eSpark-Backup/franciscogimenez-hcdshardware/Documents/Dev-Shared-Files/Optical-Sensor-PCB/Deliverables/Randring/Top View.png

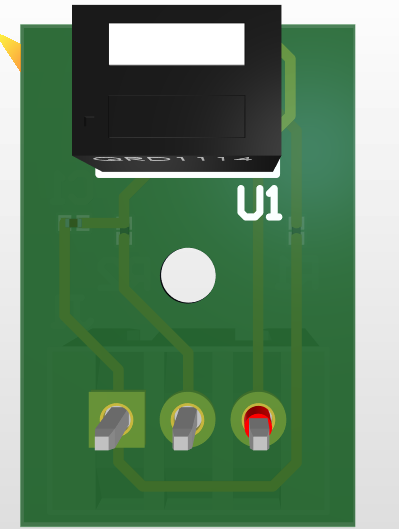
Documents/Dev-Shared-Files/Optical-Sensor-PCB/Deliverables/Randring/Top View.png
