eSpark-Backup/franciscogimenez-hcdshardware/README.md

# FranciscoGimenez-HCDS
 To interface and test various sensors and peripherals provided by the client with ESP32. To develop a Hair Color Dispensing Product.
