eSpark-Backup/franciscogimenez-hcdshardware/Design-Files/HCD_PCB.PcbDoc.htm

Reporting Options

# File in Previous Format

Date | : | 11/20/2021
Time | : | 1:56:20 AM
Filename | : | D:\Github\FranciscoGimenez-HCDSHardware\Design-Files\HCD_PCB.PcbDoc

Version | Warning

This file was generated by an earlier version of the software
