eSpark-Backup/franciscogimenez-hcdshardware/Documents/Client-Shared-Files/ESPProject_updated/Specs for  Firmware.docx

GENERAL PROJECT DESCRIPTION:

The purpose of the device is to dispense and measure with a scale different ingredients. The device will have 11 different cartridges loaded into a rotating tray that moves using a stepper motor so that the right cartridge can be positioned above a scale. The cartridges loaded into this rotating tray are activated by a pin that moves horizontally and powered by a servo motor. The load sensor/scale measures the weight of the product being dispensed and controls the servo motor movement and therefore the force applied to the cartridge to regulate the dispensing flow rate depending on the desired weight of such specific ingredient. Each cartridge has an RFID tag for identification.

The rotating tray that holds the cartridges has a light colored stripe for each cartridge position. In order for the pin to precisely activate the cartridge the light colored stripe needs to align with a stationary optical sensor. This way the stepper motor that controls the rotation of the tray can make sure the tray is in the perfect position before activating the servo motor that pushes the pin to activate the dispensing.

There needs to be a function to index the ingredients loaded into the rotating tray. Each cap of the cartridge has an RFID tag indicating the ingredient type from (1-11). In close proximity there is an RFID reader that will retrieve the data from the tags contained in each cartridge. The position of such each ingredient will be determined by reading the tags and keeping a record of the position in degrees (0-360)

Separately, there is a second RFID reader located nearby the scale that will help insure that the dispensing only happens when there is a container present that has also the appropriate RFID tag.

The device will have an LCD touchscreen for interaction but it should also be controllable with an external mobile app. The device will also need to be able to connect to a Wifi network to be able to pass reports to be stored in the cloud.

The device also has an LED strip to be able to light the interior of the dispensing area and change color dynamically. For example, glow red/orange while dispensing and green or white when dispensing is finished.

The device will also have a microphone and speaker. The speaker could augment the user experience by beeping for different reasons. For example, after it's done dispensing.

Eventually there is the potential of leveraging Amazon’s AWS Lexa service to build into the device the capability of being voice activated. This part will require a live web conexion and there needs to be enough memory built-in to store a few seconds of speech before submitting a query to the web.

The device should be able to take 220/110 V to be able to work in Europe/Asia and the US. It will also need to be able to run on a rechargeable battery.

CAD drawings for the device have been already created. This project consists in dealing with the electronics components that operate the device.

SPECIFIC REQUEST FOR REGARDING ELECTRICAL ENGINEERING FOR THIS

PROJECT

Create the firmware to Perform Basic Operations as described below.

PRESELECTED COMPONENTS:

Below is the list of electronic components preselected for this project (details in Appendix A):

1. Microcontroller with Wi-Fi / Bluetooth Module
2. Power Supply / Battery Pack
3. LCD Touchscreen
4. Load Cell (Scale) and Amplifier (HX711 )
5. Stepper Motor and Micro stepper Controller (A4988 )
6. Servo motor
7. Speaker and Amplifier (LM386 )
8. RFID Reader (MFRC-522)
9. Optical Sensor
10. Microphone
11. LED Strip
12. Battery/Battery Balancer

Many of these components have been already specified in the previous PCB board design rather than as separate modular components.

For safety and for ease of certification (UL, CE, etc), it has been determined that the battery balancer should not be integrated into the PCB board but bought and included as a separate system.

BASIC OPERATIONS:

1. INDEXING. Create a function that Identifies the position (degrees 0-360) of the rotating tray based on the RFID tags of the cartridges and the optical sensor.
2. ROTATION. Create a function that allows you to enter in the number of degrees to rotate the tray and then activate the stepper motor to rotate the tray accordingly. Positive degrees would be for a clockwise (CW) rotation and negative numbers would be for a counter-clockwise (CCW) rotation.
3. PUSH PIN. Create a function that controls the movement of push that activates the cartridges.

This is done mechanically by the rotation of the servo that gets transferred into a linear motion.

4. WEIGHT FUNCTION. Create a scale function that receives weight signals from the load cell and displays them. Enable a tare function to account for the weight of the container above the load cell.
5. WRITE RFID. Create a function to write the RFID tags of the cartridges to allows to name each ingredient by name (i.e. Ingredient 1, Ingredient 2, etc) and quantity supplied.
6. READ RFID. Create a function to read the RFID tags and create an index of the ingredients number and its position in the tray. For example, the Index should be (Position 1 = Ingredient 3; Position 2 = Ingredient 2, etc, etc).
7. LIGHT FUNCTION. Create a function to control the LED strip. From color to duration of time lit.
8. CONTAINER RFID. Detect the presence of a container in the dispensing area (above the scale).
9. DISPENSE FUNCTION. Enter a desired target weight and ingredient number, rotate the tray to the correct dispensing position, set the scale to zero (tare), activate the servo motor of the actuator and stop it once the weight dispensed matches the weight in the input. Make a bip sound once complete. Ensure that no dispensing happens if the container is not present.
10. A version of point 10 but where the control happens from an mobile app and through a bluetooth connection.
11. A function that reports to the cloud the activity of the machine via a wifi connection.
12. UPDATE. Ability to perform over-the-air firmware updates.

# APPENDIX A

Detailed List of Components

Component | Details
Controller | https://www.amazon.com/HiLetgo-ESP-WROOM-32-Developm ent-Microcontroller-Integrated/dp/B0718T232Z (https://www.amazon.com/HiLetgo-ESP-WROOM-32-Development-Microcontroller-Integrated/dp/B0718T232Z)
LCD Touchscreen | 4.3”: https://www.aliexpress.com/item/4000450731303.html?spm=a 2g0o.productlist.0.0.3da22136zIOfG6 (https://www.aliexpress.com/item/4000450731303.html)
Load Cell (Measuring Weight) | 500 grams: https://www.alibaba.com/product-detail/100g-300g-500g-750gminiature-parallel_60666665767.html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 (https://www.alibaba.com/product-detail/100g-300g-500g-750g-miniature-parallel_60666665767.html)ist.0.0.476e6cfeo5HiHu (https://www.alibaba.com/product-detail/100g-300g-500g-750g-miniature-parallel_60666665767.html) (https://www.alibaba.com/product-detail/100g-300g-500g-750g-miniature-parallel_60666665767.html) Load Cell amplifier: https://www.aliexpress.com/item/32883776006.html?spm=a2g 0o.productlist.0.0.43a949beDLp4Ob (https://www.aliexpress.com/item/32883776006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
Stepper Motor (Rotating the Tray) Controlling | Stepper: https://www.aliexpress.com/item/32665922113.html?spm=a2g 0o.productlist.0.0.2b1f30acFWCy7A (https://www.aliexpress.com/item/32665922113.html) (https://www.aliexpress.com/item/32665922113.html)Micro controller for: https://www.aliexpress.com/item/32965199683.html?spm=a2g 0o.productlist.0.0.267569c6dTM09J (https://www.aliexpress.com/item/32965199683.html?spm=a2g0o.productlist.0.0.267569c6dTM09J)
Servo | https://www.alibaba.com/product-detail/DS3218MG-20KG-Wat erproof-Large-Torque-High_62237690585.html (https://www.alibaba.com/product-detail/DS3218MG-20KG-Waterproof-Large-Torque-High_62237690585.html) (https://www.alibaba.com/product-detail/DS3218MG-20KG-Waterproof-Large-Torque-High_62237690585.html)
Speaker (Sound Communication) | Speaker:

| https://www.aliexpress.com/item/33014725969.html?spm=a2g 0o.productlist.0.0.eb482789MwjQHn (https://www.aliexpress.com/item/33014725969.html) Amplifier: https://www.aliexpress.com/item/4000232274017.html?spm=a 2g0o.productlist.0.0.7d2e7e22AxVb64 (https://www.aliexpress.com/item/4000232274017.html) (https://www.aliexpress.com/item/4000232274017.html)
Optical Sensor (Rotating Tray Position) | https://www.sparkfun.com/datasheets/BOT/QRD1 114.pdf (https://www.sparkfun.com/datasheets/BOT/QRD1114.pdf)
RFID Reader 2x (Identify Cartridges) (Receptacle Sensor) | https://www.aliexpress.com/item/2026446641.html?spm=a2g0 o.productlist.0.0.562052630OgIg8 (https://www.aliexpress.com/item/2026446641.html) (https://www.aliexpress.com/item/2026446641.html)
Sound Sensor (Microphone) Sound Sensor | https://www.aliexpress.com/item/32676696291.html?spm=a2g0o .productlist.0.0.3cfa751beddDXc (https://www.aliexpress.com/item/32676696291.html)
Battery: (To confirm final capacity and specs based on further analysis) | Battery: https://www.alibaba.com/product-detail/2200mAh-3 S-25C-Lipo-Pack_62061430079.html or https://www.amazon.com/Gens-ace-Battery-2200m Ah-Airplane/dp/B00WJN4LG0/ref=sr_1_6 Balancer: https://www.aliexpress.com/item/4000785403888.html?spm=a2g 0o.productlist.0.0.f59c67deehvNsY (https://www.aliexpress.com/item/4000785403888.html?spm=a2g0o.productlist.0.0.f59c67deehvNsY) Or
| https://www.amazon.com/11-1V-12-6V-Balance-Bat er%C3%ADa-Protecci%C3%B3n/dp/B07JMY631D/ (https://www.amazon.com/11-1V-12-6V-Balance-Bater%C3%ADa-Protecci%C3%B3n/dp/B07JMY631D)ref=sr_1_1?crid=2RRWIV3KTM23M (https://www.amazon.com/11-1V-12-6V-Balance-Bater%C3%ADa-Protecci%C3%B3n/dp/B07JMY631D)
Power Switch (On/off) | https://www.aliexpress.com/item/4000498062517.ht ml?spm=a2g0o.productlist.0.0.69384c247Y0dyb (https://www.aliexpress.com/item/4000498062517.html?spm=a2g0o.productlist.0.0.69384c247Y0dyb) (https://www.aliexpress.com/item/4000498062517.html?spm=a2g0o.productlist.0.0.69384c247Y0dyb)
LED Strip | https://www.aliexpress.com/item/2036819167.html? spm=a2g0o.productlist.0.0.719c1cbfZYLGJI (https://www.aliexpress.com/item/2036819167.html?spm=a2g0o.productlist.0.0.719c1cbfZYLGJI) (https://www.aliexpress.com/item/2036819167.html?spm=a2g0o.productlist.0.0.719c1cbfZYLGJI)
