eSpark-Backup/franciscogimenez-hcdshardware/Documents/Deliverables/Rendering/2D_BottomView.PNG

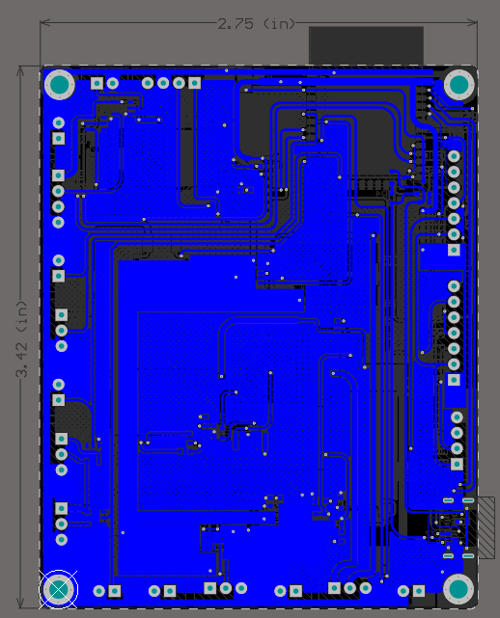
Documents/Deliverables/Rendering/2D_BottomView.PNG
