eSpark-Backup/franciscogimenez-hcdshardware/Documents/Deliverables/Rendering/2D_TopView.PNG

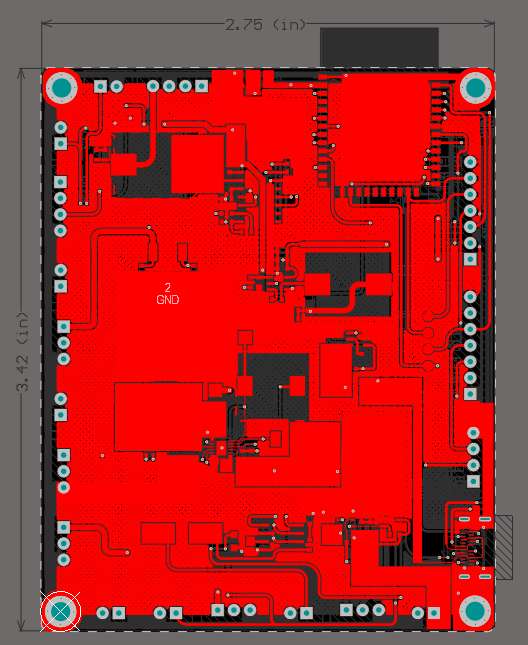
Documents/Deliverables/Rendering/2D_TopView.PNG
