eSpark-Backup/franciscogimenez-hcdshardware/Documents/Deliverables/Rendering/3D_BottomView.PNG

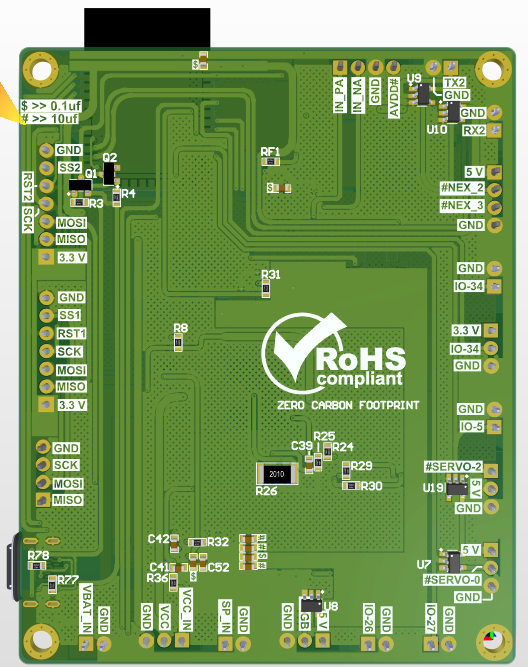
Documents/Deliverables/Rendering/3D_BottomView.PNG
