eSpark-Backup/franciscogimenez-hcdshardware/Documents/Deliverables/Rendering/3D_IsometricView.PNG

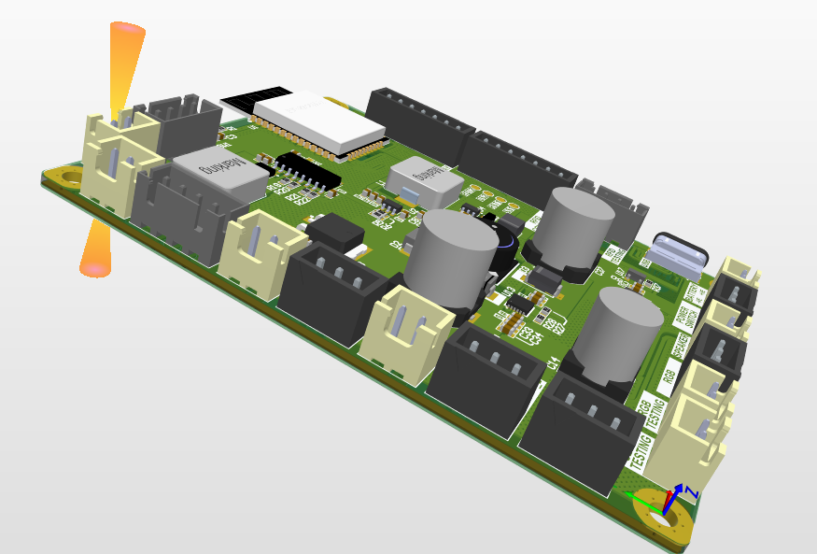
Documents/Deliverables/Rendering/3D_IsometricView.PNG
