eSpark-Backup/franciscogimenez-hcdshardware/Documents/Deliverables/Rendering/3D_TopView.PNG

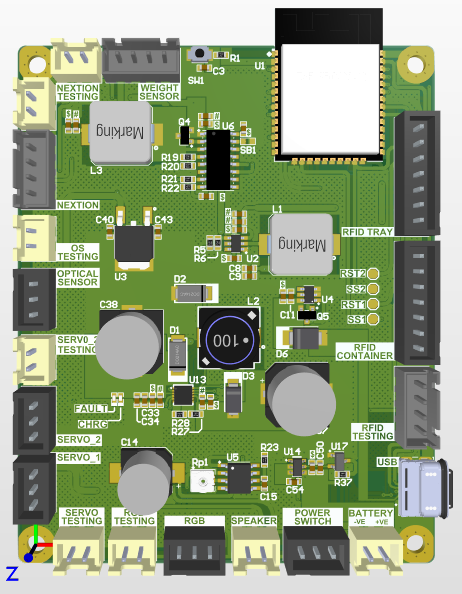
Documents/Deliverables/Rendering/3D_TopView.PNG
