eSpark-Backup/franciscogimenez-hcdshardware/Documents/Deliverables_OB/Randring/Isometric View.png

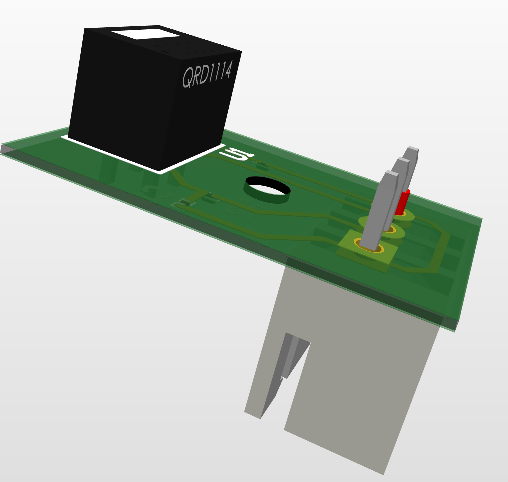
Documents/Deliverables_OB/Randring/Isometric View.png
