eSpark-Backup/franciscogimenez-hcdshardware/Documents/Deliverables_PB/Renderings/2D_BottomView.PNG

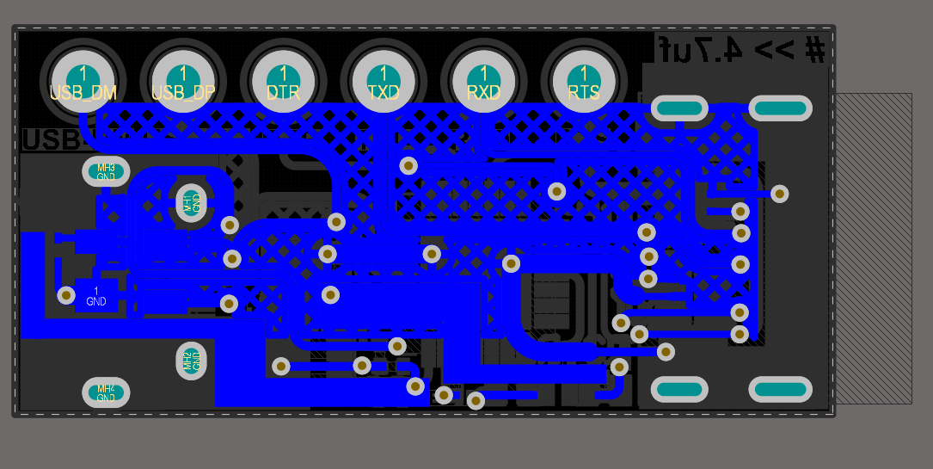
Documents/Deliverables_PB/Renderings/2D_BottomView.PNG
