eSpark-Backup/franciscogimenez-hcdshardware/Documents/Deliverables_PB/Renderings/2D_TopView.PNG

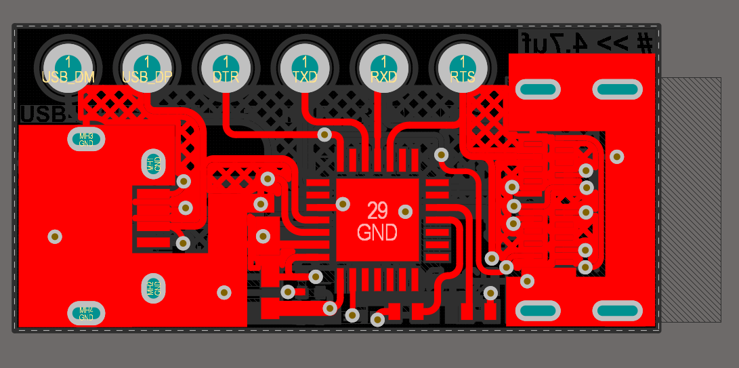
Documents/Deliverables_PB/Renderings/2D_TopView.PNG
