eSpark-Backup/franciscogimenez-hcdshardware/Documents/Deliverables_PB/Renderings/3D_BottomView.PNG

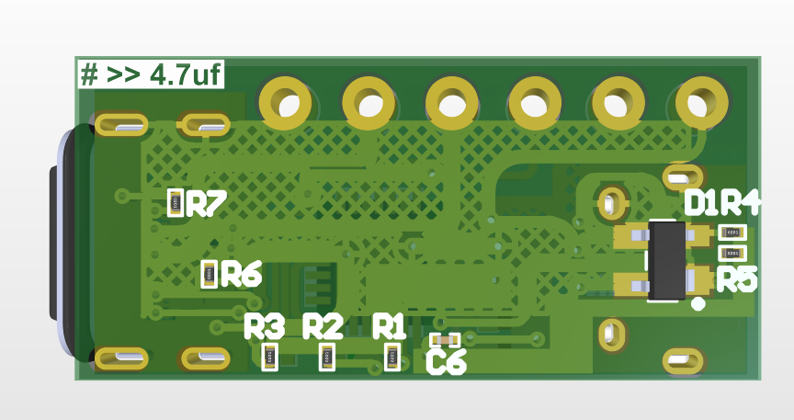
Documents/Deliverables_PB/Renderings/3D_BottomView.PNG
