eSpark-Backup/franciscogimenez-hcdshardware/Documents/Deliverables_PB/Renderings/3D_IsometricView.PNG

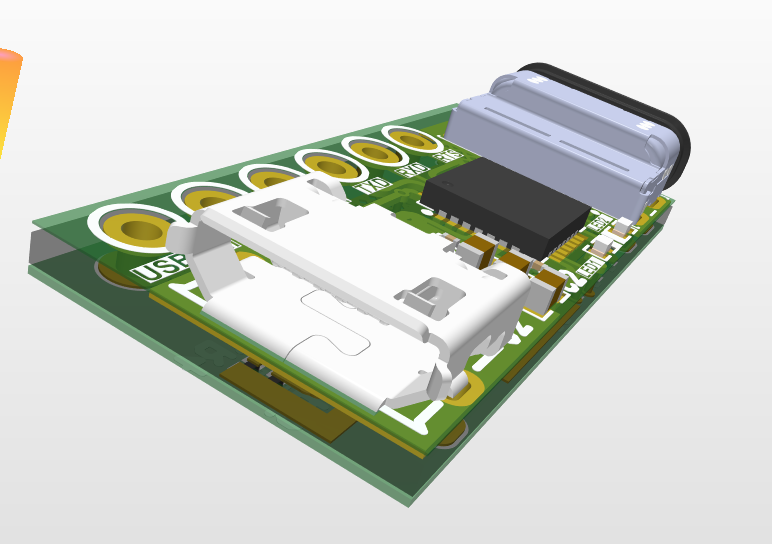
Documents/Deliverables_PB/Renderings/3D_IsometricView.PNG
