eSpark-Backup/franciscogimenez-hcdshardware/Documents/Deliverables_PB/Renderings/3D_TopView.PNG

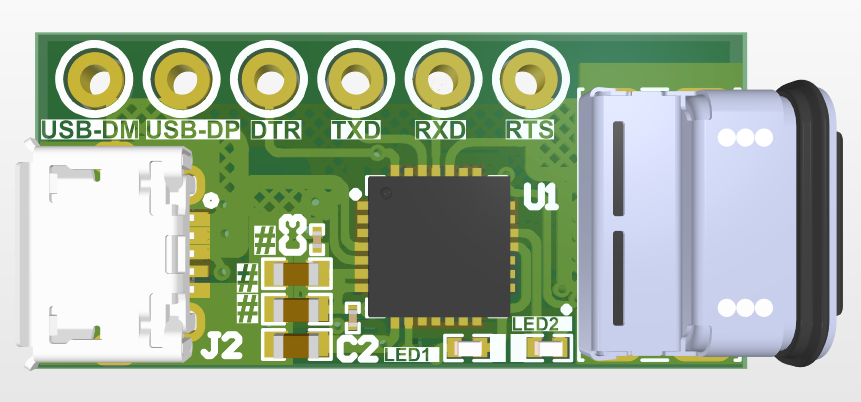
Documents/Deliverables_PB/Renderings/3D_TopView.PNG
