eSpark-Backup/franciscogimenez-hcdshardware/Documents/Deliverables/BOM/BOM_PCBWay.xlsx

Bill of Material (BOM) for Francisco Gimenez
S. No. | Components | Description | Designator | Footprint (Package) | LCSC Part No | Value | LCSC/MOQ | Quantity (Per Board) | Quantity (5 boards)
1 | Capacitors | CAP CER 0.1UF 50V X7R 0603 | C1, C6, C7, C12, C17, C18, C21, C32, C36, C51, C53, C55, CF1, CF3 | CAP-0603 | C913912 | 0.1uF | 50 | 14 | 100
2 |  | CAP CER 1UF 25V X5R 0603 | C3, C11, C39, C41, C43, C50, C52 | CAP-0603 | C5673 | 1uF | 50 | 7 | 35
3 |  | CAP CER 10UF 25V X5R 0603 | C4, C5, C13, C16, C19, C20, C31, C35, CF2 | CAP-0603 | C386081 | 10uF | 10 | 9 | 50
4 |  | CAP CER 22UF 16V X5R 0603 | C8, C9 | CAP-0603 | C84419 | 22uF | 10 | 2 | 20
5 |  | CAP CER 10PF 50V C0G/NP0 0603 | C15 | CAP-0603 | C106245 | 10pF | 50 | 1 | 5
6 |  | CAP CER 4.7UF 25V X5R 0603 | C33, C34 | CAP-0603 | C69335 | 4.7uF | 20 | 2 | 10
7 |  | CAP ALUM 100UF 20% 25V SMD | C14 | Custom | C125982 | 100uF | 5 | 1 | 10
8 |  | CAP ALUM 470UF 20% 25V SMD | C37, C38 | Custom | C249933 | 470uF | 1 | 2 | 12
9 |  | CAP CER 2.2UF 25V X5R 0603 | C40 | CAP-0603 | C309478 | 2.2uF | 20 | 1 | 20
10 |  | CAP CER 1000PF 25V C0G/NPO 0603 | C42, C54 | CAP-0603 | C163170 | 1nF | 100 | 2 | 10
11 | Diode | DIODE SCHOTTKY 40V 3A SMA | D1, D2 | DO-214AC | C85098 | - | 5 | 2 | 15
12 |  | DIODE GEN PURP 50V 1A SMA | D3 | SMA | C150735 | - | 10 | 1 | 5
13 |  | LED GREEN CLEAR CHIP SMD | D4, D5 | LED 0402 | C434446 | - | 50 | 2 | 10
14 |  | DIODE SCHOTTKY 5A 40V SMB | D6 | SMB | C32513 | - | 10 | 1 | 5
15 |  | FIXED IND 10UH 2.5A 43.7 MOHM | L2 | Custom | C96116 | 10uH | 1 | 1 | 5
16 | Transistor | TRANS NPN 40V 0.6A SMD SOT23-3 | Q1, Q2 | SOT-23 | C94515 | - | 50 | 2 | 10
17 |  | MOSFET P-CH 12V 2.6A SUPERSOT3 | Q5 | SuperSOT-3 | C154510 | - | 1 | 1 | 6
18 |  | TRANS PNP 40V 600MA SOT23-3 | Q4 | SOT-23 | C75556 | - | 50 | 1 | 5
19 | Resistors | RES SMD 10K OHM 5% 1/5W 0603 | R1, R3, R4, R6, R31, R32, RF1 | RES-0603 | C161787 | 10K | 10 | 7 | 40
20 |  | RES SMD 54.9K OHM 1% 1/10W 0603 | R5 | RES-0603 | C185321 | 54.9K | 100 | 1 | 5
21 |  | RES SMD 470K OHM 5% 1/10W 0603 | R8 | RES-0603 | C144601 | 470K | 100 | 1 | 5
22 |  | RES SMD 100K OHM 5% 1/5W 0603 | R25, R36, R37 | RES-0603 | C491207 | 100K | 20 | 3 | 15
23 |  | RES SMD 20K OHM 1% 1/4W 0603 | R19 | RES-0603 | C105575 | 20K | 100 | 1 | 5
24 |  | RES SMD 8.2K OHM 5% 1/4W 0603 | R20 | RES-0603 | C445835 | 8.2K | 20 | 1 | 5
25 |  | RES SMD 100 OHM 1% 1/4W 0603 | R21, R22, R23 | RES-0603 | C491196 | 100R | 20 | 3 | 15
26 |  | RES SMD 301K OHM 1% 1/10W 0603 | R24 | RES-0603 | C23026 | 301k | 100 | 1 | 5
27 |  | RES 0.05 OHM 1% 1/2W 2010 | R26 | RES 2010 | C309643 | 0.05R | 10 | 1 | 5
28 |  | RES SMD 536K OHM 1% 1/10W 0603 | R27 | RES-0603 | C23200 | 536K | 100 | 1 | 5
29 |  | RES SMD 453K OHM 1% 1/10W 0603 | R28 | RES-0603 | C25818 | 453K | 100 | 1 | 5
30 |  | RES 5.1K OHM 1% 1/10W 0603 | R29, R30, R77, R78 | RES-0603 | C156350 | 5.1K | 100 | 4 | 20
31 | Switch | SWITCH TACTILE SPST-NO 0.05A 12V | SW1 | Custom | C231329 | - | 1 | 1 | 5
32 | ICS | RX TXRX MOD WIFI SURFACE MOUNT | U1 | Custom | C529577 | - | 1 | 1 | 5
33 |  | IC OR CTRLR SRC SELECT TSOT23-6 | U4 | TSOT-23-6 | C521306 | - | 1 | 1 | 5
34 |  | IC AMP AUDIO PWR .325W AB 8SOIC | U5 | 8SOIC | C23573 | - | 1 | 1 | 5
35 |  | LOAD CELL AMP HX711 | U6 | SOP-16 | C43656 | - | 1 | 1 | 5
36 |  | IC BUF NON-INVERT 5.5V SOT23-5 | U7, U8, U9, U10, U19 | SOT-23-5 | C100024 | - | 1 | 5 | 25
37 |  | IC PWR SWITCH P-CHAN 1:1 6TSOP | U14 | 6-TSOP | C141534 | - | 1 | 1 | 5
38 | Connectors | CONN HEADER VERT 2POS 2.5MM | J1, J3, J24, J25, J26, J27, J28, J29 | Custom | C158012 | - | 20 | 8 | 40
39 |  | CONN HEADER VERT 4POS 2.5MM | J2, J12, J17 | Custom | C144395 | - | 1 | 3 | 15
40 |  | CONN HEADER VERT 3POS 2.5MM | J10, J11, J13, J20, J30 | Custom | C144394 | - | 10 | 5 | 30
41 |  | CONN HEADER VERT 7POS 2.5MM | J14, J15 | Custom | C144398 | - | 5 | 2 | 10
42 |  | CONN RCP USB3.1 TYPEC 24P SMD RA | J16 | Custom | C498674 | - | 1 | 1 | 5
