eSpark-Backup/franciscogimenez-hcdshardware/Documents/Deliverables/BOM/Digikey_BOM.xlsx

Bill of Material (BOM) for Francisco Gimenez
S. No. | Components | Description | Designator | Footprint (Package) | Manufacturer Part Number | Manufacturer | Alternate | Value | Quantity (Per Board) | Quantity 5 | DigiKey Link | Unit Cost(1) | Total Cost(1) | Unit Cost (5 Boards) | Total Cost (5) | Remarks
1 | Capacitors | CAP CER 0.1UF 50V X7R 0603 | C1, C11, C13, C14, C15, C17, C21, C32, C36, C51, C53, CF1, CF3 | CAP-0603 | CL10B104KB8NNNL | Samsung Electro-Mechanics (https://lcsc.com/brand-detail/254.html) | --------------- | 0.1uF | 13 | 65 | Digikey (https://www.digikey.com/en/products/detail/samsung-electro-mechanics/CL10B104KB8NNNL/3894274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) | $0.0300 | $0.39 | $0.0166 | $1.08
2 |  | CAP CER 1UF 25V X5R 0603 | C3, C11, C39, C50, C52, CF1. CF3 | CAP-0603 | CL10A105KA8NNNC | Samsung Electro-Mechanics (https://lcsc.com/brand-detail/254.html) | --------------- | 1uF | 7 | 35 | Digikey (https://www.digikey.com/en/products/detail/samsung-electro-mechanics/CL10A105KA8NNNC/3886760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) | $0.1000 | $0.70 | $0.0350 | $1.23
 |  | CAP CER 2.2UF 25V X5R 0603 | C5 | CAP-0603 | CC0603KRX5R8BB225 | Yageo | --------------- | 2.2uF | 1 | 5 | DigiKey (https://www.digikey.com/en/products/detail/yageo/CC0603KRX5R8BB225/5195194) | $0.4000 | $0.40 | $0.4000 | $2.00
3 |  | CAP CER 10UF 25V X5R 0603 | C6, C7, C12, C31, C35, CF2 | CAP-0603 | TMK107BBJ106MA-T | Taiyo Yuden (https://lcsc.com/brand-detail/392.html) | GRM188R61E106MA73J | 10uF | 6 | 30 | Digikey (https://www.digikey.com/en/products/detail/murata-electronics/GRM188R61E106MA73J/4905347) | $0.3600 | $2.16 | $0.2460 | $7.38
6 |  | CAP CER 4.7UF 25V X5R 0603 | C33, C34 | CAP-0603 | CL10A475KA8NQNC | Samsung Electro-Mechanics (https://lcsc.com/brand-detail/254.html) | --------------- | 4.7uF | 2 | 10 | Digikey (https://www.digikey.com/en/products/detail/samsung-electro-mechanics/CL10A475KA8NQNC/3887558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) | $0.3900 | $0.78 | $0.2700 | $2.70
7 |  | CAP ALUM 100UF 20% 25V SMD | C42, C54 | Custom | UWX1E101MCL1GB | Nichicon (https://lcsc.com/brand-detail/994.html) | --------------- | 100uF | 2 | 10 | Digikey (https://www.digikey.com/en/products/detail/nichicon/UWX1E101MCL1GB/589854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) | $0.5000 | $1.00 | $0.3480 | $3.48
8 |  | CAP ALUM 470UF 20% 25V SMD | C37, C38 | Custom | UCD1E471MNL1GS | Nichicon (https://lcsc.com/brand-detail/994.html) | EXV477M025A9PAA | 470uF | 2 | 10 | Digikey (https://www.digikey.com/en/products/detail/kemet/EXV477M025A9PAA/7319818) | $0.9700 | $1.94 | $0.7390 | $7.39
10 | Diode | DIODE SCHOTTKY 40V 3A SMA | D1, D2 | DO-214AC | CMSH3-40MA TR13 PBFREE | Central Semiconductor Corp (https://www.digikey.com/en/supplier-centers/central-semiconductor) | --------------- | - | 2 | 10 | Digikey (https://www.digikey.com/en/products/detail/central-semiconductor-corp/CMSH3-40MA-TR13-PBFREE/4897045) | $0.6700 | $1.34 | $0.5920 | $5.92
11 |  | DIODE GEN PURP 50V 1A SMA | D3 | SMA | S1A-13-F | Diodes Incorporated (https://lcsc.com/brand-detail/296.html) | --------------- | - | 1 | 5 | Digikey (https://www.digikey.com/en/products/detail/diodes-incorporated/S1A-13-F/749977) | $0.2700 | $0.27 | $0.2600 | $1.30
12 |  | LED GREEN CLEAR CHIP SMD | D4, D5 | LED 0402 | XZVG68W-2 | SunLED (https://www.digikey.com/en/supplier-centers/sunled) | --------------- | - | 2 | 10 | Digikey (https://www.digikey.com/en/products/detail/sunled/XZVG68W-2/4745975?s=N4IgTCBcDaIBoC0BqBxAbADgOoFoIF0BfIA) | $0.3700 | $0.74 | $0.2930 | $2.93
13 |  | DIODE SCHOTTKY 5A 40V SMB | D6 | SMB | SS54B-HF | Comchip Technology | --------------- | - | 1 | 5 | Mouser (https://eu.mouser.com/ProductDetail/Comchip-Technology/SS54B-HF) | $0.4440 | $0.44 | $0.4440 | $2.22
 | LED | Yellow 2 x 1.25 x 1.1 mm 130° Water Clear 112 mcd 1.8 V LED Surface Mount | LED1 | LED 0805 | LTST-C170KSKT | Vishay Lite-On | --------------- | - | 1 | 5 | DigiKey (https://www.digikey.com/en/products/detail/lite-on-inc/LTST-C170KSKT/386781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) | $0.3100 | $0.31 | $0.3100 | $1.55
 |  | LED BLUE 0805 SMD | LED2 | LED 0805 | 17-21/BHC-XL2M2TY/3T | Everlight Elec | --------------- | - | 1 | 5 | Custom Supplier | $0.2560 | $0.26 | $0.2560 | $1.28
 |  | LED GREEN 574nm 2-Pin Chip 0805 SMD | LED3 | LED 0805 | LTST-C171KGKT | Vishay Lite-On | --------------- | - | 1 | 5 | DigiKey | $0.2800 | $0.28 | $0.2800 | $1.40
14 | Inductor | FIXED IND 3.3UH 8A 11.8 MOHM SMD | L1 | Custom | 74437368033 | Würth Elektronik (https://www.digikey.com/en/supplier-centers/wurth-electronics) | --------------- | 3.3uH | 1 | 5 | Digikey (https://www.digikey.com/en/products/detail/w%C3%BCrth-elektronik/74437368033/2791109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) | $2.4100 | $2.41 | $2.4100 | $12.05
15 |  | FIXED IND 10UH 2.5A 43.7 MOHM | L2 | Custom | SLF10145T-100M2R5-PF | TDK Corporation (https://www.digikey.com/en/supplier-centers/tdk) | --------------- | 10uH | 1 | 5 | Digikey (https://www.digikey.com/en/products/detail/tdk-corporation/SLF10145T-100M2R5-PF/755327) | $1.0500 | $1.05 | $1.0500 | $5.25
16 | Transistor | TRANS NPN 40V 0.6A SMD SOT23-3 | Q1, Q2 | SOT-23 | MMBT2222A-7-F | Diodes Incorporated (https://lcsc.com/brand-detail/296.html) | --------------- | - | 2 | 10 | Digikey (https://www.digikey.com/en/products/detail/diodes-incorporated/MMBT2222A-7-F/814503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) | $0.1400 | $0.28 | $0.1250 | $1.25
17 |  | MOSFET P-CH 12V 2.6A SUPERSOT3 | Q4 | SuperSOT-3 | FDN306P | ON Semiconductor | --------------- | - | 1 | 5 | Digikey (https://www.digikey.com/en/products/detail/on-semiconductor/FDN306P/965300?s=N4IgTCBcDaIGIBEByBmADANgAogLoF8g) | $0.5000 | $0.50 | $0.5000 | $2.50
18 |  | TRANS PNP 40V 600MA SOT23-3 | Q3 | SOT-23 | MMBT4403LT1G | ON Semiconductor (https://lcsc.com/brand-detail/94.html) | --------------- | - | 1 | 5 | Digikey (https://www.digikey.com/en/products/detail/on-semiconductor/MMBT4403LT1G/919609) | $0.1400 | $0.14 | $0.1400 | $0.70
19 | Resistors | RES SMD 10K OHM 5% 1/5W 0603 | R3, R4, R11, R12, R13, R32, RF1 | RES-0603 | CRGH0603J10K | TE Connectivity Passive Product (https://www.digikey.com/en/supplier-centers/te-connectivity-amp) | --------------- | 10K | 7 | 35 | Digikey (https://www.digikey.com/en/products/detail/te-connectivity-passive-product/CRGH0603J10K/2385379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) | $0.1000 | $0.70 | $0.0580 | $2.03
20 |  | RES SMD 54.9K OHM 1% 1/10W 0603 | R8 | RES-0603 | RC0603FR-0754K9L | YAGEO (https://lcsc.com/brand-detail/396.html) | --------------- | 54.9K | 1 | 5 | Digikey (https://www.digikey.com/en/products/detail/yageo/RC0603FR-0754K9L/727298) | $0.1000 | $0.10 | $0.1000 | $0.50
21 |  | RES SMD 470K OHM 5% 1/10W 0603 | R14 | RES-0603 | AC0603JR-07470KL | YAGEO (https://lcsc.com/brand-detail/396.html) | --------------- | 470K | 1 | 5 | Digikey (https://www.digikey.com/en/products/detail/yageo/AC0603JR-07470KL/5896462) | $0.1000 | $0.10 | $0.1000 | $0.50
 |  | RES 0.1W, 470½, 0.1%, 0603, RoHS | R16 | RES-0603 | ERA3VEB4700V | Panasonic | --------------- | 470R | 1 | 5 | DigiKey (https://www.digikey.com/en/products/detail/panasonic-electronic-components/ERA-3VEB4700V/12085013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) | $0.6100 | $0.61 | $0.6100 | $3.05
22 |  | RES SMD 100K OHM 5% 1/5W 0603 | R6, R36, R37 | RES-0603 | CRGH0603J100K | TE Connectivity Passive Product (https://www.digikey.com/en/supplier-centers/te-connectivity-amp) | --------------- | 100K | 3 | 15 | Digikey (https://www.digikey.com/en/products/detail/te-connectivity-passive-product/CRGH0603J100K/2385403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) | $0.1000 | $0.30 | $0.0490 | $0.73
23 |  | RES SMD 20K OHM 1% 1/4W 0603 | R2 | RES-0603 | ESR03EZPF2002 | Rohm Semiconductor (https://www.digikey.com/en/supplier-centers/rohm-semi) | --------------- | 20K | 1 | 5 | Digikey (https://www.digikey.com/en/products/detail/rohm-semiconductor/ESR03EZPF2002/1983437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) | $0.1300 | $0.13 | $0.1300 | $0.65
24 |  | RES SMD 8.2K OHM 5% 1/4W 0603 | R7 | RES-0603 | ERJ-PA3J822V | Panasonic Electronic Components (https://www.digikey.com/en/supplier-centers/panasonic) | --------------- | 8.2K | 1 | 5 | Digikey (https://www.digikey.com/en/products/detail/panasonic-electronic-components/ERJ-PA3J822V/5036103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) | $0.1000 | $0.10 | $0.1000 | $0.50
25 |  | RES SMD 100 OHM 1% 1/4W 0603 | R1, R9, R10, R15 | RES-0603 | RCA0603100RFKEAHP | Vishay Dale (https://www.digikey.com/en/supplier-centers/vishay-dale) | --------------- | 100R | 4 | 20 | Digikey (https://www.digikey.com/en/products/detail/vishay-dale/RCA0603100RFKEAHP/6561241) | $0.2400 | $0.96 | $0.2050 | $4.10
26 |  | RES SMD 301K OHM 1% 1/10W 0603 | R5 | RES-0603 | CRCW0603301KFKEB | Vishay Dale (https://www.digikey.com/en/supplier-centers/vishay-dale) | --------------- | 301k | 1 | 5 | Digikey (https://www.digikey.com/en/products/detail/vishay-dale/CRCW0603301KFKEB/5072030) | $0.1000 | $0.10 | $0.1000 | $0.50
27 |  | RES 0.05 OHM 1% 1/2W 2010 | R26 | RES 2010 | WSL2010R0500FEA | Vishay Dale | --------------- | 0.05R | 1 | 5 | Digikey (https://www.digikey.com/en/products/detail/vishay-dale/WSL2010R0500FEA/712531) | $0.9200 | $0.92 | $0.9200 | $4.60
28 |  | RES SMD 536K OHM 1% 1/10W 0603 | R27 | RES-0603 | CRCW0603536KFKEA | Vishay Dale (https://www.digikey.com/en/supplier-centers/vishay-dale) | --------------- | 536K | 1 | 5 | Digikey (https://www.digikey.com/en/products/detail/vishay-dale/CRCW0603536KFKEA/1174979) | $0.1000 | $0.10 | $0.1000 | $0.50
29 |  | RES SMD 453K OHM 1% 1/10W 0603 | R28 | RES-0603 | RC0603FR-07453KL | Yageo (https://www.digikey.com/en/supplier-centers/yageo) | --------------- | 453K | 1 | 5 | Digikey (https://www.digikey.com/en/products/detail/yageo/RC0603FR-07453KL/727247) | $0.1000 | $0.10 | $0.1000 | $0.50
30 |  | RES 5.1K OHM 1% 1/10W 0603 | R29, R30, R77, R78 | RES-0603 | RMCF0603FT5K10 | Stackpole Electronics Inc (https://www.digikey.com/en/supplier-centers/stackpole-electronics) | --------------- | 5.1K | 4 | 20 | Digikey (https://www.digikey.com/en/products/detail/stackpole-electronics-inc/RMCF0603FT5K10/1760908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) | $0.1000 | $0.40 | $0.0170 | $0.34
32 | Switch | SWITCH TACTILE SPST-NO 0.05A 12V | SW1 | Custom | B3U-1000P | Omron Electronics Inc-EMC Div | --------------- | - | 1 | 5 | Digikey (https://www.digikey.com/en/products/detail/omron-electronics-inc-emc-div/B3U-1000P/1534338) | $0.9300 | $0.93 | $0.9300 | $4.65
33 | ICS | RX TXRX MOD WIFI SURFACE MOUNT | U1 | Custom | ESP32-WROOM-32D (8MB) | Espressif Systems (https://lcsc.com/brand-detail/877.html) | --------------- | - | 1 | 5 | Digikey (https://www.digikey.com/en/products/detail/espressif-systems/ESP32-WROOM-32D-8MB/9381717) | $4.3500 | $4.35 | $4.3500 | $21.75
34 |  | IC REG BUCK ADJ 5A TSOT23-6 | U3 | SOT 23-6 | TPS565208DDCT | Texas Instruments (https://www.digikey.com/en/supplier-centers/texas-instruments) | --------------- | - | 1 | 5 | AliExpress (https://www.aliexpress.com/item/4000994283828.html) | $3.7100 | $3.71 | $3.7100 | $18.55
35 |  | IC REG LINEAR 3.3V 1A DPAK | U2 | DPAK | LDF33DT-TR | STMicroelectronics (https://www.digikey.com/en/supplier-centers/stmicroelectronics) | --------------- | - | 1 | 5 | Digikey (https://www.digikey.com/en/products/detail/stmicroelectronics/LDF33DT-TR/4841765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) | $0.9900 | $0.99 | $0.9900 | $4.95
36 |  | IC OR CTRLR SRC SELECT TSOT23-6 | U4 | TSOT-23-6 | LTC4412IS6#TRPBF | Analog Devices Inc. | --------------- |  | 1 | 5 | Digikey (https://www.digikey.com/en/products/detail/analog-devices-inc/LTC4412IS6-TRPBF/1746323) | $3.9000 | $3.90 | $3.9000 | $19.50
38 |  | LOAD CELL AMP HX711 | U6 | Custom | HX711 | Avia Semicon (Xiamen) (https://lcsc.com/brand-detail/756.html) | --------------- | - | 1 | 5 | Aliexpress (https://pl.aliexpress.com/item/32953466291.html) | $0.4660 | $0.47 | $0.4660 | $2.33
39 |  | IC BUF NON-INVERT 5.5V SOT23-5 | U7, U8, U19 | SOT-23-5 | SN74LV1T34DBVR | Texas Instruments (https://lcsc.com/brand-detail/100.html) | --------------- | - | 3 | 15 | Digikey (https://www.digikey.com/en/products/detail/texas-instruments/SN74LV1T34DBVR/4555575) | $0.5200 | $1.56 | $0.4230 | $6.34
40 |  | IC PWR SWITCH P-CHAN 1:1 6TSOP | U14 | 6-TSOP | SI3865DDV-T1-GE3 | Vishay Siliconix | --------------- |  | 1 | 5 | Digikey (https://www.digikey.com/en/products/detail/vishay-siliconix/SI3865DDV-T1-GE3/4563551) | $0.5800 | $0.58 | $0.5800 | $2.90
41 |  | IC SUPERVISOR 1 CHANNEL 3SSOP | U17 | SSOP-3 | BD48K50G-TL | Rohm Semiconductor | --------------- |  | 1 | 5 | Digikey (https://www.digikey.com/en/products/detail/rohm-semiconductor/BD48K50G-TL/3693306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) | $0.4800 | $0.48 | $0.4800 | $2.40
42 |  | IC SUPERVISOR 1 CHANNEL 3SSOP | U13 | 12DFN | LT3652EDD#PBF | Analog Devices Inc. (https://www.digikey.com/en/supplier-centers/analog-devices) | --------------- | - | 1 | 5 | Digikey (https://www.digikey.com/en/products/detail/analog-devices-inc/LT3652EDD-PBF/2138757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) | $7.3200 | $7.32 | $7.3200 | $36.60
43 | Connectors | CONN HEADER VERT 2POS 2.5MM | J3, J24, J25, J26, J27, J28, J29 | Custom | B2B-XH-A(LF)(SN) | JST Sales America (https://lcsc.com/brand-detail/853.html) | --------------- | - | 7 | 35 | Digikey (https://www.digikey.com/en/products/detail/jst-sales-america-inc/B2B-XH-A-LF-SN/1651045) | $0.1500 | $1.05 | $0.1410 | $4.93
44 |  | CONN HEADER VERT 4POS 2.5MM | J2, J17 | Custom | B4B-XH-A(LF)(SN) | JST Sales America (https://lcsc.com/brand-detail/853.html) | --------------- | - | 2 | 10 | Digikey (https://www.digikey.com/en/products/detail/jst-sales-america-inc/B4B-XH-A-LF-SN/1651047) | $0.2100 | $0.42 | $0.1940 | $1.94
45 |  | CONN HEADER VERT 3POS 2.5MM | J10, J11, J13, J20, J30 | Custom | B3B-XH-A(LF)(SN) | JST Sales America | --------------- | - | 5 | 25 | Arrow (https://www.arrow.com/en/products/b3b-xh-a-lf-sn/jst-manufacturing) | $0.1330 | $0.67 | $0.1330 | $3.33
46 |  | CONN HEADER VERT 7POS 2.5MM | J1, J14, J15 | Custom | B7B-XH-A(LF)(SN) | JST Sales America | --------------- | - | 3 | 15 | Digikey (https://www.digikey.com/en/products/detail/jst-sales-america-inc/B7B-XH-A-LF-SN/1651050) | $0.3300 | $0.99 | $0.3080 | $4.62
47 |  | CONN RCP USB3.1 TYPEC 24P SMD RA | J16 | Custom | 2305018-2 | TE Connectivity (https://lcsc.com/brand-detail/109.html) | --------------- | - | 1 | 5 | Digikey (https://www.digikey.com/en/products/detail/te-connectivity-amp-connectors/2305018-2/8680920) | $3.0000 | $3.00 | $3.0000 | $15.00
48 |  | ~~Solder Bridge ON~~ | ~~SB1~~ | ~~Custom~~ | ~~Solder Bridge~~ | ~~-------------~~ | ~~-------------~~ | ~~-------------~~ | ~~1~~ | 5 | ~~-------------~~ | ~~-------------~~ | ~~-------------~~ | ~~-------------~~ | ~~-------------~~ | ~~DO NOT Mount~~
49 |  | ~~Test Point ON~~ | ~~P1, P2, P3, P4~~ | ~~Custom~~ | ~~Test Point~~ | ~~-------------~~ | ~~-------------~~ | ~~-------------~~ | ~~4~~ | 20 | ~~-------------~~ | ~~-------------~~ | ~~-------------~~ | ~~-------------~~ | ~~-------------~~ | ~~DO NOT Mount~~
 |  |  |  |  |  |  |  |  | Total Component Cost |  |  |  |  |  | $231.90
 |  |  |  |  |  |  |  |  | Single Board Cost |  |  |  | $50.42 |  | $46.38
