eSpark-Backup/franciscogimenez-hcdshardware/Documents/Deliverables_OB/BOM/Digikey BOM.xlsx

Bill of Material (BOM) for Optical Sensor
S. No. | Comment Type | Description | Designator | Footprint (Package) | Manufacturer Part Number | Manufacturer | Alternate | Value | Quantity (Per Board) | Quantity 5 | DigiKey Link | Unit Cost(1) | Total Cost(1) | Unit Cost (5 Boards) | Total Cost (5) | Remarks
1 | Capacitor | CAP CER 10000PF 16V X5R 0201 | C1 | Cap 0201 | GRM033R61C103KA12D | Murata |  | 0.01uF | 1 | 5 | Digikey (https://www.digikey.nl/product-detail/en/murata-electronics/GRM033R61C103KA12D/490-7223-1-ND/4213381) | $0.10 | $0.10 | $0.10 | $0.50
2 | Resistor | Res Thick Film 0201 470 Ohm 5% 0.05W(1/20W) ±200ppm/C Molded SMD Paper T/R | R1 | Res-0201 | RC0201JR-07470RL | Yageo |  | 470R | 1 | 5 | Digikey (https://www.digikey.nl/product-detail/en/yageo/RC0201JR-07470RL/311-470NCT-ND/1949059) | $0.10 | $0.10 | $0.10 | $0.50
3 |  | Res Thick Film 0201 220 Ohm 1% 1/20W ±200ppm/°C Molded SMD SMD Paper T/R | R2 | Res-0201 | RC0201FR-07220RL | Yageo |  | 220R | 1 | 5 | Digikey (https://www.digikey.nl/product-detail/en/yageo/RC0201FR-07220RL/YAG2509CT-ND/5281373) | $0.10 | $0.10 | $0.10 | $0.50
4 | IC | QRD1114 Series 30 V 50 mA Phototransistor Reflective Object Sensor | U1 | Custom | QRD1114 | On Semiconductor |  | ------ | 1 | 5 | Digikey (https://www.digikey.nl/products/en/sensors-transducers/optical-sensors-reflective-analog-output/546?k=QRD1114) | $1.84 | $1.84 | $1.84 | $9.20 | less Stock
5 | Connector | CONN HEADER VERT 3POS 2.5MM | J1 | Custom | B3B-XH-A(LF)(SN) | JST Sales America Inc. | B3B-XH-AM(LF)(SN) | ---- | 1 | 5 | Digikey (https://www.digikey.nl/product-detail/en/jst-sales-america-inc/B3B-XH-AM-LF-SN/455-2231-ND/1651029) | $0.17 | $0.17 | $0.17 | $0.85
 |  |  |  |  |  |  |  |  | Total Component Cost |  |  |  |  |  | $11.55
 |  |  |  |  |  |  |  |  | Single Board Cost |  |  |  | $2.31 |  | $2.31
