eSpark-Backup/franciscogimenez-hcdshardware/Documents/Deliverables_OB/BOM/LCSC BOM.xlsx

Bill of Material (BOM) for Optical Sensor
S. No. | Components | Description | Designator | Footprint (Package) | Manufacturer Part Number | Manufacturer | LCSC Part No | Alternate | Value | LCSC/MOQ | Quantity (Per Board) | Quantity 5 | LCSC Link | Unit Cost(1) | Total Cost(1) | MOQ Total | Unit Cost (5 Boards) | Total Cost (5) | Remarks
1 | Capacitor | CAP CER 10000PF 16V X5R 0201 | C1 | Cap 0201 | GRM033R61C103KA12D | Murata | C161472 |  | 0.01uF | 100 | 1 | 5 | LCSC (https://lcsc.com/product-detail/Multilayer-Ceramic-Capacitors-MLCC-SMD-SMT_Murata-Electronics-GRM033R61C103KA12D_C161472.html) | $0.00240 | $0.00240 | $0.24 | $0.00240 | $0.01
2 | Resistor | Res Thick Film 0201 470 Ohm 5% 0.05W(1/20W) ±200ppm/C Molded SMD Paper T/R | R1 | Res-0201 | RC0201JR-07470RL | Yageo | C163491 |  | 470R | 100 | 1 | 5 | LCSC (https://lcsc.com/product-detail/Chip-Resistor-Surface-Mount_YAGEO-RC0201JR-07470RL_C163491.html) | $0.00130 | $0.00130 | $0.13 | $0.00130 | $0.01
3 |  | Res Thick Film 0201 220 Ohm 1% 1/20W ±200ppm/°C Molded SMD SMD Paper T/R | R2 | Res-0201 | RC0201FR-07220RL | Yageo | C274342 |  | 220R | 100 | 1 | 5 | LCSC (https://lcsc.com/product-detail/Chip-Resistor-Surface-Mount_YAGEO-RC0201FR-07220RL_C274342.html) | $0.00160 | $0.00160 | $0.16 | $0.00160 | $0.01
4 | IC | QRD1114 Series 30 V 50 mA Phototransistor Reflective Object Sensor | U1 | Custom | QRD1114 | On Semiconductor | C258245 |  | ------ | 5 | 1 | 5 | LCSC (https://lcsc.com/product-detail/Optical-Sensors_ON-Semiconductor-ON-QRD1114_C258245.html) | $1.03460 | $1.03460 | $5.17 | $1.03460 | $5.17 | less Stock
5 | Connector | CONN HEADER VERT 3POS 2.5MM | J1 | Custom | B3B-XH-A(LF)(SN) | JST Sales America Inc. | C144394 |  | ---- | 10 | 1 | 5 | LCSC (https://lcsc.com/product-detail/Wire-To-Board-Wire-To-Wire-Connector_JST-Sales-America-B3B-XH-A-LF-SN_C144394.html) | $0.04590 | $0.04590 | $0.46 | $0.04590 | $0.23
 |  |  |  |  |  |  |  |  | Total Component Cost |  |  |  |  |  |  | $6.16 |  | $5.43
 |  |  |  |  |  |  |  |  | Single Board Cost |  |  |  |  |  | $1.08580 |  |  | $1.09
