eSpark-Backup/franciscogimenez-hcdshardware/Documents/Deliverables_OB/BOM/Opt_Sensor BOM.xlsx

Bill of Material (BOM) for Optical Sensor
S. No. | Comment Type | Description | Designator | Footprint (Package) | Manufacturer Part Number | Manufacturer | Value | Quantity | Total Quantity | Link | Unit Price | Total Price | Remarks
1 | Capacitor | CAP CER 10000PF 16V X5R 0201 | C1 | Cap 0201 | GRM033R61C103KA12D | Murata | 0.01uF | 1 | 2 | Mouser (https://www.mouser.es/ProductDetail/Murata-Electronics/GRM033R61C103KA12D/?qs=vCoBJ5OiJk48rdp2a9OSZQ==) | $0.10 | $0.20
2 | Resistor | Res Thick Film 0201 470 Ohm 5% 0.05W(1/20W) ±200ppm/C Molded SMD Paper T/R | R1 | Res-0201 | RC0201JR-07470RL | Yageo | 470R | 1 | 2 | Mouser (https://www.mouser.es/ProductDetail/Yageo/RC0201JR-07470RL/) | $0.10 | $0.20
3 |  | Res Thick Film 0201 220 Ohm 1% 1/20W ±200ppm/°C Molded SMD SMD Paper T/R | R2 | Res-0201 | RC0201FR-07220RL | Yageo | 220R | 1 | 2 | Mouser (https://www.mouser.es/ProductDetail/Yageo/RC0201FR-07220RL/) | $0.13 | $0.26
4 | IC | QRD1114 Series 30 V 50 mA Phototransistor Reflective Object Sensor | U1 | Custom | QRD1114 | On Semiconductor | ------ | 1 | 2 | Mouser (https://www.mouser.es/ProductDetail/ON-Semiconductor-Fairchild/QRD1114/?qs=%252BB4HepoMqkBZ8%2F997UtAOw%3D%3D) | $1.64 | $3.28
5 | Connector | CONN HEADER VERT 3POS 2.5MM | J1 | Custom | B3B-XH-A(LF)(SN) | JST Sales America Inc. | ---- | 1 | 2 |  |  | $0.00
