eSpark-Backup/franciscogimenez-hcdshardware/Documents/Deliverables_PB/BOM/Digikey_BOM (PB).xlsx

Bill of Material (BOM) for Francisco Gimenez (P/B)
S. No. | Components | Description | Designator | Footprint (Package) | Manufacturer Part Number | Manufacturer | Alternate | Value | Quantity (Per Board) | Quantity 5 | DigiKey Link | Unit Cost(1) | Total Cost(1) | Unit Cost (5 Boards) | Total Cost (5) | Remarks
1 | Capacitors | CAP CER 4.7UF 25V X5R 0603 | C1, C4, C5 | Cap0603 | C1608X5R1E475M080AC | TDK Corporation | ----------- | 4.7uF | 3 | 15 | Digikey (https://www.digikey.com/en/products/detail/tdk-corporation/C1608X5R1E475M080AC/3648583) | $0.3800 | $1.14 | $0.2580 | $3.87
2 |  | CAP CER 0.1UF 25V X6S 0201 | C2, C3, C6 | CAP 0201 | GRM033C81E104KE14D | Murata Electronics | TMK063C6104KP-F | 0.1uF | 3 | 15 | Digikey (https://www.digikey.com/en/products/detail/taiyo-yuden/TMK063C6104KP-F/5810986) | $0.1400 | $0.42 | $0.1000 | $1.50
3 | Diode | TVS DIODE 5.5V 8.5V SOT143-4 | D1 | SOT-143-4 | SP0503BAHTG | Littelfuse Inc. | ----------- | ----- | 1 | 5 | Future Electronics (https://www.futureelectronics.com/p/4171229) | $0.8750 | $0.88 | $0.8750 | $4.38
4 |  | LED BLUE CLEAR CHIP SMD 0402 | LED1, LED2 | LED 0402 | APHHS1005QBC/D | Kingbright | ----------- | ----- | 2 | 10 | Digikey (https://www.digikey.com/en/products/detail/kingbright/APHHS1005QBC-D/2263568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) | $0.5400 | $1.08 | $0.3310 | $3.31
5 | Resistors | RES 1K OHM 1% 1/20W 0201 | R1 | Res-0201 | RC0201FR-071KP | Yageo | ----------- | 1K | 1 | 5 | Digikey (https://www.digikey.com/en/products/detail/yageo/RC0201FR-071KP/12698916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) | $0.1300 | $0.13 | $0.1300 | $0.65
6 |  | RES SMD 470 OHM 5% 1/20W 0201 | R2, R3 | Res-0201 | RC0201JR-07470RL | Yageo | ----------- | 470R | 2 | 10 | Digikey (https://www.digikey.com/en/products/detail/yageo/RC0201JR-07470RL/1948953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) | $0.1000 | $0.20 | $0.0290 | $0.29
7 |  | RES 22.1K OHM 1% 1/20W 0201 | R4 | Res-0201 | RMCF0201FT22K1 | Stackpole Electronics Inc | ----------- | 22.1K | 1 | 5 | Digikey (https://www.digikey.com/en/products/detail/stackpole-electronics-inc/RMCF0201FT22K1/5965887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) | $0.1000 | $0.10 | $0.1000 | $0.50
8 |  | RES 47.5K OHM 1% 1/20W 0201 | R5 | Res-0201 | RK73H1HTTC4752F | KOA Speer Electronics, Inc | ----------- | 47.5K | 1 | 5 | Digikey (https://www.digikey.com/en/products/detail/koa-speer-electronics-inc/RK73H1HTTC4752F/9843838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) | $0.1000 | $0.10 | $0.1000 | $0.50
9 |  | RES 5.1K OHM 0.1% 1/20W 0201 | R6, R7 | Res-0201 | ERA-1AEB512C | Panasonic Electronic Components | ----------- | 5.1K | 2 | 10 | Digikey (https://www.digikey.com/en/products/detail/panasonic-electronic-components/ERA-1AEB512C/13149171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) | $0.3600 | $0.72 | $0.2770 | $2.77
10 | ICS | IC USB TO UART BRIDGE QFN28 | U1 | 28-QFN (5x5) | CP2102N-A02-GQFN28R | Silicon Labs | ----------- | ----- | 1 | 5 | Digikey (https://www.digikey.com/en/products/detail/silicon-labs/CP2102N-A02-GQFN28R/9863480) | $1.4700 | $1.47 | $1.4700 | $7.35
11 | Connectors | CONN RCP USB3.1 TYPEC 24P SMD RA | J1 | Custom | 2305018-2 | TE Connectivity AMP Connectors | ----------- | ----- | 1 | 5 | Digikey (https://www.digikey.com/en/products/detail/te-connectivity-amp-connectors/2305018-2/8680920) | $3.0000 | $3.00 | $3.0000 | $15.00
12 |  | CONN RCPT USB2.0 MICRO B SMD R/A | J2 | Custom | 10118194-0001LF | Amphenol ICC (FCI) | ----------- | ----- | 1 | 5 | Digikey (https://www.digikey.com/en/products/detail/amphenol-icc-fci/10118194-0001LF/2785389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) | $0.4800 | $0.48 | $0.4800 | $2.40
13 |  | ~~Test Point ON~~ | ~~P1, P2, P3, P4, P5, P6~~ | ~~Custom~~ | ~~TEST POINT~~ | ~~-----~~ | ~~-----~~ | ~~-----~~ | ~~6~~ | ~~30~~ |  |  | ~~$0.0000~~ |  | ~~$0.0000~~ | ~~DO NOT Mount~~
 |  |  |  |  |  |  |  |  | Total Component Cost |  |  |  |  |  | $42.52
 |  |  |  |  |  |  |  |  | Single Board Cost |  |  |  | $9.71 |  | $8.50
