eSpark-Backup/franciscogimenez-hcdshardware/Documents/Deliverables_PB/BOM/LCSC_BOM (PB).xlsx

Bill of Material (BOM) for Francisco Gimenez (PB)
S. No. | Components | Description | Designator | Footprint (Package) | Manufacturer Part Number | Manufacturer | LCSC Part No | Alternate | Value | LCSC/MOQ | Quantity (Per Board) | Quantity 5 | LCSC Link | Unit Cost(1) | Total Cost(1) | Unit Cost (5 Boards) | Total Cost (5) | Remarks
1 | Capacitors | CAP CER 4.7UF 25V X5R 0603 | C1, C4, C5 | Cap0603 | C1608X5R1E475M080AC | TDK Corporation | C69335 | CL10A475KA8NQNC | 4.7uF | 20 | 3 | 15 | LCSC (https://lcsc.com/product-detail/Multilayer-Ceramic-Capacitors-MLCC-SMD-SMT_Samsung-Electro-Mechanics-CL10A475KA8NQNC_C69335.html) | $0.0250 | $0.50 | $0.0250 | $0.50
2 |  | CAP CER 0.1UF 25V X6S 0201 | C2, C3, C6 | CAP 0201 | GRM033C81E104KE14D | Murata Electronics | C76939 | GRM033R61E104KE14D | 0.1uF | 50 | 3 | 15 | LCSC (https://lcsc.com/product-detail/Multilayer-Ceramic-Capacitors-MLCC-SMD-SMT_Murata-Electronics-GRM033R61E104KE14D_C76939.html) | $0.0061 | $0.30 | $0.0061 | $0.30
3 | Diode | TVS DIODE 5.5V 8.5V SOT143-4 | D1 | SOT-143-4 | SP0503BAHTG | Littelfuse Inc. | C7074 | ------------- | ----- | 1 | 1 | 5 | LCSC (https://lcsc.com/product-detail/TVS_Littelfuse-SP0503BAHTG_C7074.html) | $0.2304 | $0.23 | $0.2304 | $1.15
4 |  | LED BLUE CLEAR CHIP SMD 0402 | LED1, LED2 | LED 0402 | APHHS1005QBC/D | Kingbright | C273603 | TJ-S1005SW4TGLC6B-A5 | ----- | 10 | 2 | 10 | LCSC (https://lcsc.com/product-detail/Light-Emitting-Diodes-LED_TOGIALED-TJ-S1005SW4TGLC6B-A5_C273603.html) | $0.0487 | $0.49 | $0.0487 | $0.49
5 | Resistor | RES 1K OHM 1% 1/20W 0201 | R1 | Res-0201 | RC0201FR-071KP | Yageo | C138165 | RC0201FR-071KL | 1K | 100 | 1 | 5 | LCSC (https://lcsc.com/product-detail/Chip-Resistor-Surface-Mount_YAGEO-RC0201FR-071KL_C138165.html) | $0.0012 | $0.12 | $0.0012 | $0.12
6 |  | RES SMD 470 OHM 5% 1/20W 0201 | R2, R3 | Res-0201 | RC0201JR-07470RL | Yageo | C163491 | ------------- | 470R | 100 | 2 | 10 | LCSC (https://lcsc.com/product-detail/Chip-Resistor-Surface-Mount_YAGEO-RC0201JR-07470RL_C163491.html) | $0.0013 | $0.13 | $0.0013 | $0.13
7 |  | RES 22.1K OHM 1% 1/20W 0201 | R4 | Res-0201 | RMCF0201FT22K1 | Stackpole Electronics Inc | C142019 | RC0201FR-0722K1L | 22.1K | 100 | 1 | 5 | LCSC (https://lcsc.com/product-detail/Chip-Resistor-Surface-Mount_22-1KR-2212-1_C142019.html) | $0.0014 | $0.14 | $0.0014 | $0.14
8 |  | RES 47.5K OHM 1% 1/20W 0201 | R5 | Res-0201 | RK73H1HTTC4752F | KOA Speer Electronics, Inc | C166179 | RTT014752FTH | 47.5K | 100 | 1 | 5 | LCSC (https://lcsc.com/product-detail/Chip-Resistor-Surface-Mount_RALEC-RTT014752FTH_C166179.html) | $0.0012 | $0.12 | $0.0012 | $0.12
9 |  | RES 5.1K OHM 0.1% 1/20W 0201 | R6, R7 | Res-0201 | ERA-1AEB512C | Panasonic Electronic Components | C102734 | RTT015101FTH | 5.1K | 100 | 2 | 10 | LCSC (https://lcsc.com/product-detail/Chip-Resistor-Surface-Mount_5-1KR-5101-1_C102734.html) | $0.0008 | $0.08 | $0.0008 | $0.08
10 | IC | IC USB TO UART BRIDGE QFN28 | U1 | 28-QFN (5x5) | CP2102N-A02-GQFN28R | Silicon Labs | C964632 |  | ----- | 1 | 1 | 5 | LCSC (https://lcsc.com/product-detail/USB-ICs_SILICON-LABS-CP2102N-A02-GQFN28R_C964632.html) | $2.4345 | $2.43 | $2.4345 | $12.17 | Part NON stock LCSC
11 | Connector | CONN RCP USB3.1 TYPEC 24P SMD RA | J1 | Custom | 2305018-2 | TE Connectivity AMP Connectors | C498674 | ------------- | ----- | 1 | 1 | 5 | LCSC (https://lcsc.com/product-detail/USB-Connectors_TE-Connectivity-2305018-2_C498674.html) | $2.9700 | $2.97 | $2.9700 | $14.85
12 |  | CONN RCPT USB2.0 MICRO B SMD R/A | J2 | Custom | 10118194-0001LF | Amphenol ICC (FCI) | C132563 | ------------- | ----- | 1 | 1 | 5 | LCSC (https://lcsc.com/product-detail/USB-Connectors_Amphenol-ICC-10118194-0001LF_C132563.html) | $0.3148 | $0.31 | $0.3148 | $1.57 | Part NON stock LCSC
13 |  | ~~Test Point ON~~ | ~~P1, P2, P3, P4, P5, P6~~ | ~~Custom~~ | ~~TEST POINT~~ | ~~-----~~ | ~~-----~~ | ~~-----~~ | ~~-----~~ |  | ~~6~~ | ~~$30.0000~~ |  |  | ~~$0.0000~~ |  | ~~$0.0000~~ | ~~DO NOT Mount~~
 |  |  |  |  |  |  |  |  |  |  | Total Component Cost |  |  |  |  |  | $31.63
 |  |  |  |  |  |  |  |  |  |  | Single Board Cost |  |  |  | $7.83 |  | $6.33
