eSpark-Backup/franciscogimenez-hcdshardware/Design-Files(OB)/Project Outputs for Optical Sensor_/Optical Sensor_.xlsx

Comment | Description | Designator | Footprint | LibRef | Quantity
0.01uF | CAP CER 10000PF 16V X5R 0201 | C1 | Cap 0201 | GRM033R61C103KA12D | 1
3-644695-3 | CONN HEADER VERT 3POS .100 TIN | J1 | HDR1X3 | 3-644695-3 | 1
470R | Res Thick Film 0201 470 Ohm 5% 0.05W(1/20W) ±200ppm/C Molded SMD Paper T/R | R1 | Res-0201 | RC0201JR-07470RL | 1
220R | Res Thick Film 0201 220 Ohm 1% 1/20W ±200ppm/°C Molded SMD SMD Paper T/R | R2 | Res-0201 | RC0201FR-07220RL | 1
QRD1114 | QRD1114 Series 30 V 50 mA Phototransistor Reflective Object Sensor | U1 | QRD1114 | QRD1114 | 1
