eSpark-Backup/franciscogimenez-hcdshardware/Documents/Client-Shared-Files/HairColorDispenser-master/PCB/Output Files/CAD/HairColorDispenser.step

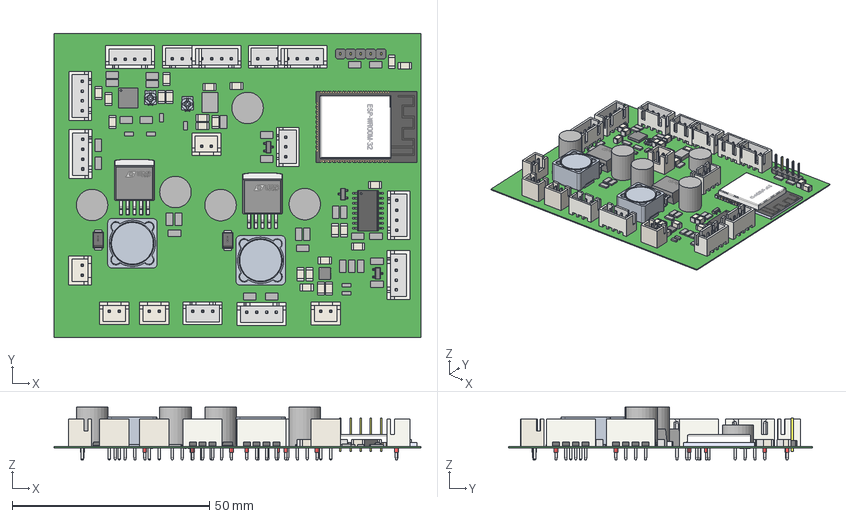
[picture p57: CAD file, 2021-12-03]
Documents/Client-Shared-Files/HairColorDispenser-master/PCB/Output Files/CAD/HairColorDispenser.step
93.0 x 77.0 x 13.4 mm
Board
User_Library-jst-b3b-xh-a x 4
User_Library-esp-wroom-32
Extruded x 116
SOP16_Body
Foot_SOP16 x 28
User_Library-TDFN-EP-14
User_Library-SOD128 x 2
User_Library-TO-263BA x 2
pin x 9
bodu_TO23 x 3
SMD_POT_3mm x 4
33uH_3A x 2
User_Library-jst-b4b-xh-a-1 x 8
B2B-XH-A x 5
