eSpark-Backup/franciscogimenez-hcdshardware/Documents/Deliverables/Supporting_Files/HCD_PCB.step

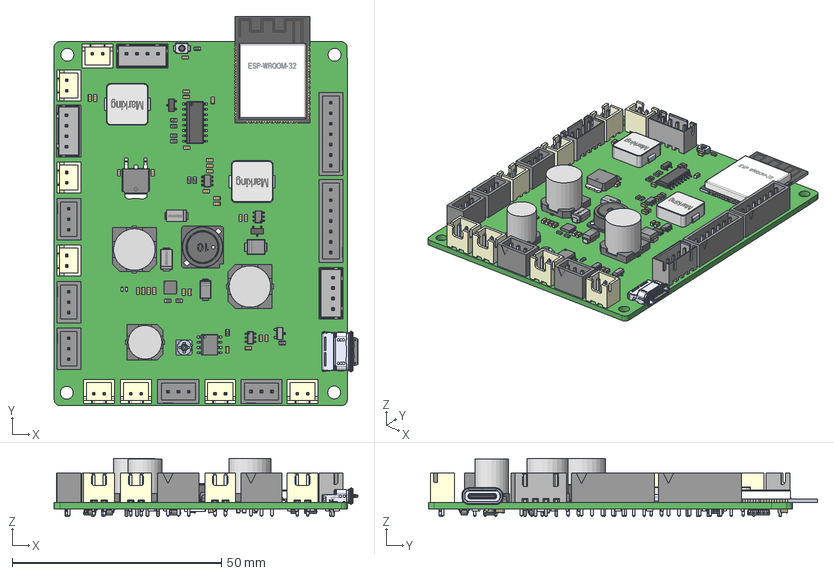
[picture p58: CAD file, 2021-12-03]
Documents/Deliverables/Supporting_Files/HCD_PCB.step
72.7 x 93.1 x 13.9 mm
Board
User_Library-DO-214AC(SMA) x 2
TPS565208DDCT
PCAP_10x10-ELECT_NCA x 2
base x 2
pin x 2
User_Library-CAPC1608X09 x 38
LeadsArray x 7
B4B-XH-A-LF--SN---3DModel-STEP-56544_RGB8421504 x 3
User_Library-RESC1608X05N x 24
B2B-XH-A(LF)(SN)--3DModel-STEP-56544 x 8
2305018-2--3DModel-STEP-56544
esp-wroom-32
User_Library-SOIC127P600X175-16
SN74LV1T34DBVR x 5
SSOP3_ROM
User_Library-TSOP-6
LTC4412IS6#TRPBF
CircuitWorks-SOT-23 x 4
User_Library-DO-214AA_SMB
DFN-12_DD_LIT
NOPB
User_Library-R_2010
APHHS1005 x 2
User_Library-DO-214AC_SMA
PCAP_8x10-ELECT_NCA
User_Library-OMRON_B3U1000P
LDF33DT-TR
TC33_SUBST1
Imported
Imported_2
Imported_3
Imported_4
Imported_5
