eSpark-Backup/franciscogimenez-hcdshardware/Documents/Deliverables_OB/Randring/DXF.DXF

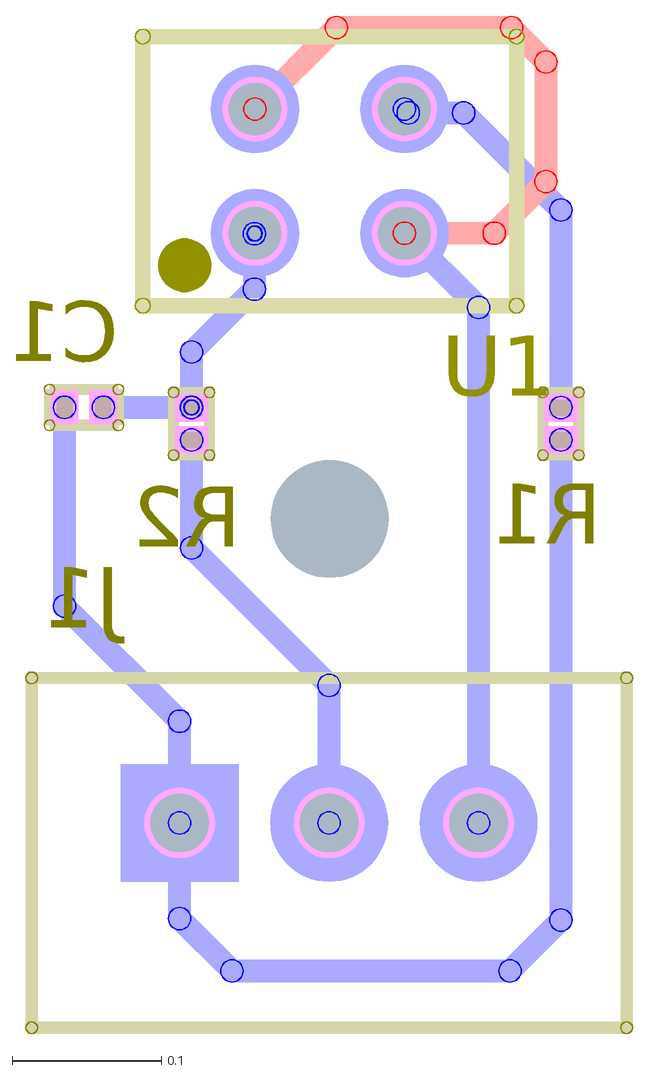
[picture p59: CAD file, 2021-12-03]
Documents/Deliverables_OB/Randring/DXF.DXF
J1
R2
R1
C1
U1
