eSpark-Backup/franciscogimenez-hcdshardware/Documents/Deliverables_OB/Supporting Files/Optical_Sensor.Step

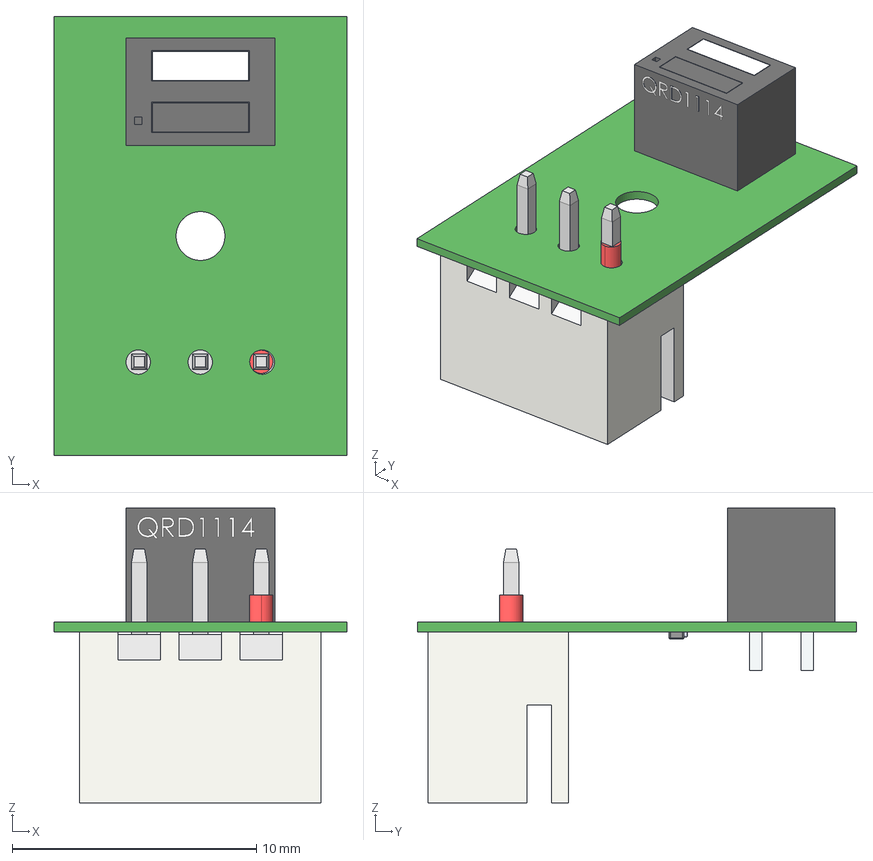
[picture p60: CAD file, 2021-12-03]
Documents/Deliverables_OB/Supporting Files/Optical_Sensor.Step
12.0 x 18.0 x 12.1 mm
User_Library-jst-b3b-xh-a
User_Library-0201(0603M)_Res x 2
GRM033R60J104KE19D--3DModel-STEP-56544
QRD1114
