eSpark-Backup/franciscogimenez-hcdshardware/Documents/Deliverables_PB/Supporting_Files/PB_PCB.step

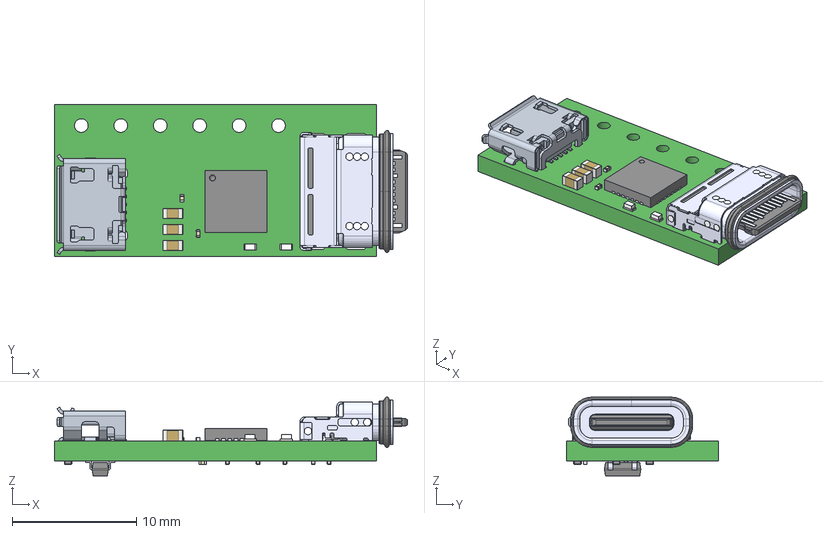
[picture p61: CAD file, 2021-12-03]
Documents/Deliverables_PB/Supporting_Files/PB_PCB.step
28.4 x 12.2 x 6.35 mm
Board
User_Library-0201(0603M)_Res x 7
APHHS1005 x 2
10118194c
2305018-2--3DModel-STEP-56544
SP0503BAHTG--3DModel-STEP-56544_(1)
User_Library-SMD_Ceramic_Capacitors_0201_(0603)_AB x 3
User_Library-CAPC1608X09 x 3
