eSpark-Backup/franciscogimenez-hcdshardware/(list of files, cad)

Other CAD files:
Documents/Deliverables_OB/Randring/Optical_Sensor.DWG
Documents/Dev-Shared-Files/Optical-Sensor-PCB/Deliverables/Randring/Optical_Sensor.DWG
Documents/Deliverables/Supporting_Files/HCD_PCB.DWG
Documents/Deliverables/Supporting_Files/HCD_PCB.DXF
Documents/Deliverables_PB/Supporting_Files/PB_PCB.DWG
Documents/Deliverables_PB/Supporting_Files/PB_PCB.DXF
