eSpark-Backup/franciscogimenez-hcdshardware/Documents/Client-Shared-Files/HairColorDispenser-master/PCB/Output Files/PDF/HairColorDispenser_PCB 3D Print_Bottom.PDF

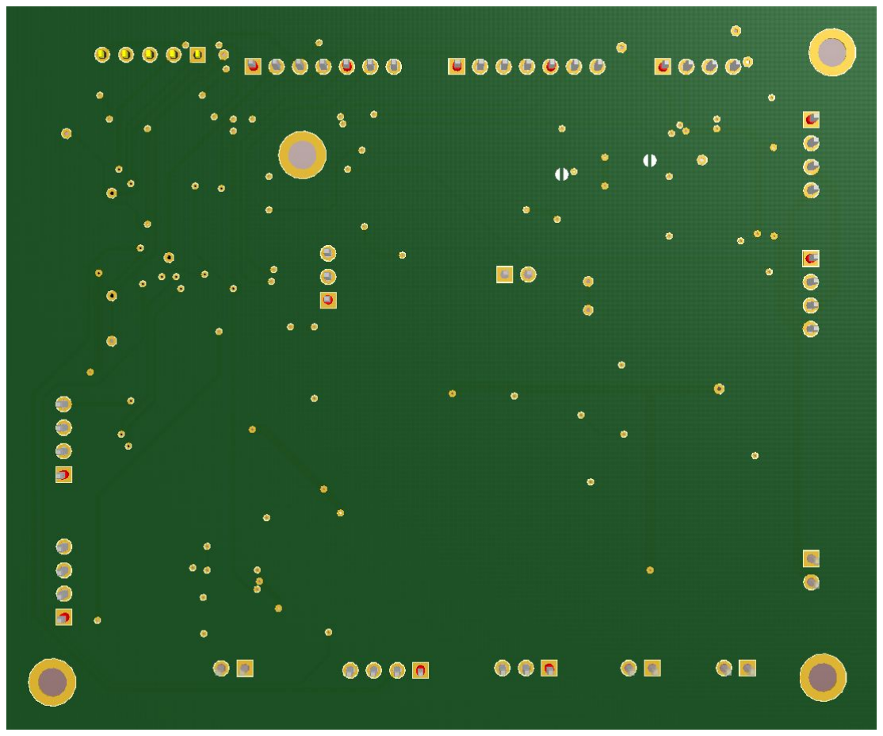
[picture p62: figure]
