eSpark-Backup/franciscogimenez-hcdshardware/Design-Files/Francisco Gimenez.pdf

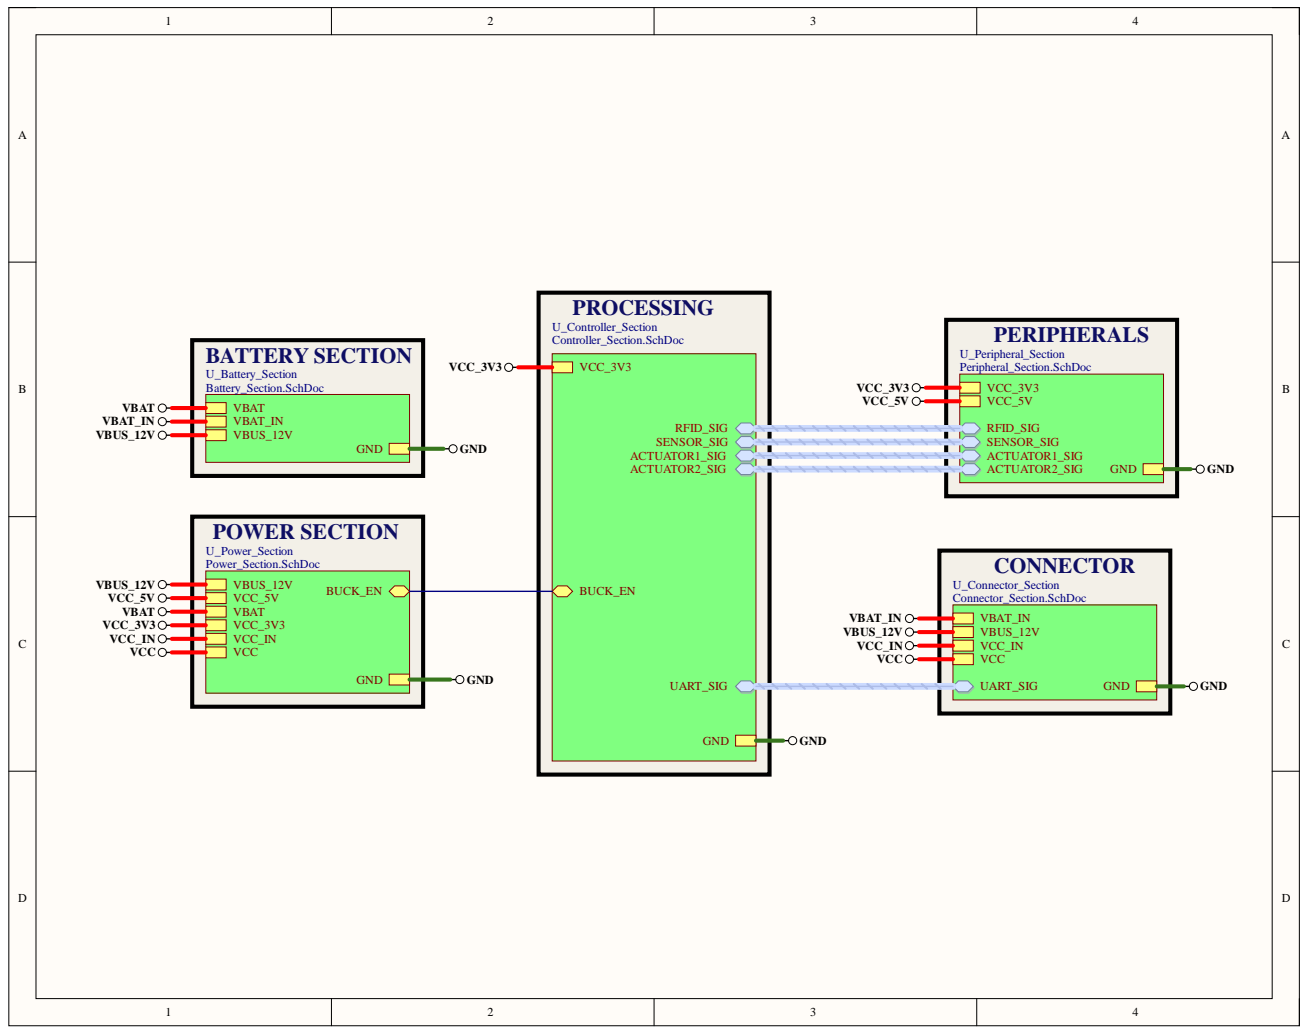
[picture p64: page 1]

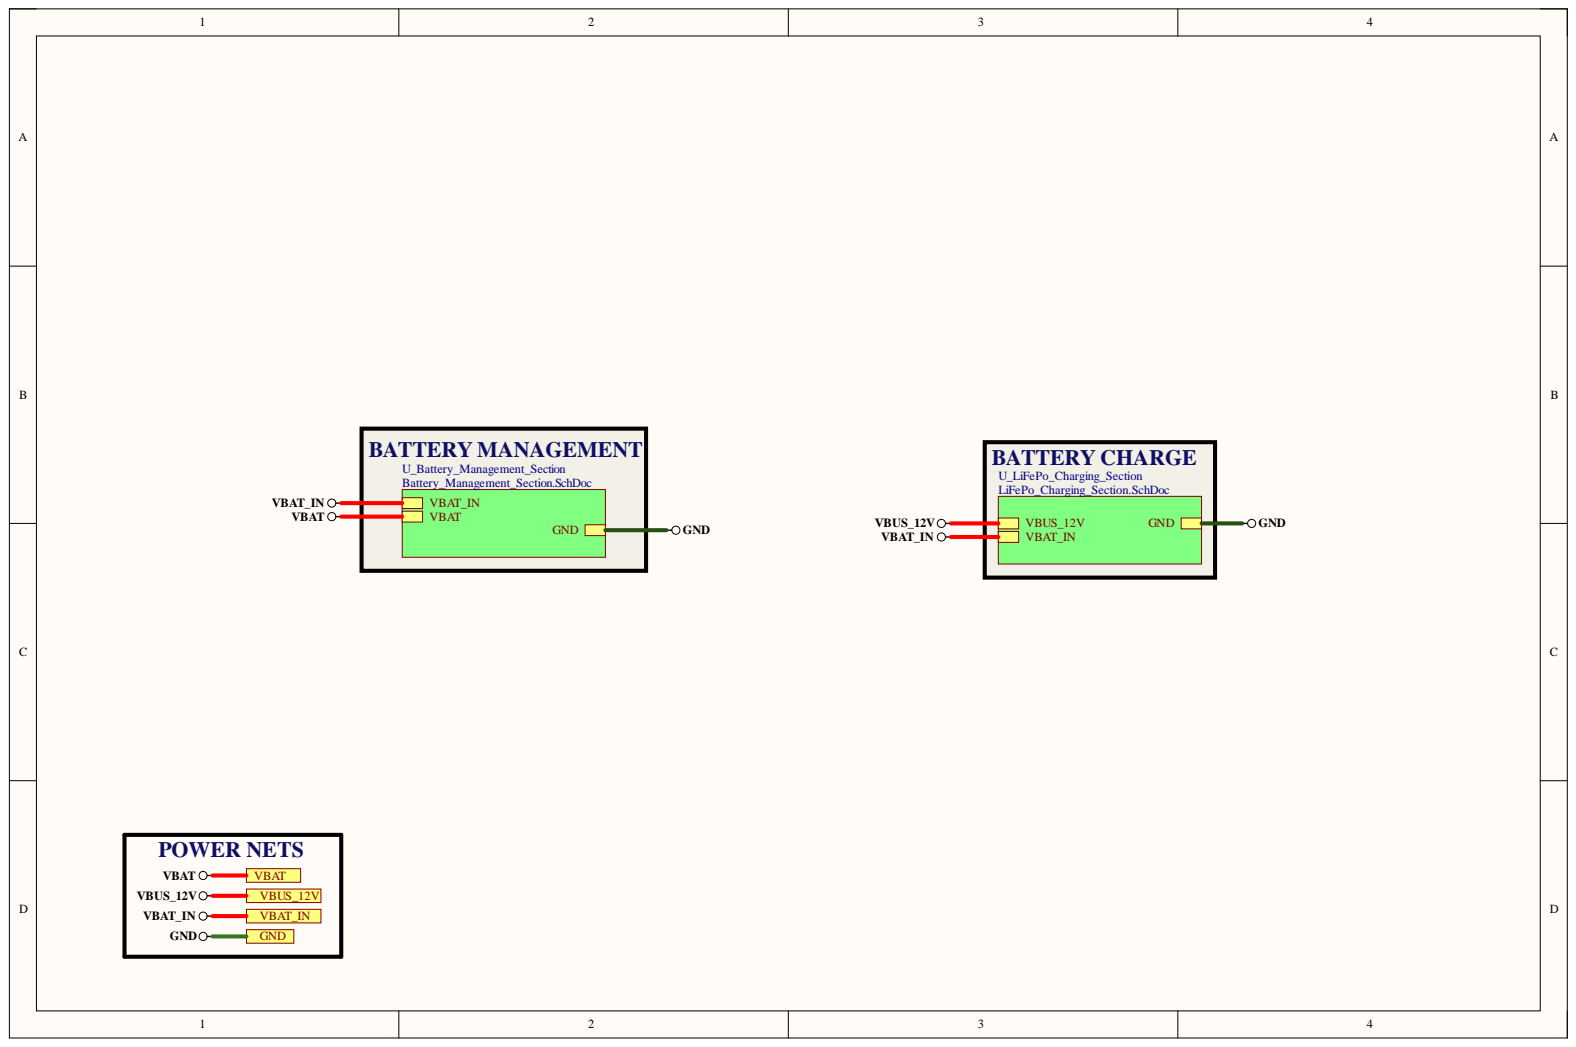
[picture p65: page 2]

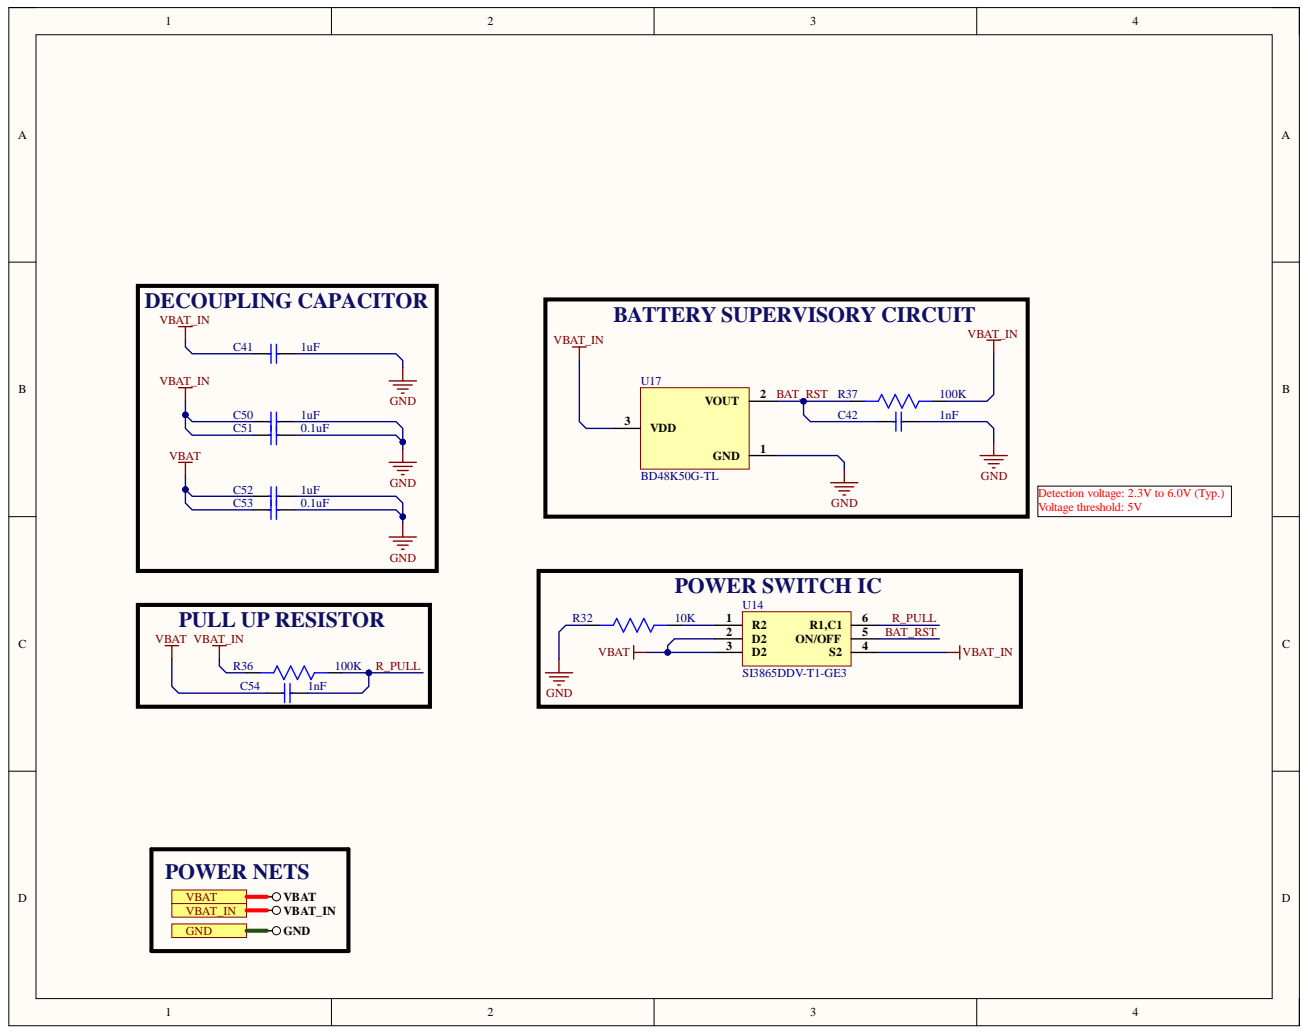
[picture p66: page 3]

Detection voltage: 2.3V to 6.0V (Typ.)
Voltage threshold: 5V

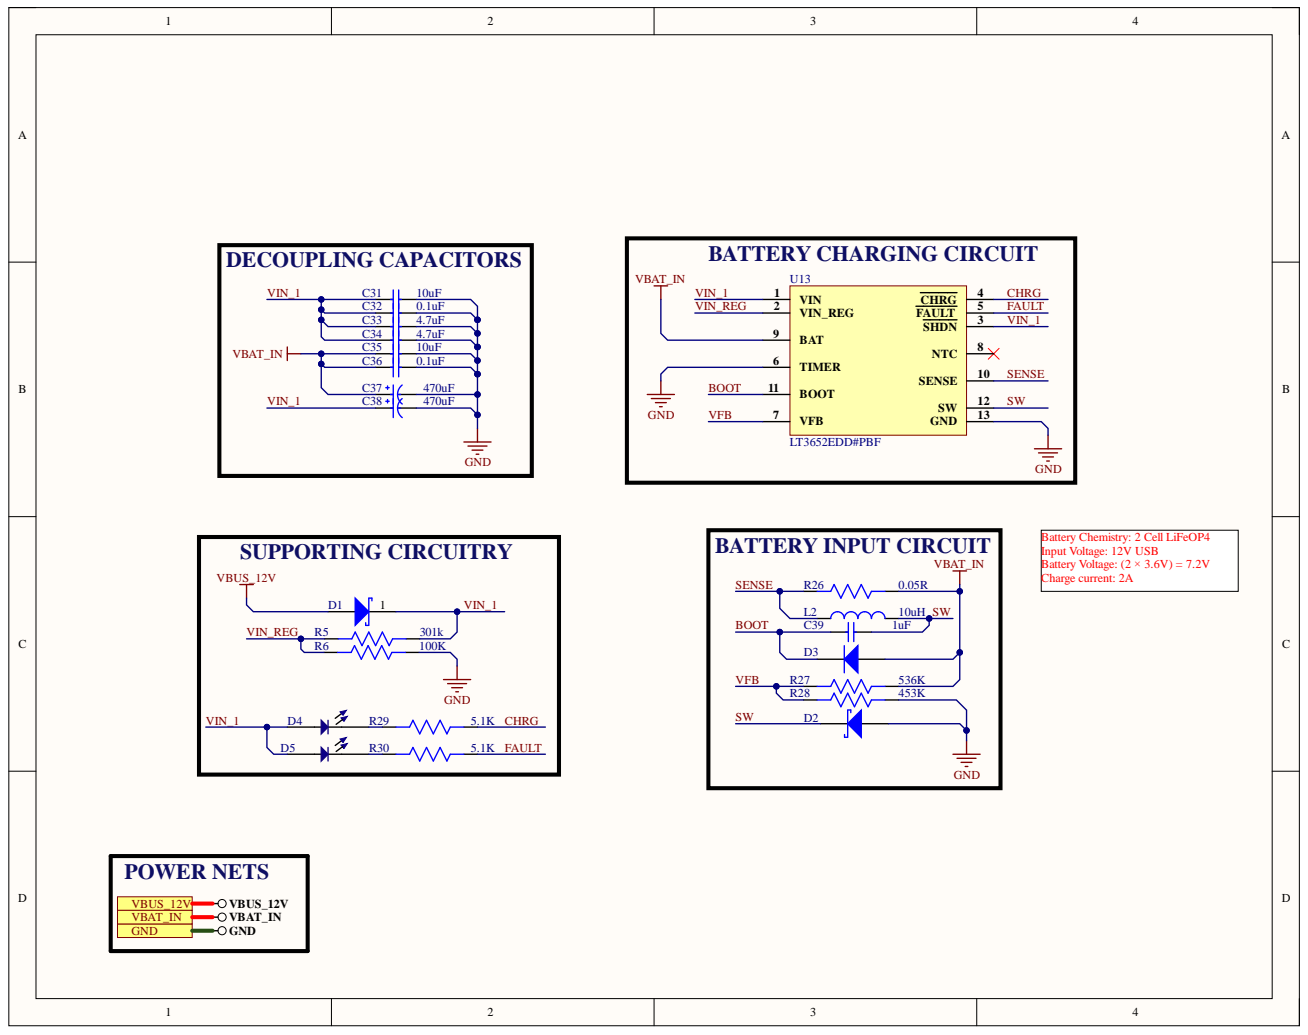
[picture p67: page 4]

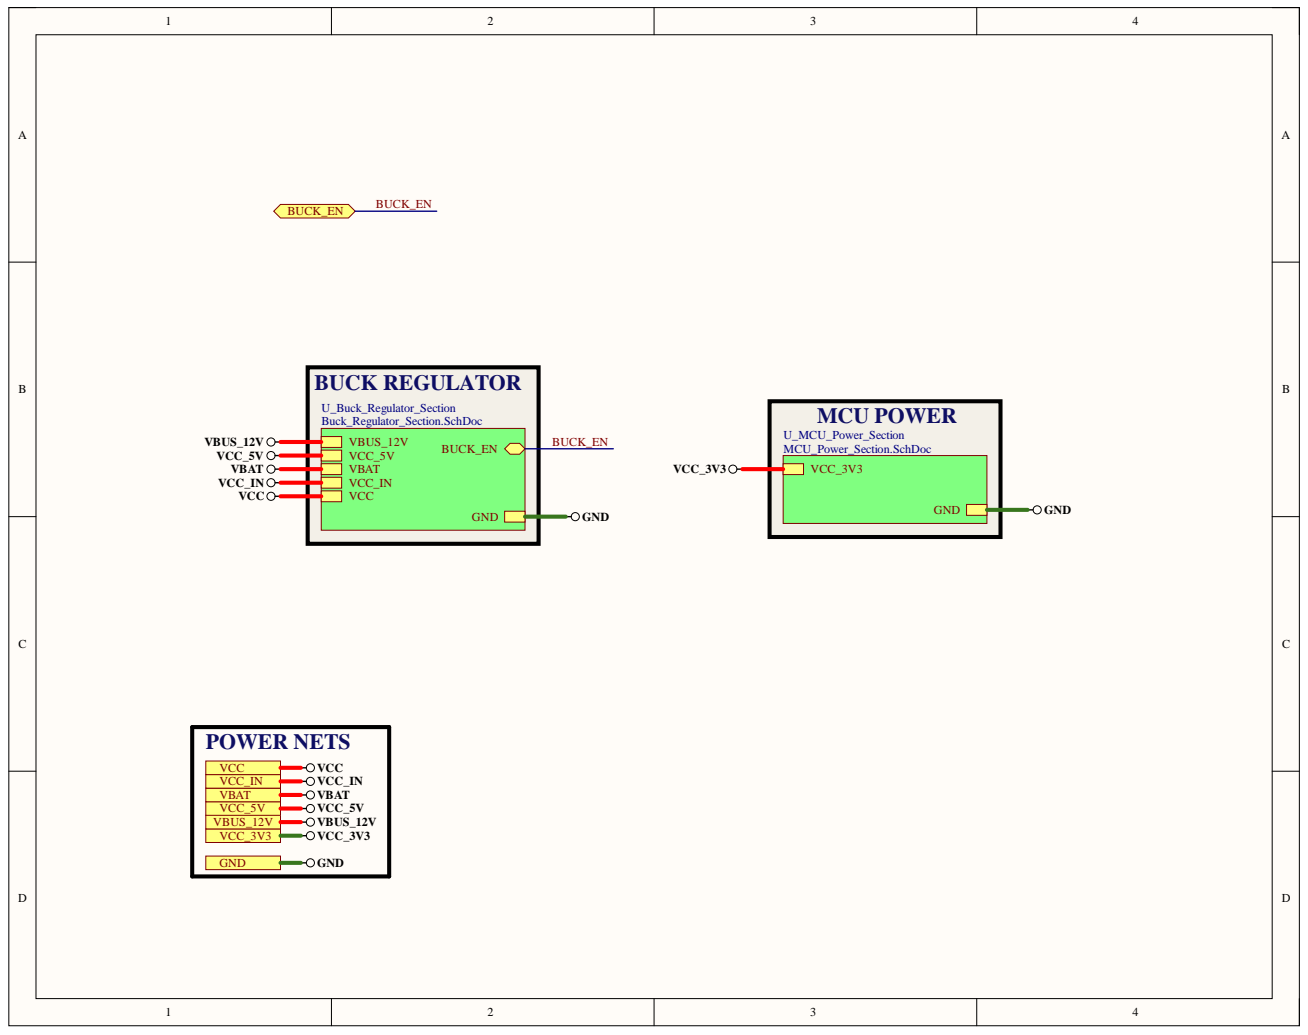
[picture p68: page 5]

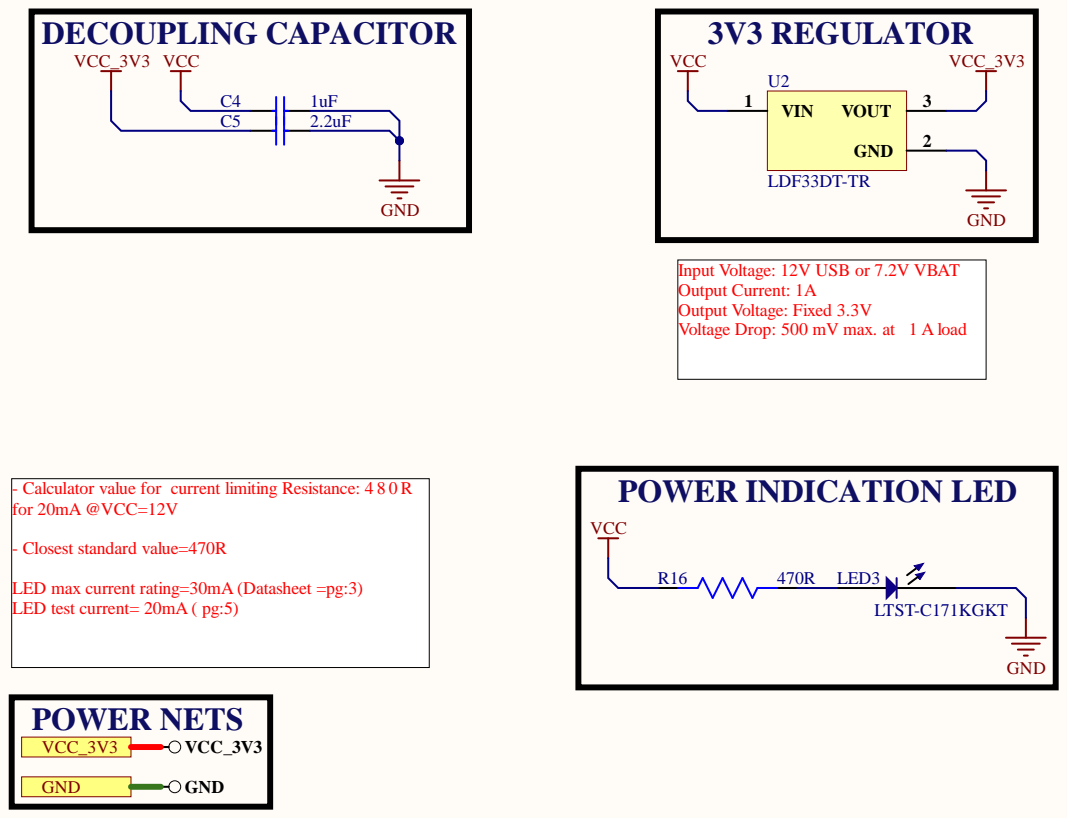
[picture p69: page 6]

Input Voltage: 12V USB or 7.2V VBAT
Output Current: 1A
Output Voltage: Fixed 3.3V
Voltage Drop: 500 mV max. at 1 A load

- Calculator value for current limiting Resistance: 480R
for 20mA @VCC=12V

LED max current rating=30mA (Datasheet =pg:3)
LED test current= 20mA ( pg:5)

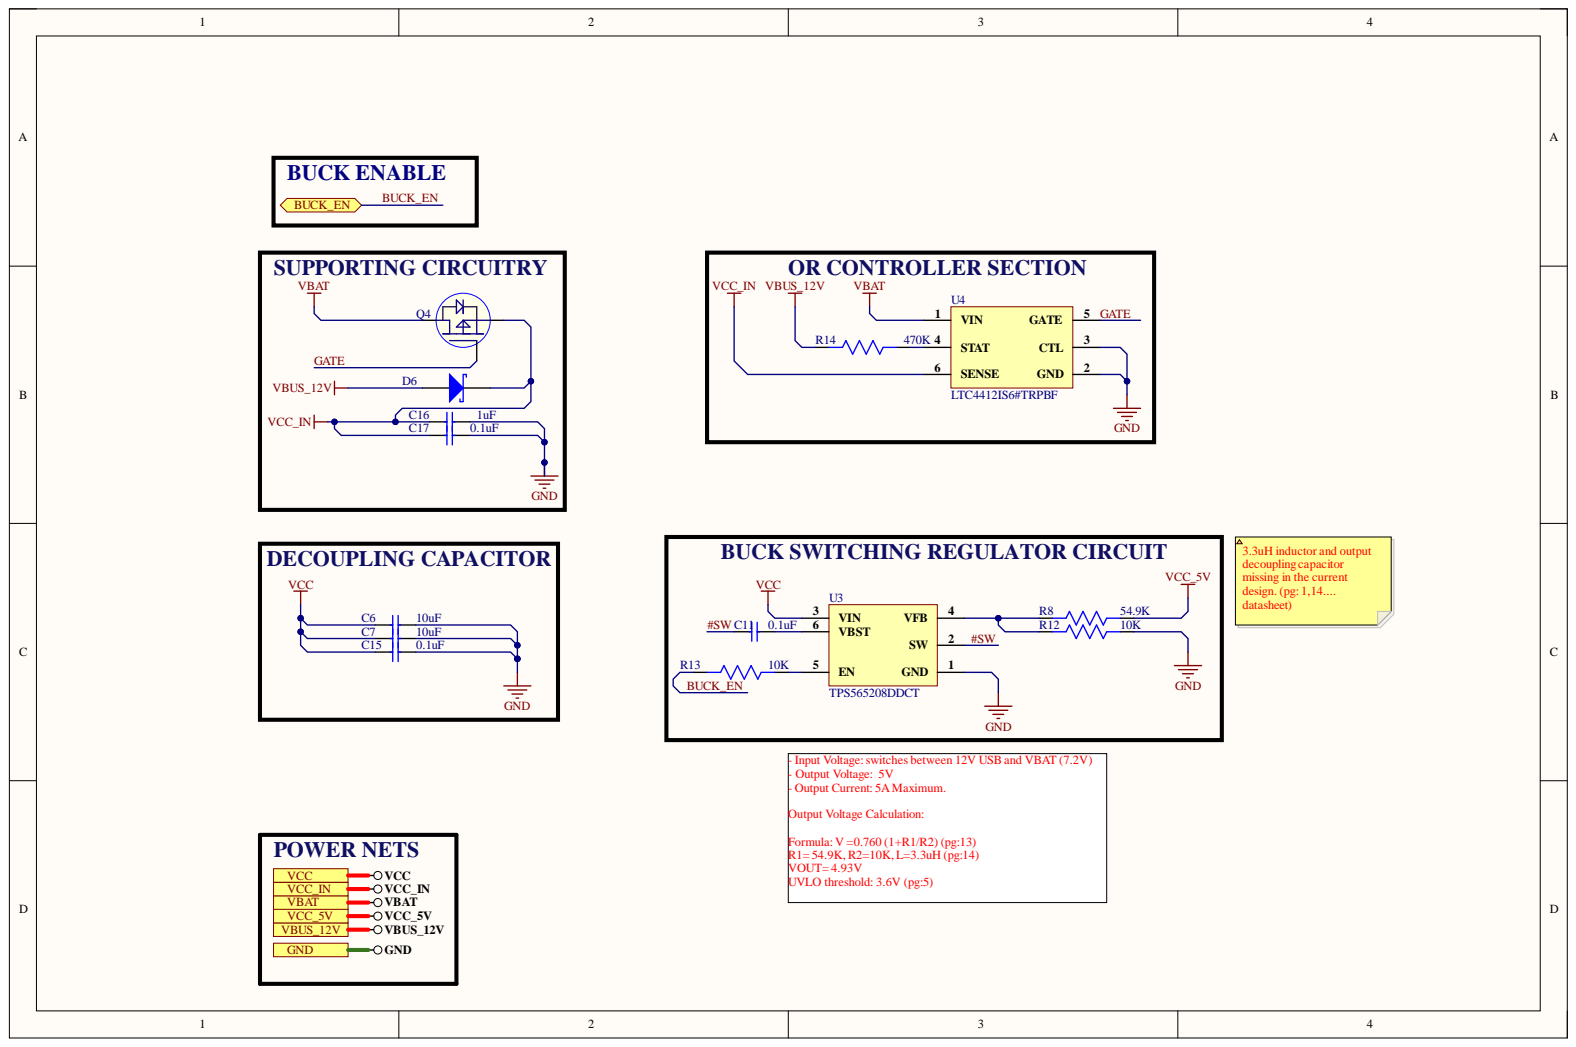
[picture p70: page 7]

BUCK SWITCHING REGULATOR CIRCUIT

3.3uH inductor and output
decoupling capacitor
missing in the current
design. (pg: 1,14....
datasheet)

- Input Voltage:switches between 12V USB and VBAT (7.2V)
- Output Voltage: 5V
- Output Current: 5A Maximum.

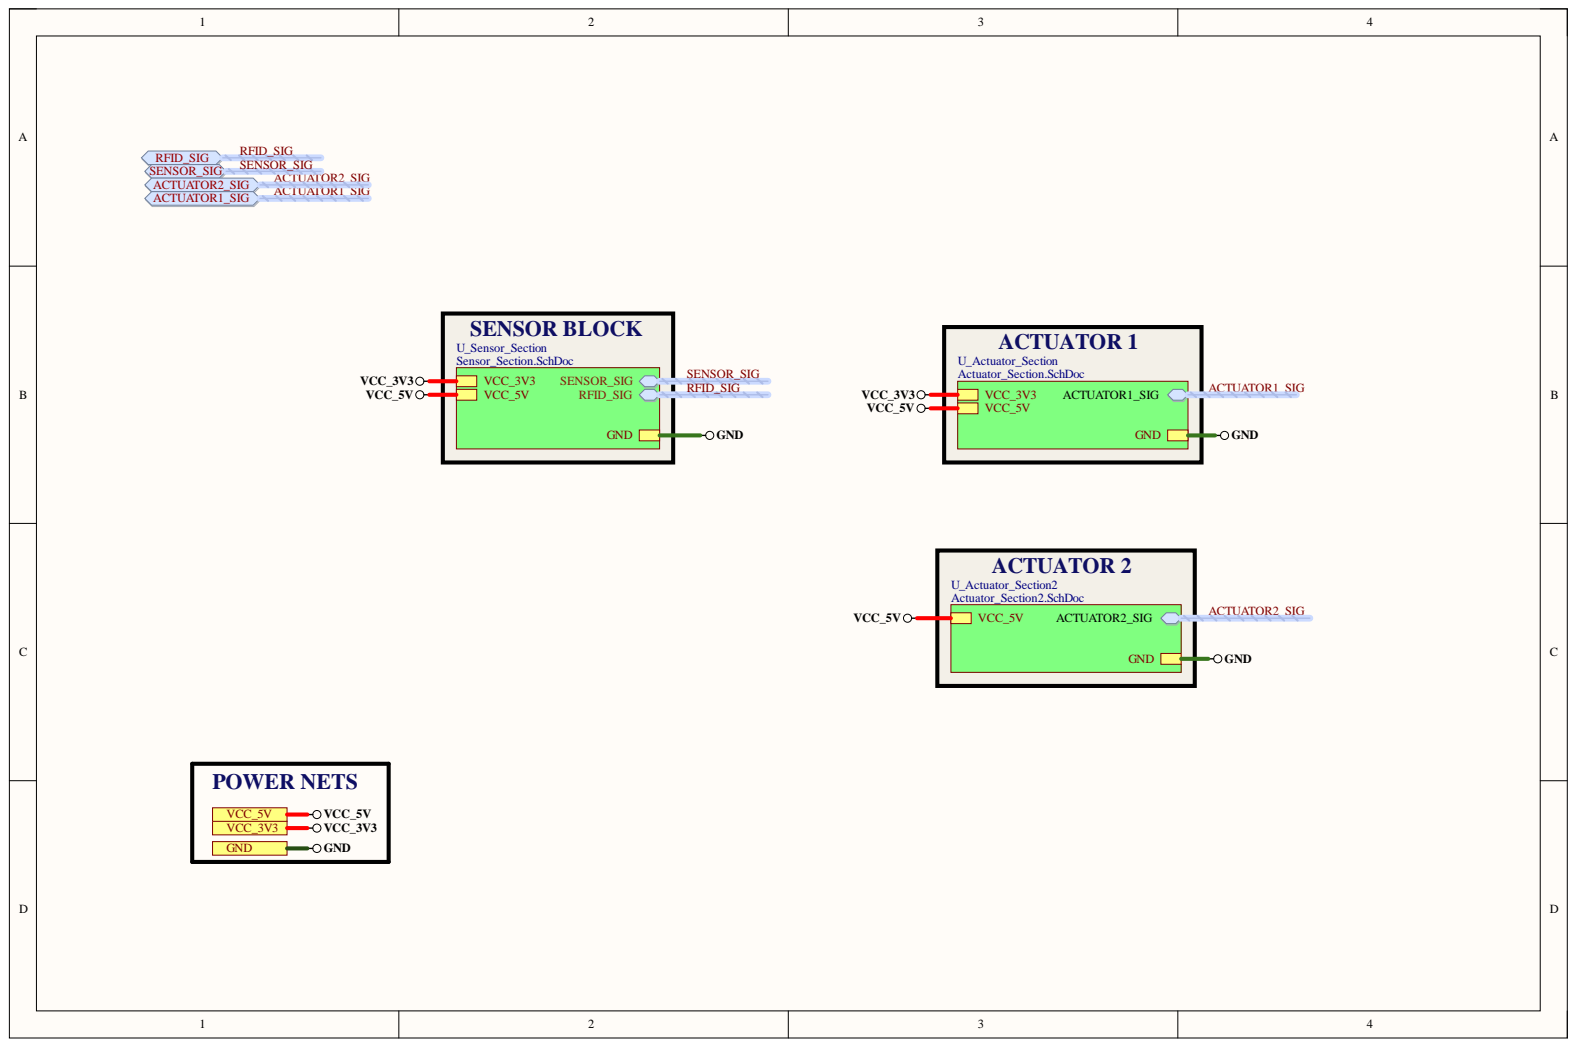
[picture p71: page 8]

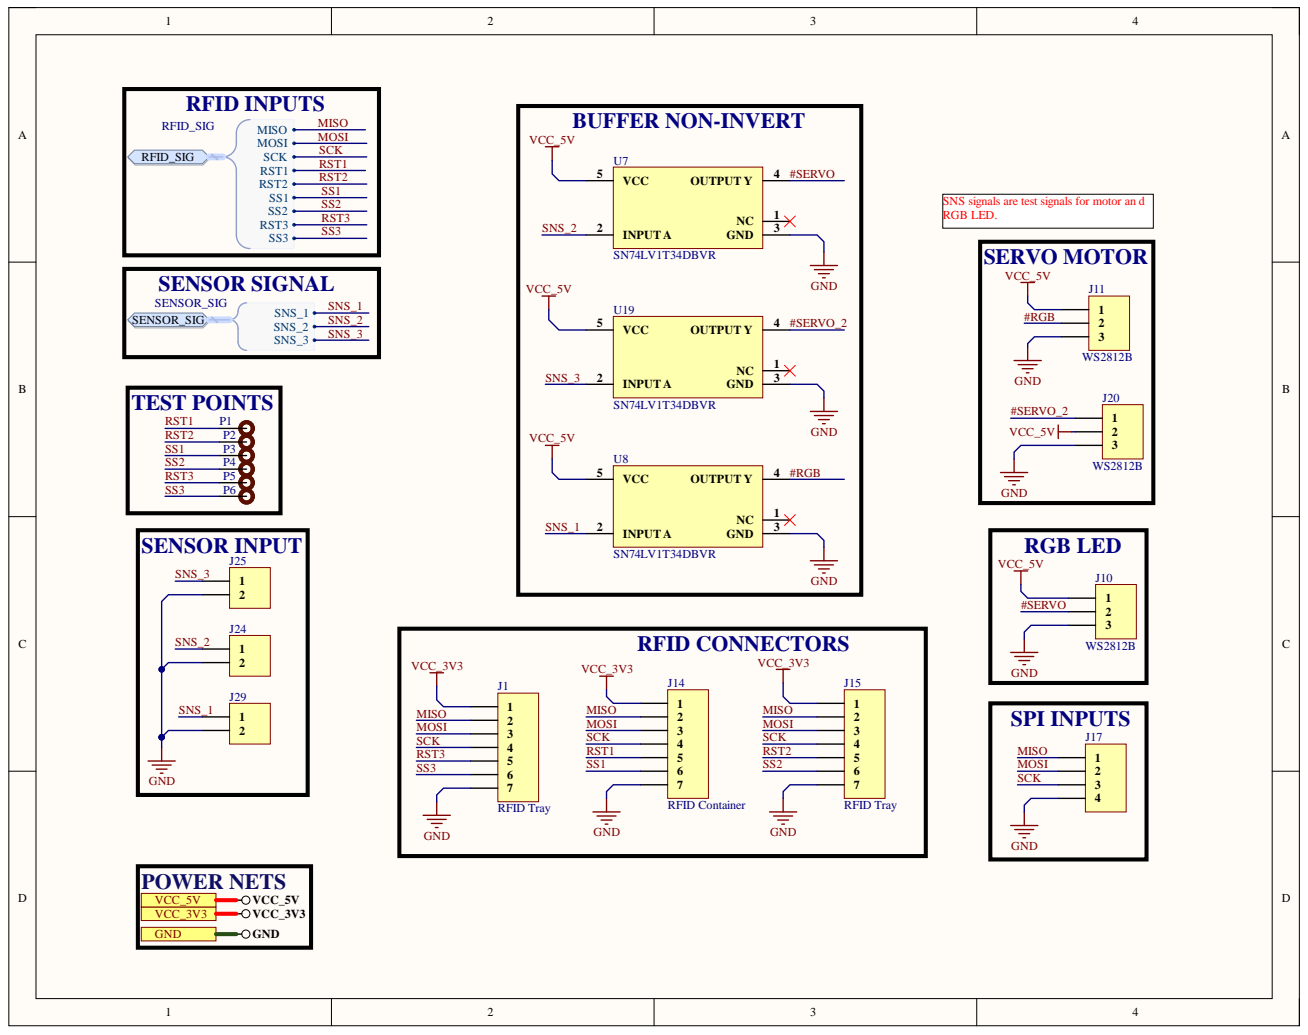
[picture p72: page 9]

SNS signals are test signals for motor and
RGB LED.

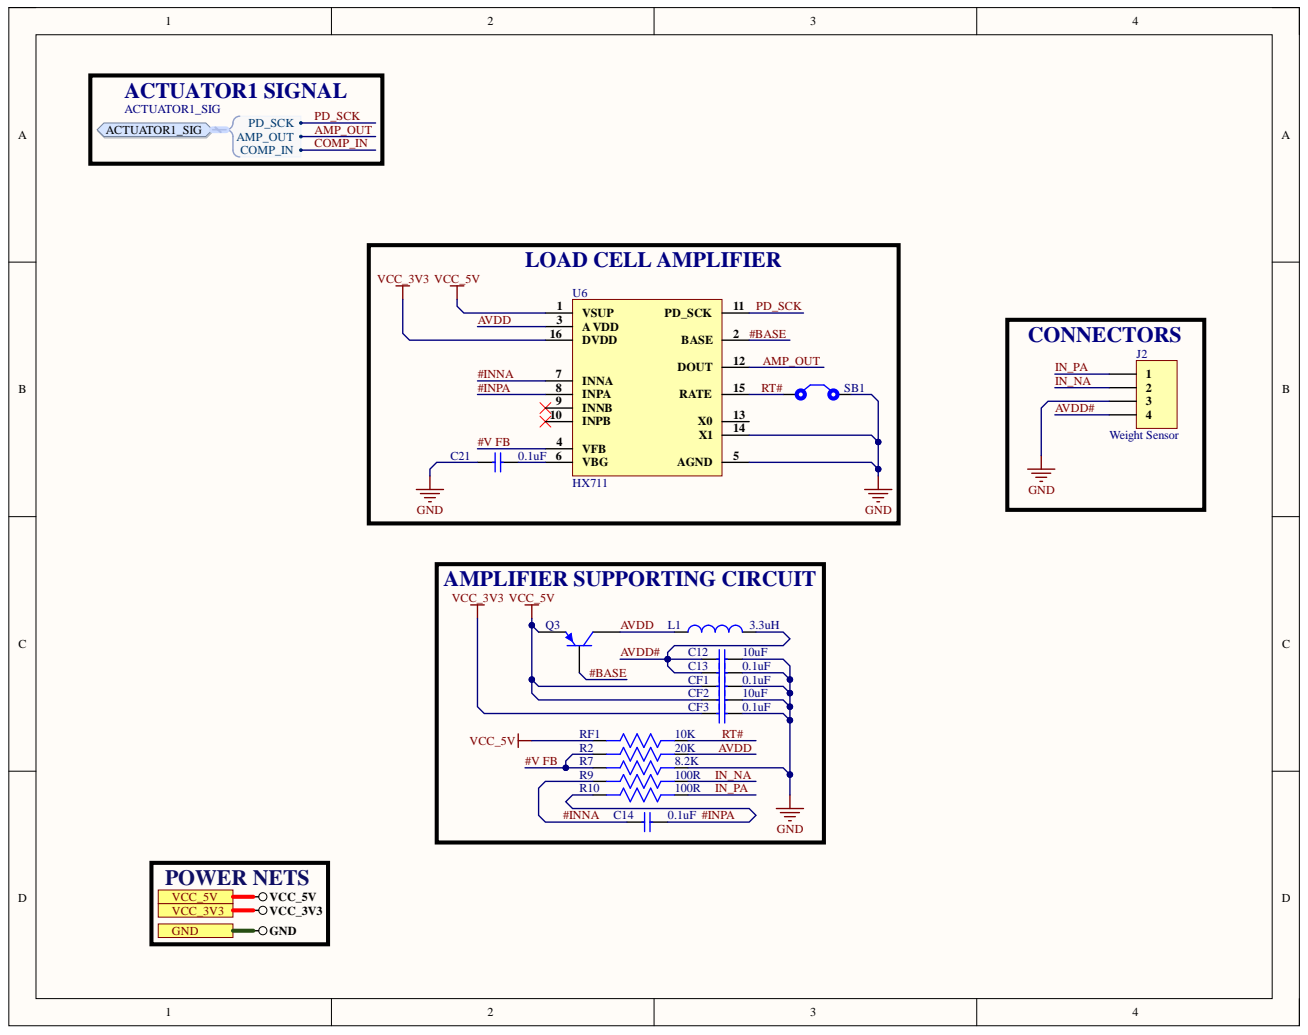
[picture p73: page 10]

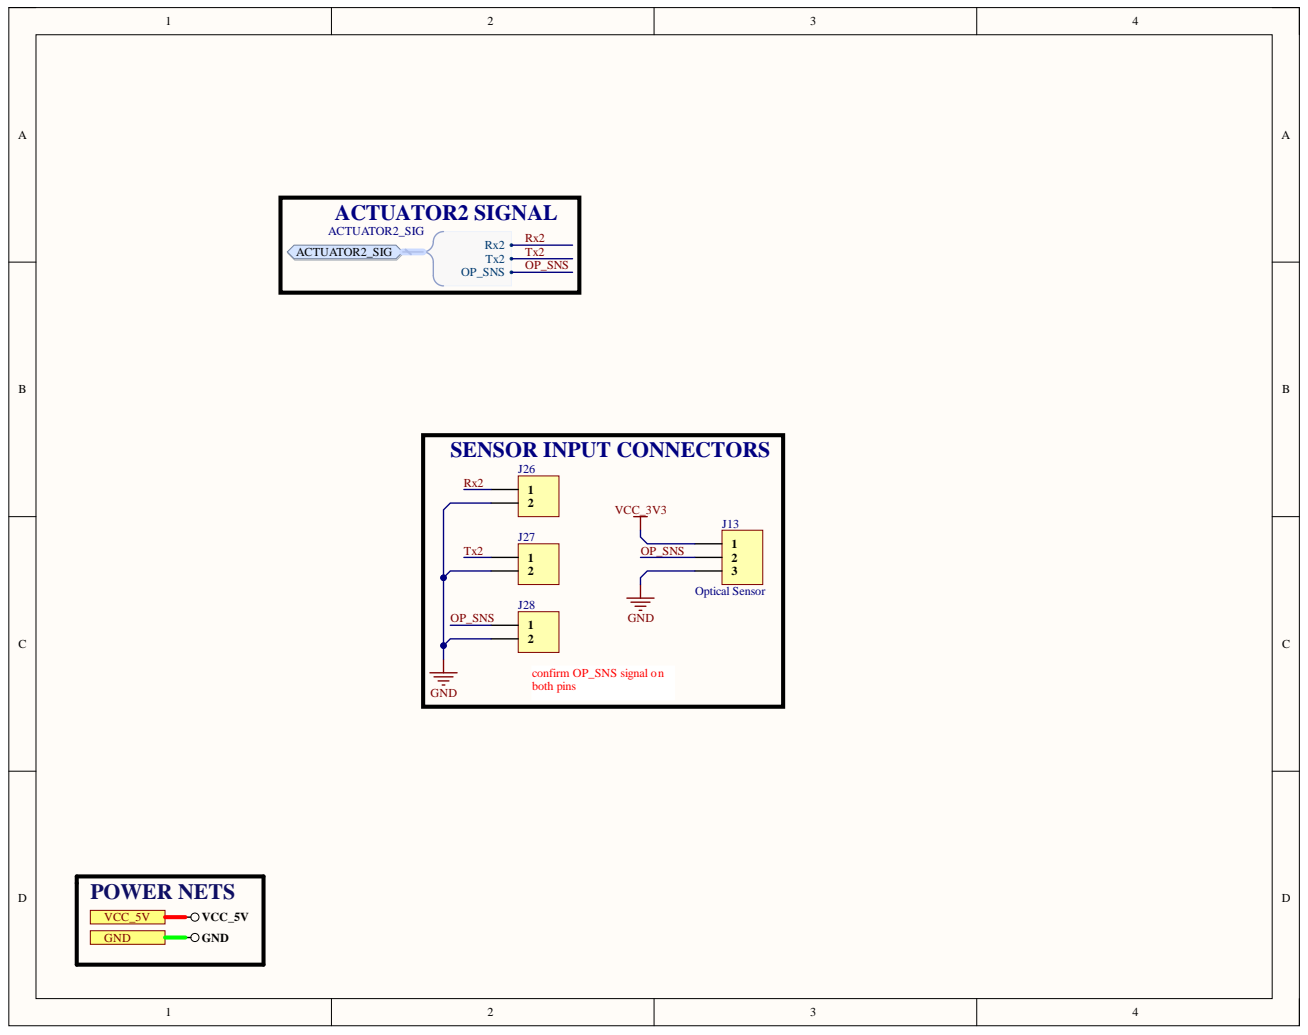
[picture p74: page 11]

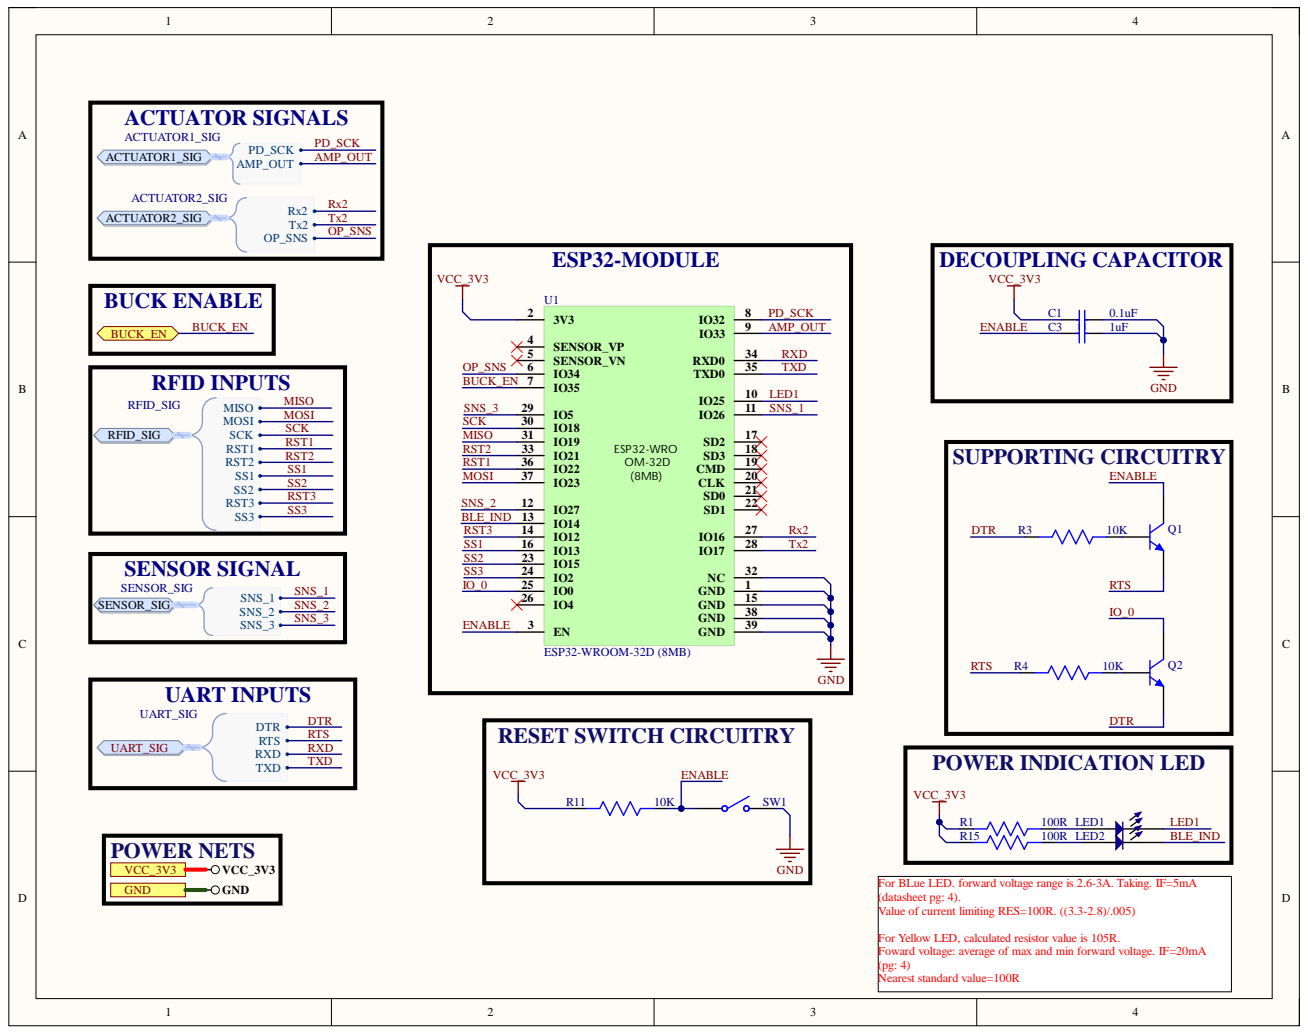
[picture p75: page 12]

For BLue LED. forward voltage range is 2.6-3A. Taking. IF=5mA
(datasheet pg: 4).
Value of current limiting RES=100R. ((3.3-2.8)/.005)

For Yellow LED, calculated resistor value is 105R.
Foward voltage: average of max and min forward voltage. IF=20mA
Nearest standard value=100R

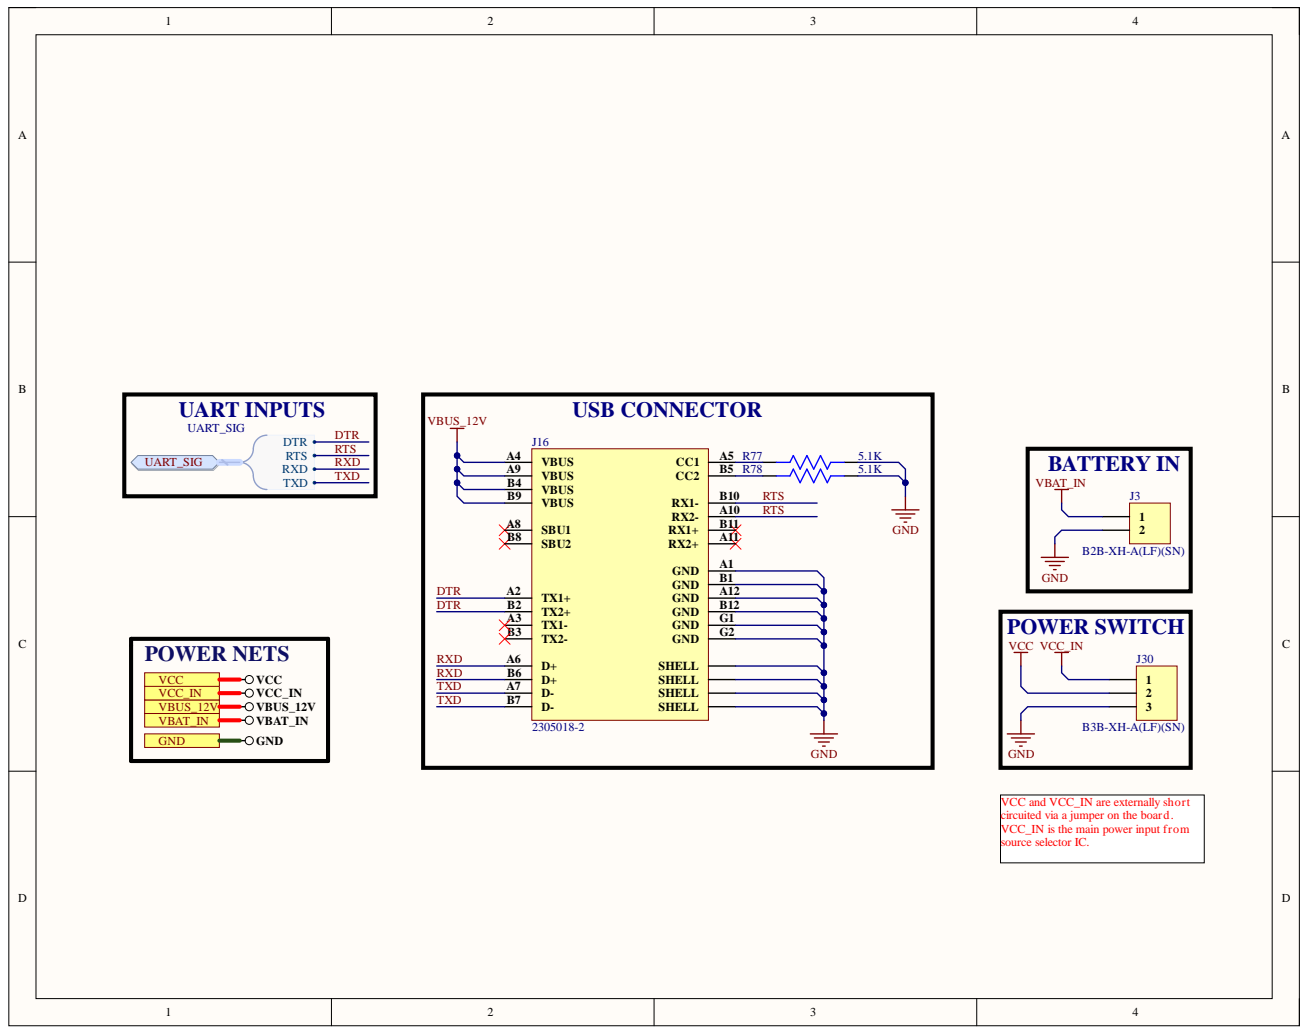
[picture p76: page 13]
