eSpark-Backup/franciscogimenez-hcdshardware/Documents/Deliverables/Assembly_Drawing/Francisco Gimenez.pdf

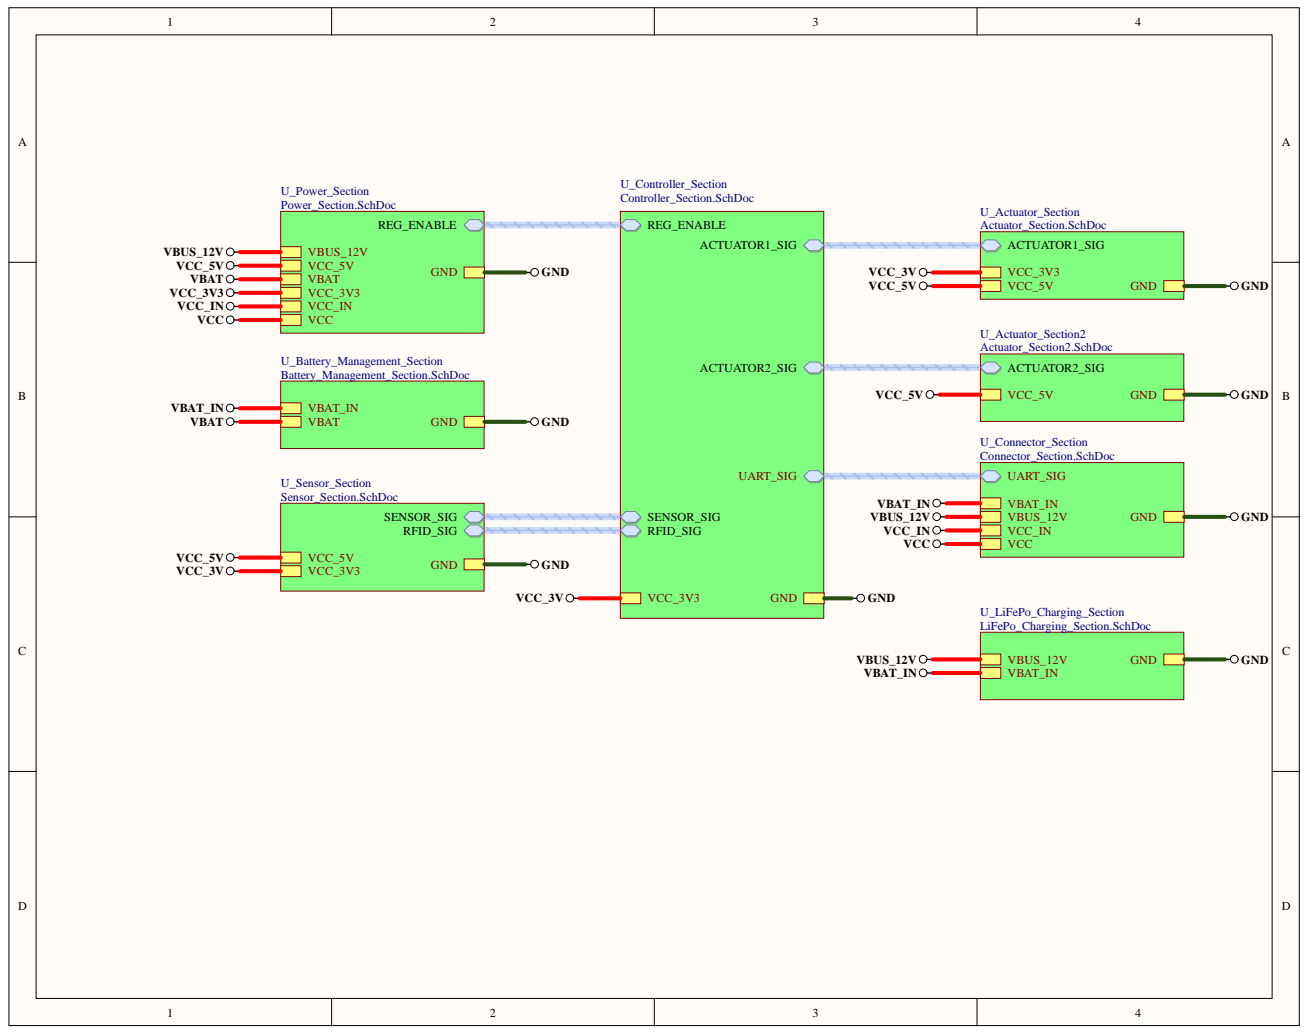
[picture p77: page 1]

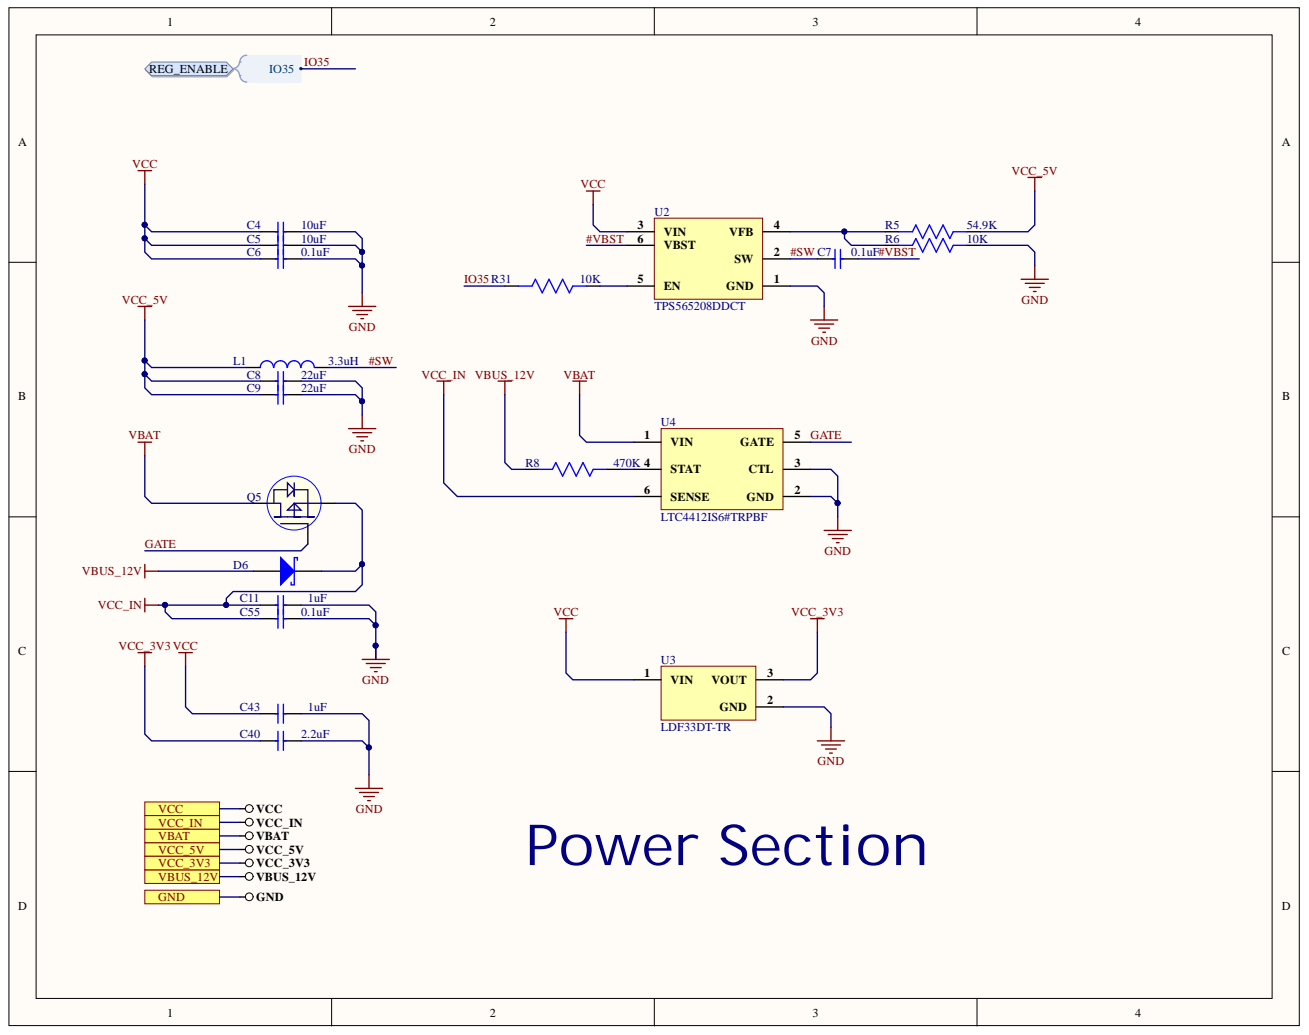
[picture p78: page 2]

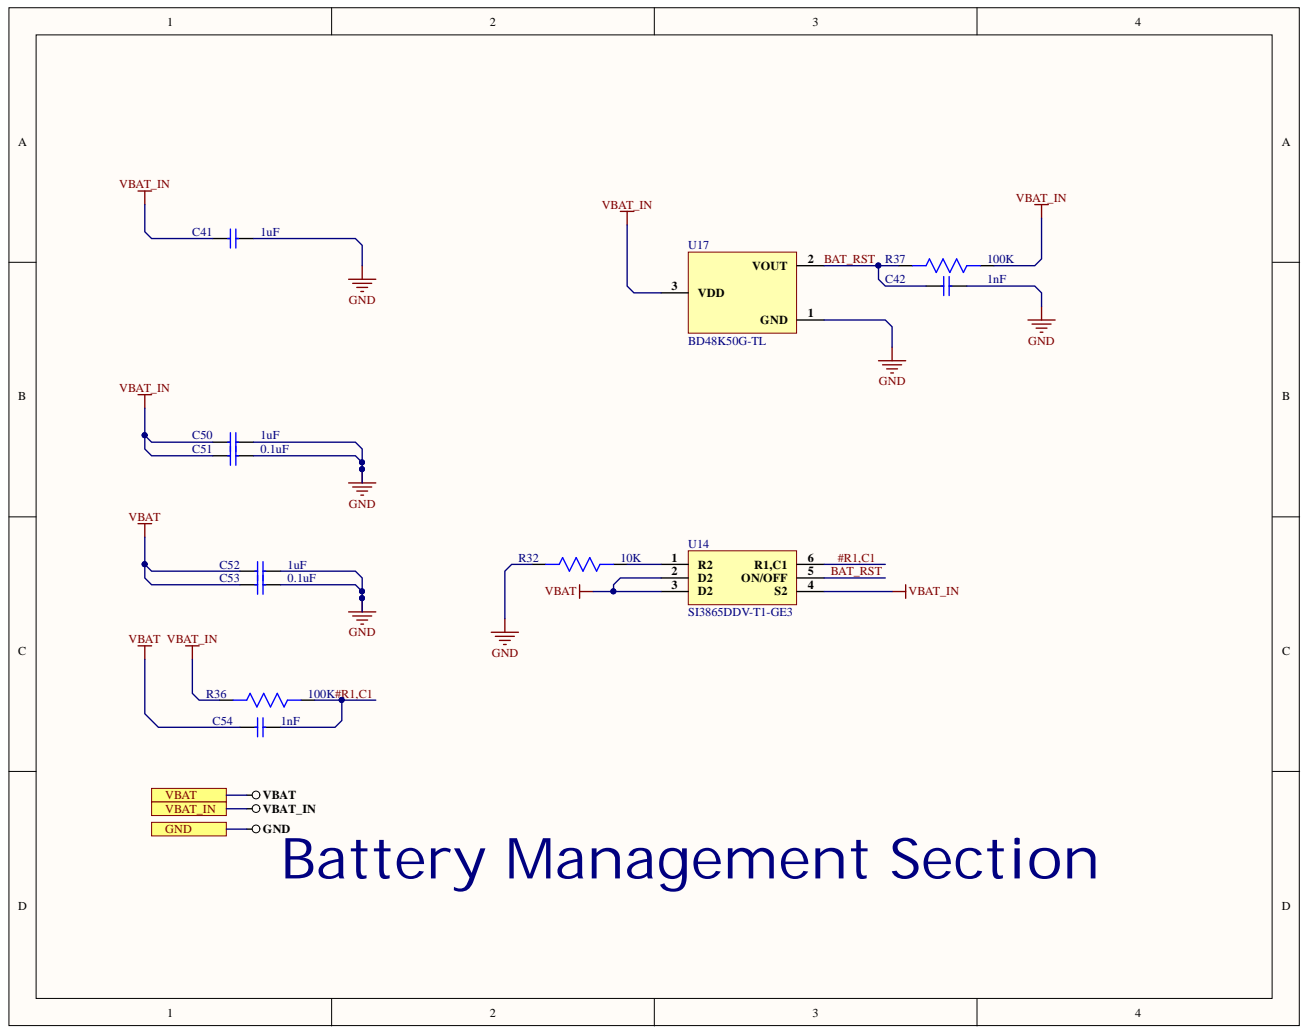
[picture p79: page 3]

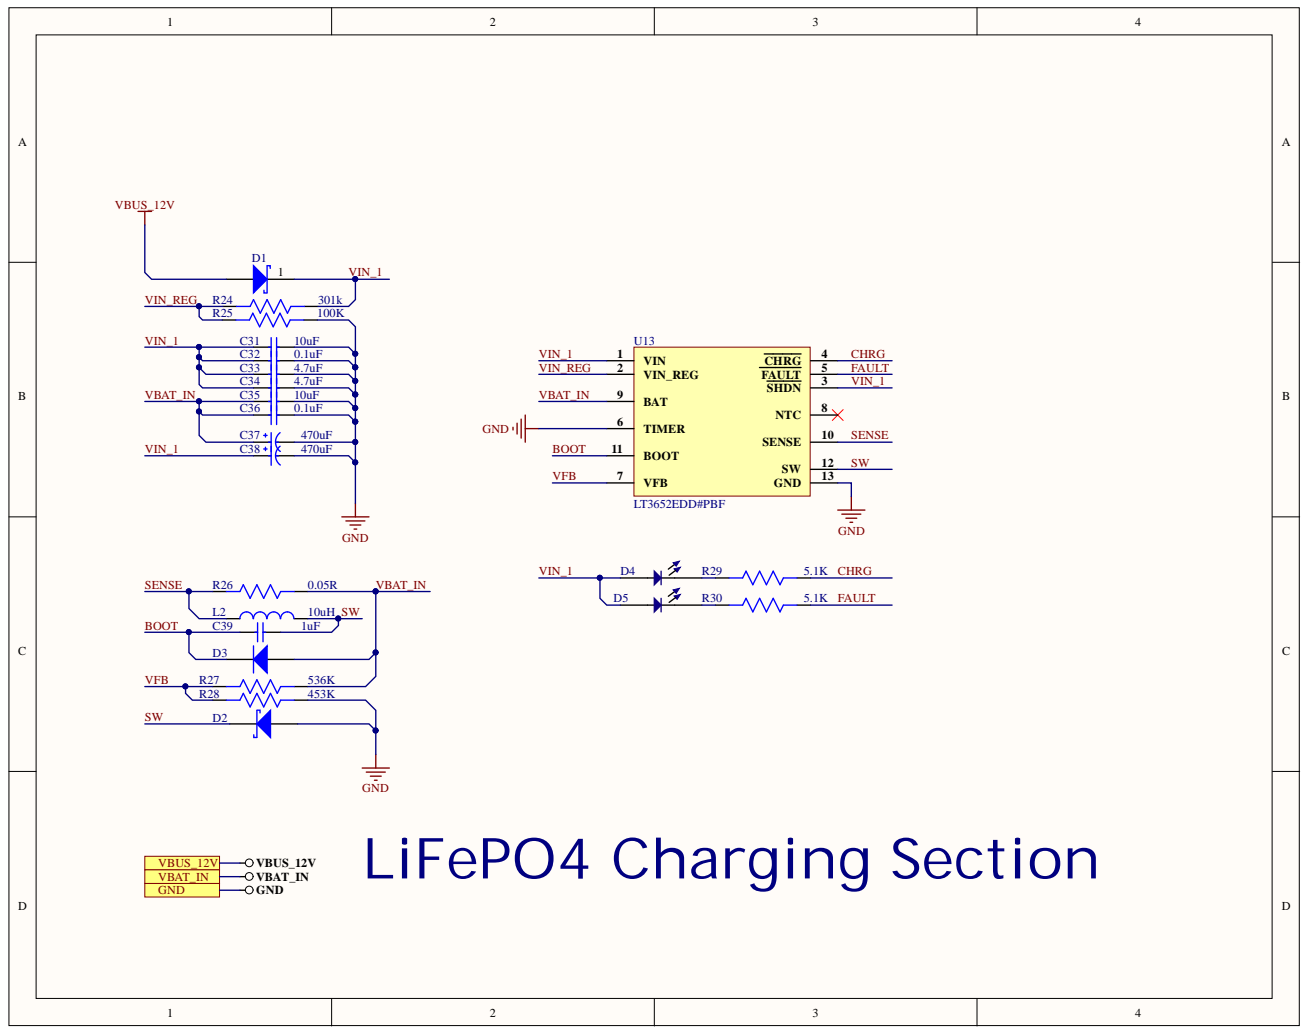
[picture p80: page 4]

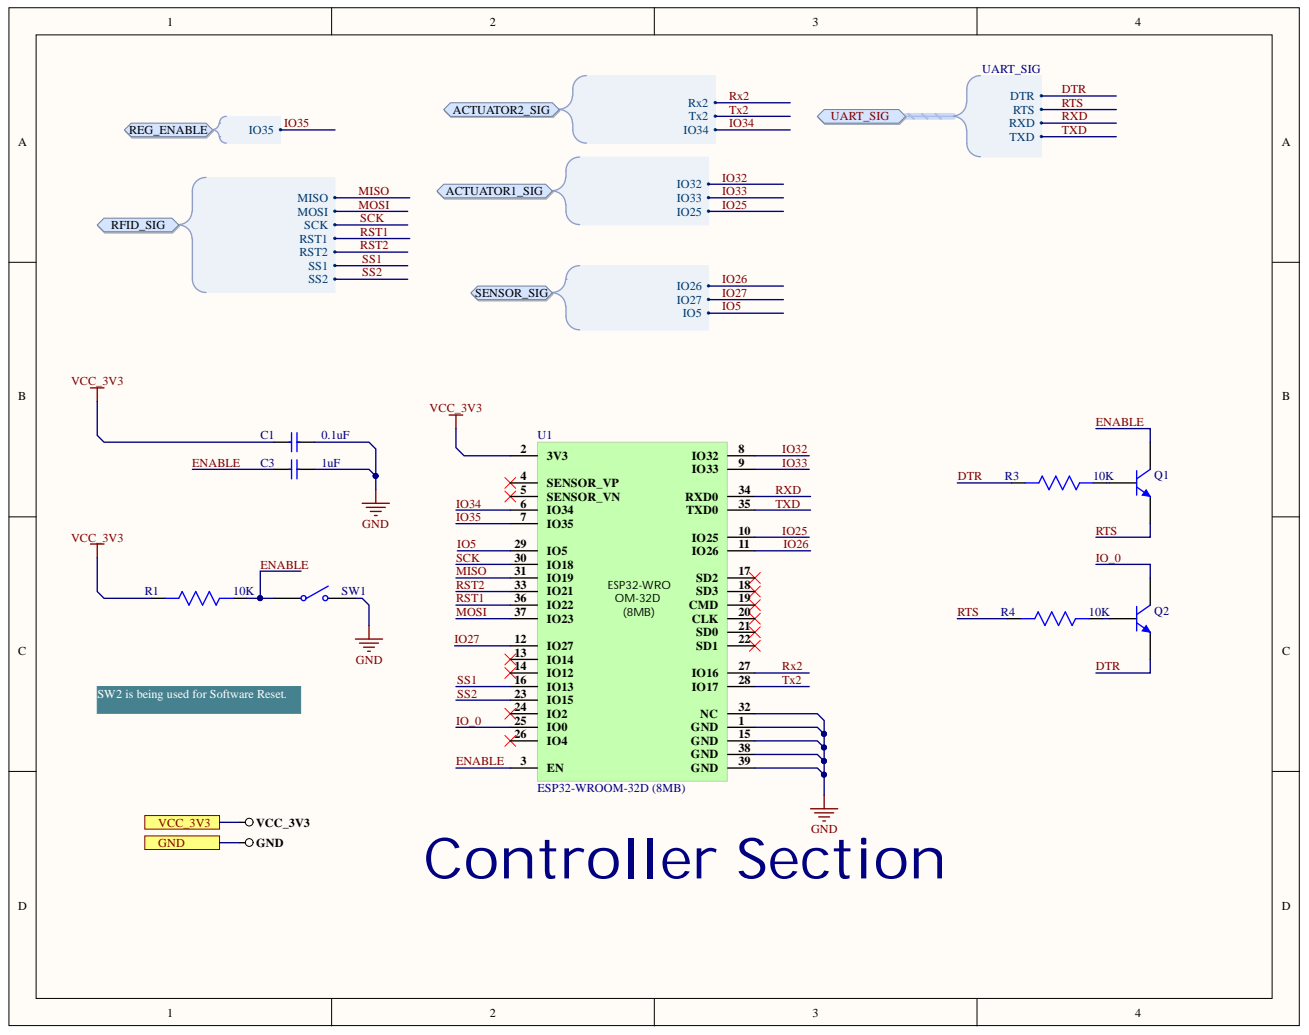
[picture p81: page 5]

SW2 is being used for Software Reset.

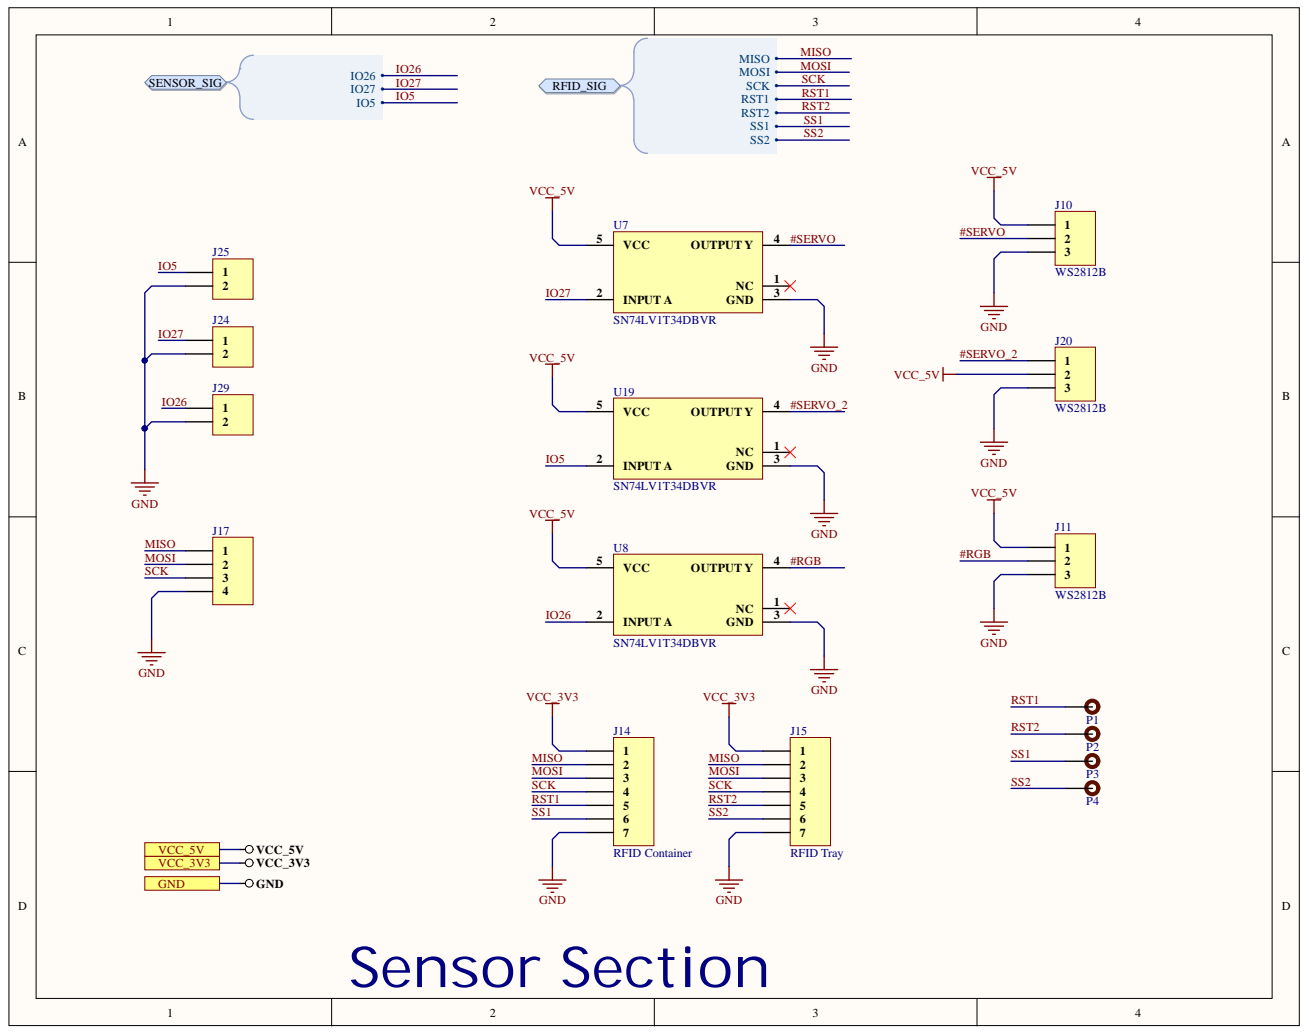
[picture p82: page 6]

Sensor Section MISO MOSI SCK

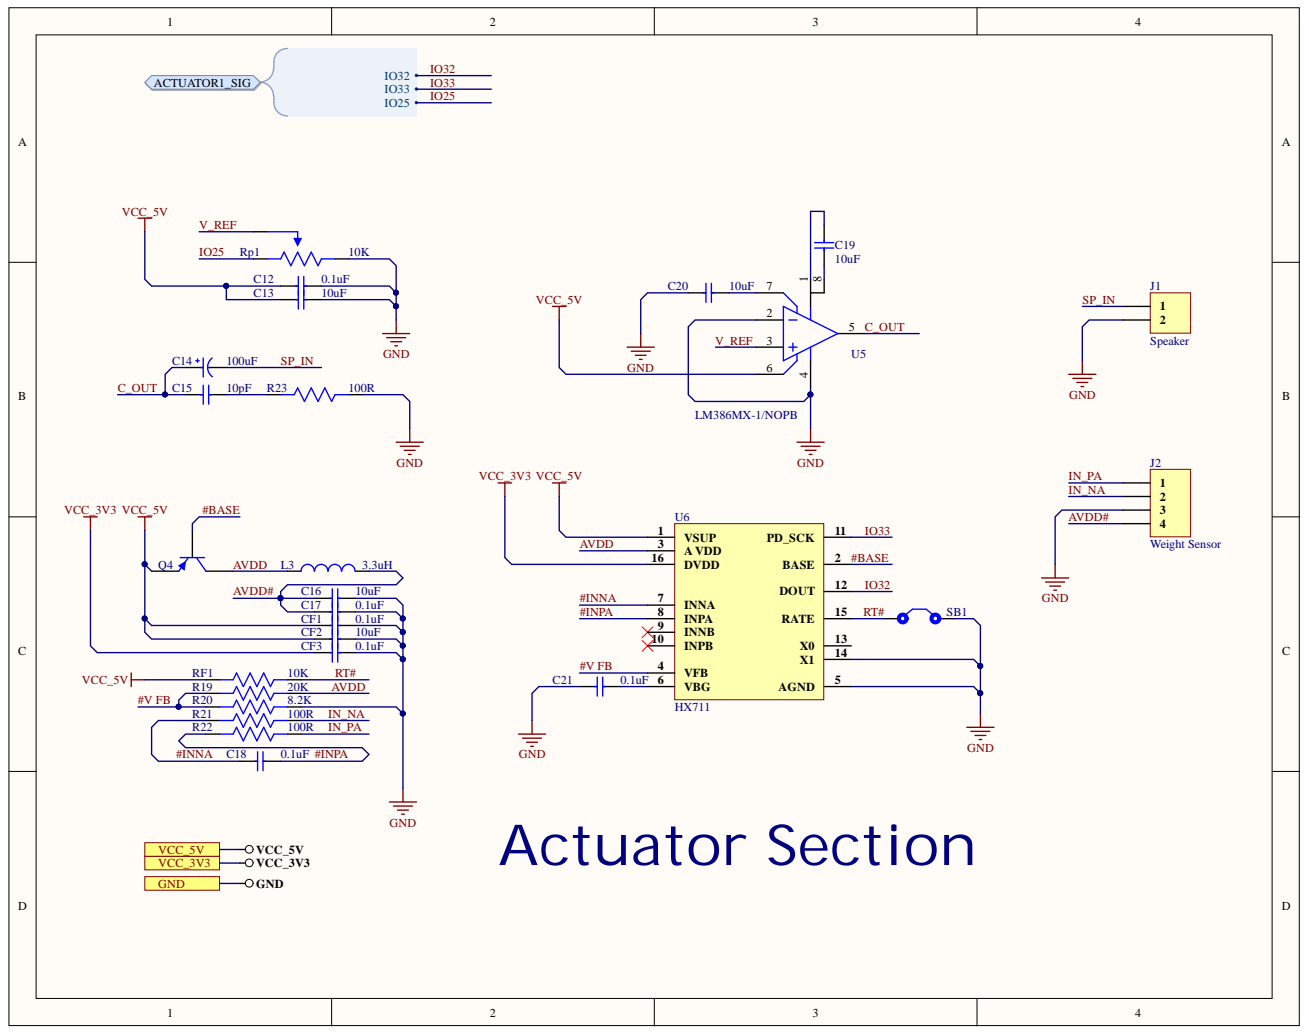
[picture p83: page 7]

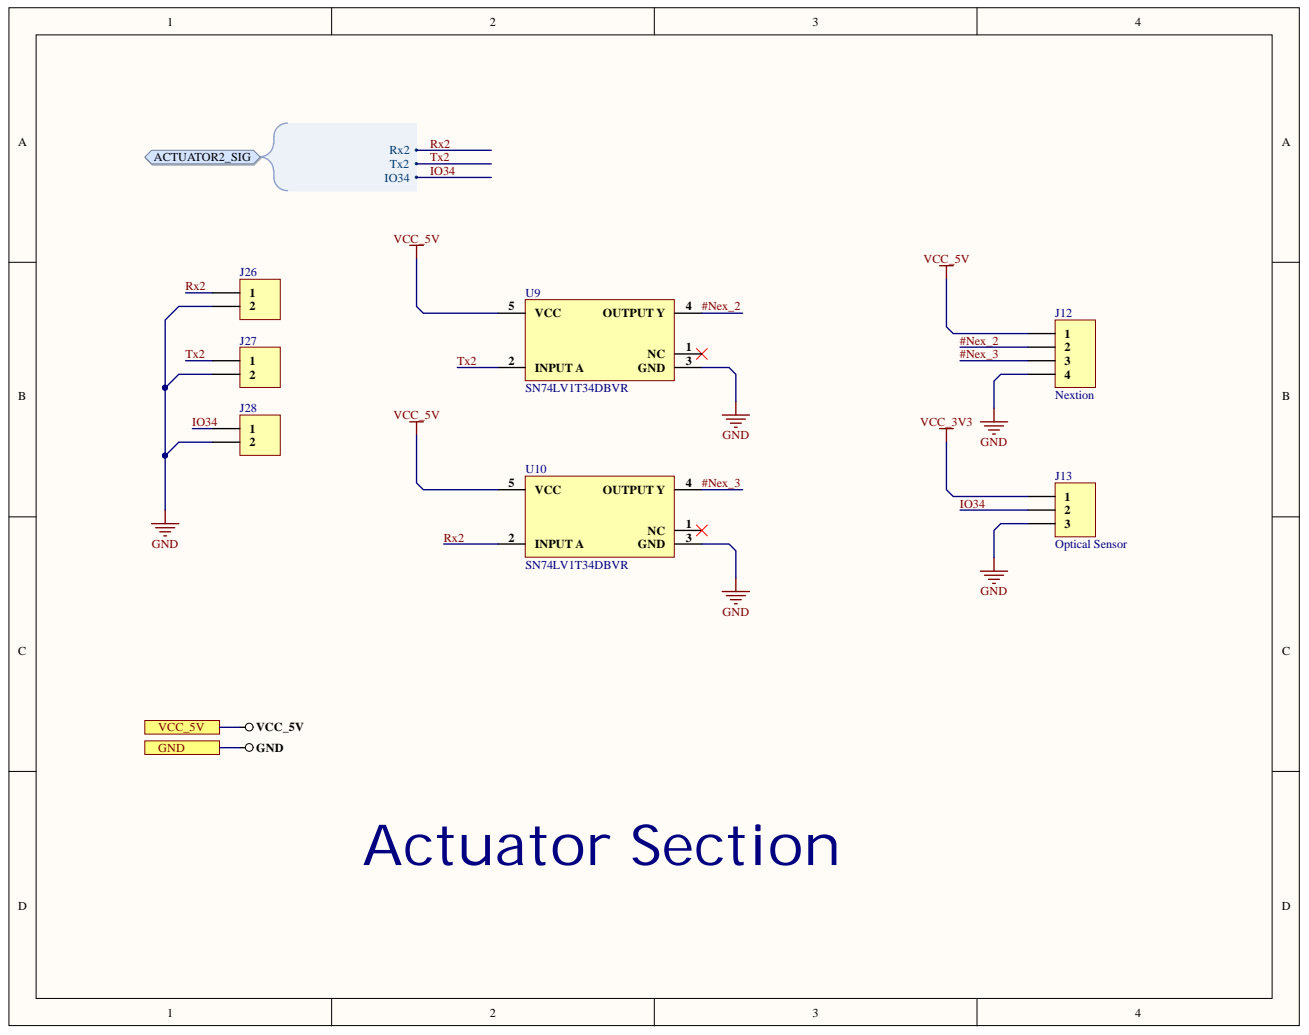
[picture p84: page 8]

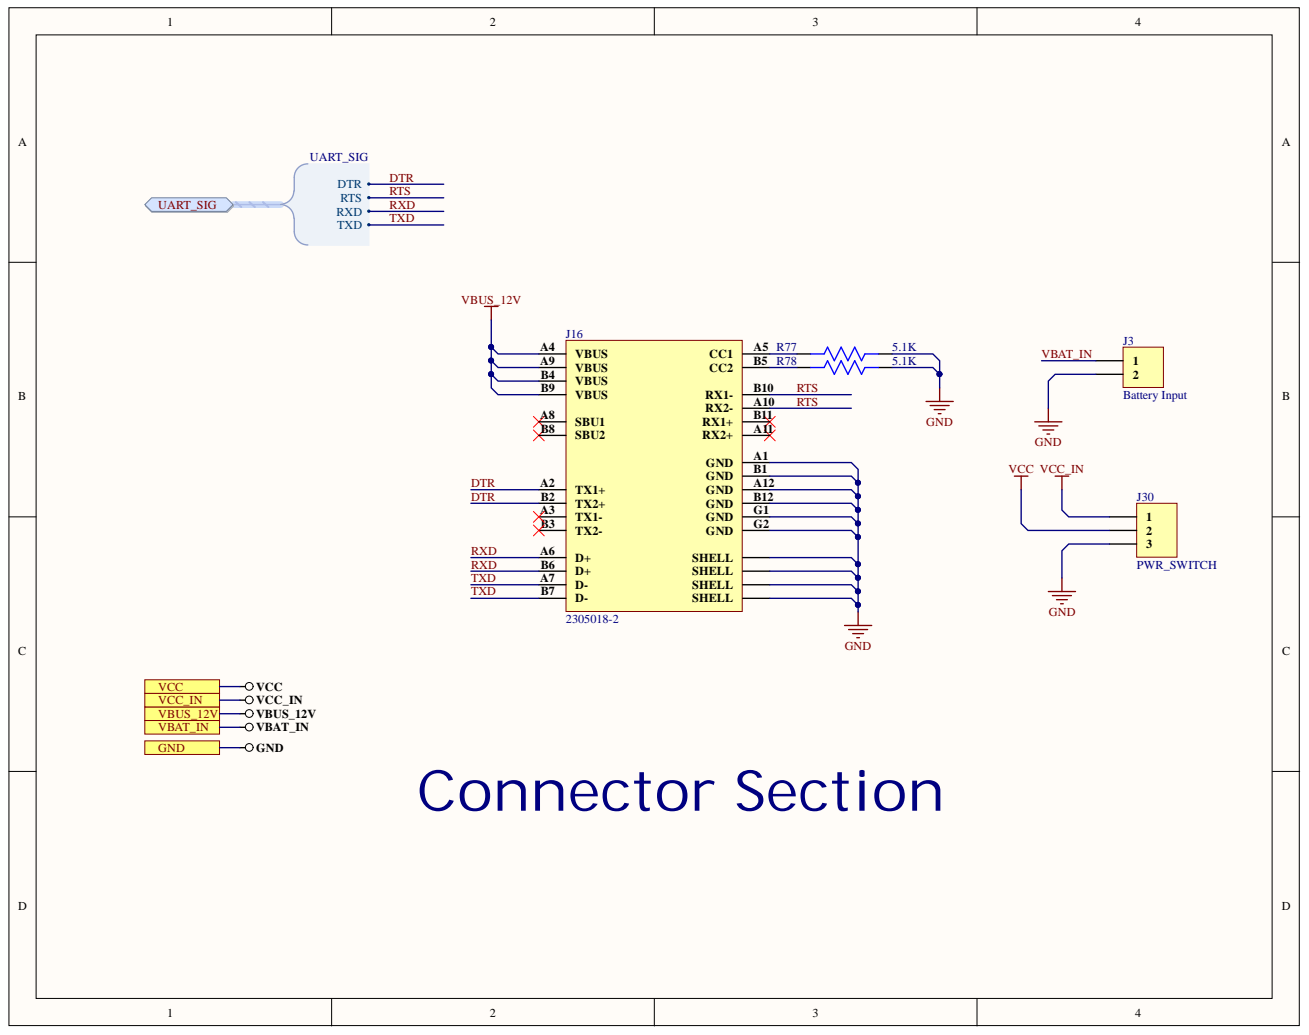
[picture p85: page 9]

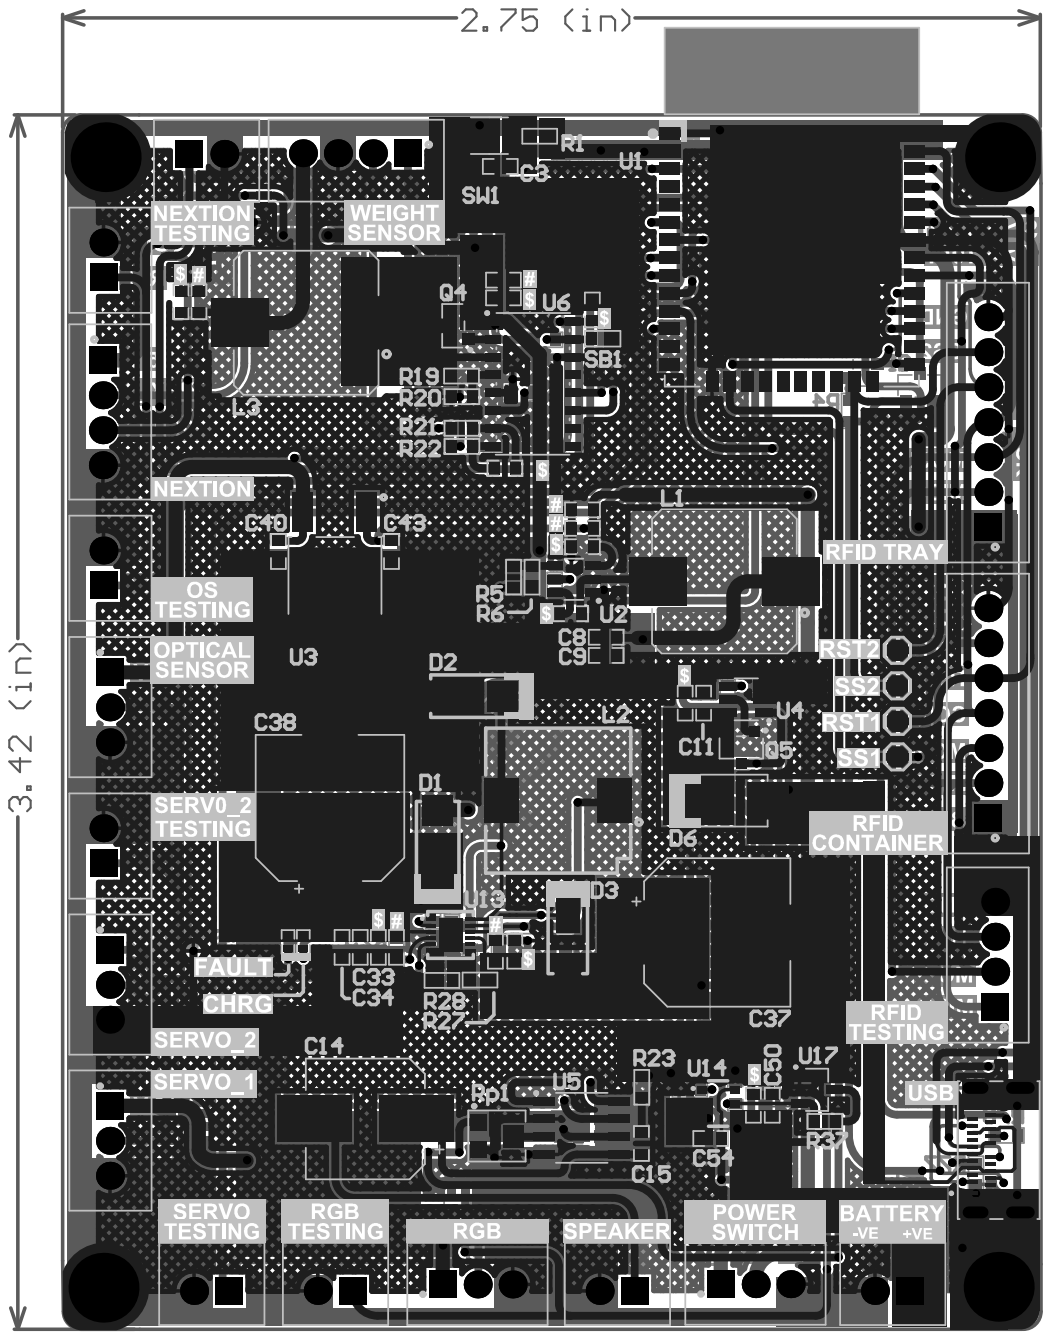
[picture p86: page 10]
