eSpark-Backup/franciscogimenez-hcdshardware/Documents/Deliverables_PB/Assembly_Drawing/Programming-Board.pdf

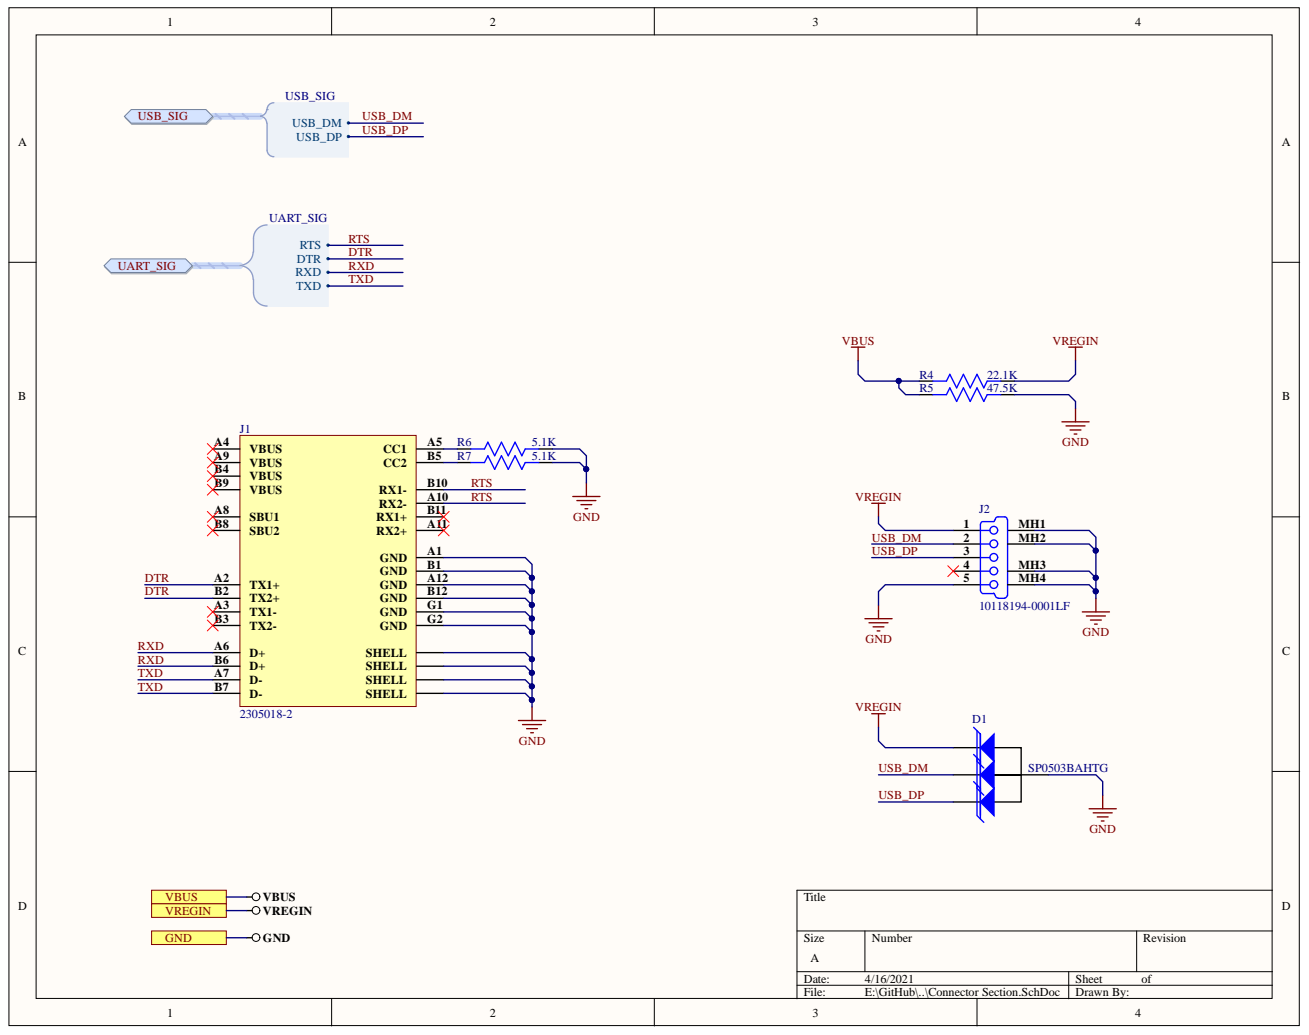
[picture p87: page 1]

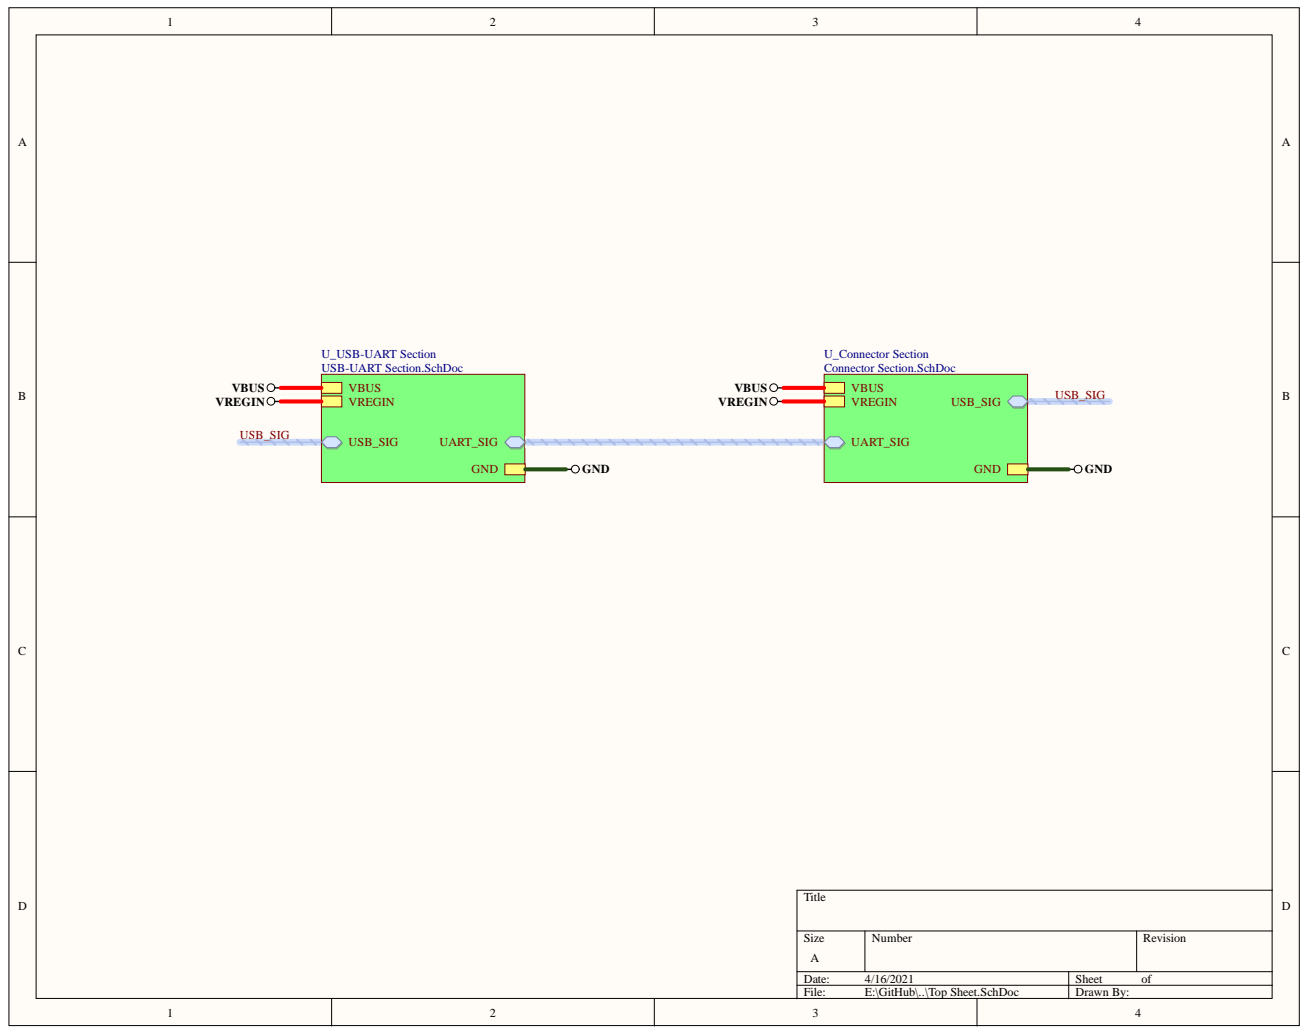
[picture p88: page 2]

U_USB-UART Section
USB-UART Section.SchDoc
VBUS
VREGIN

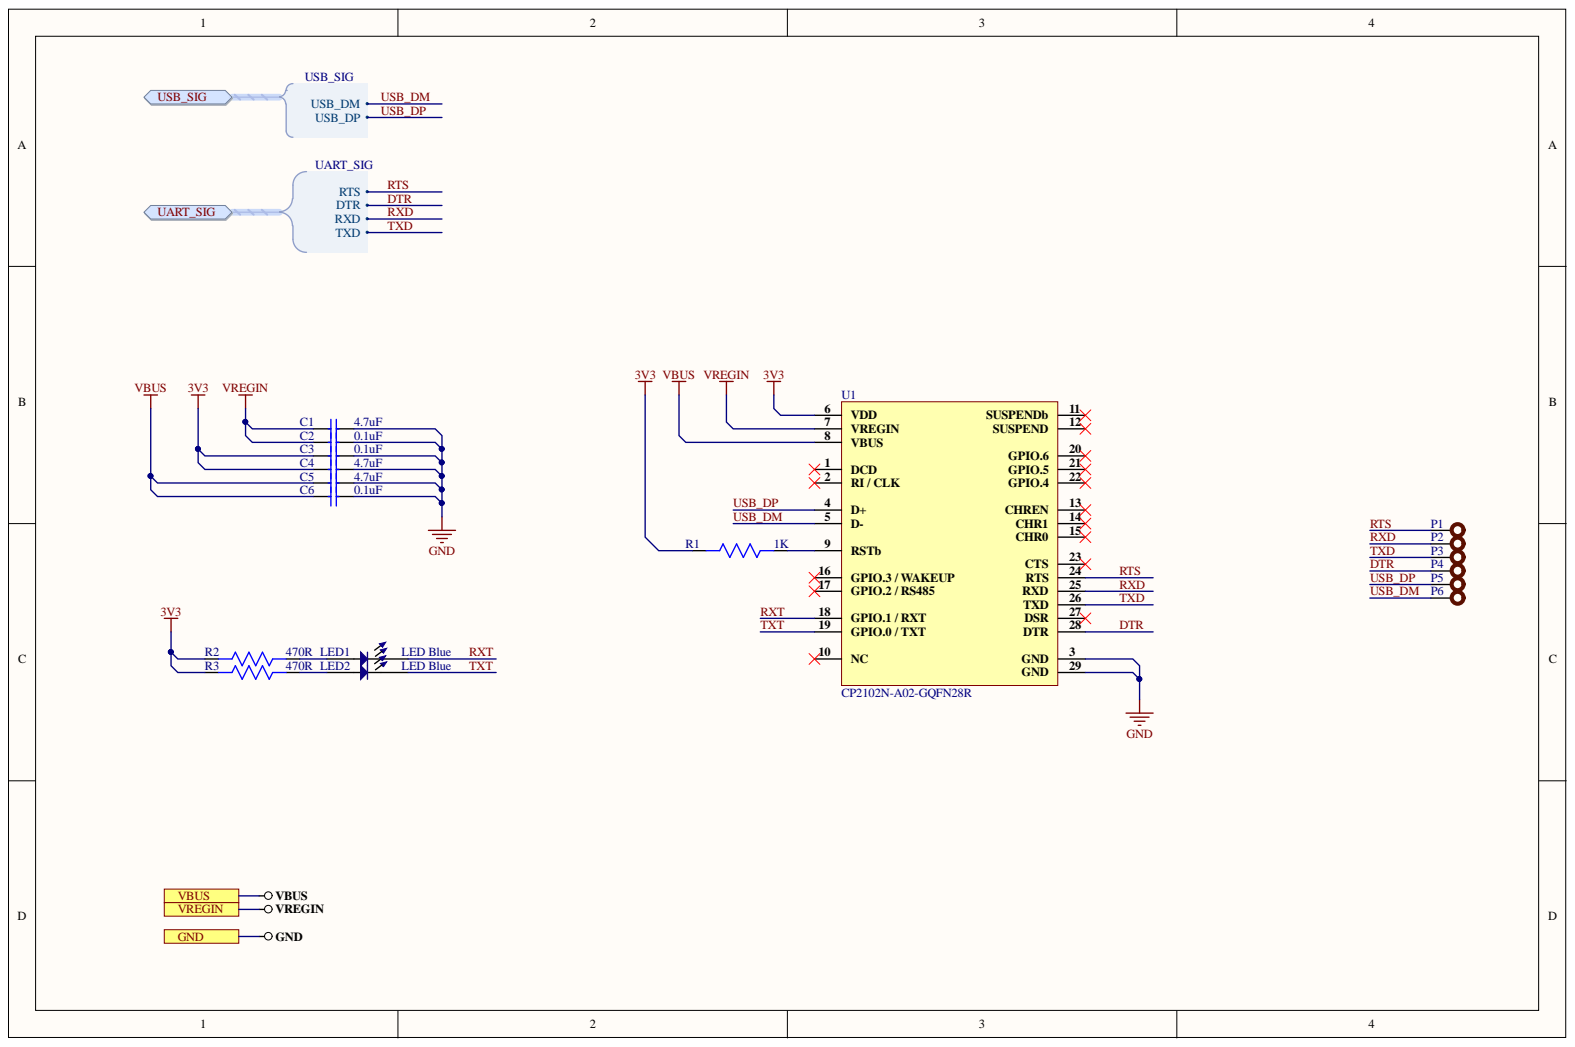
[picture p89: page 3]

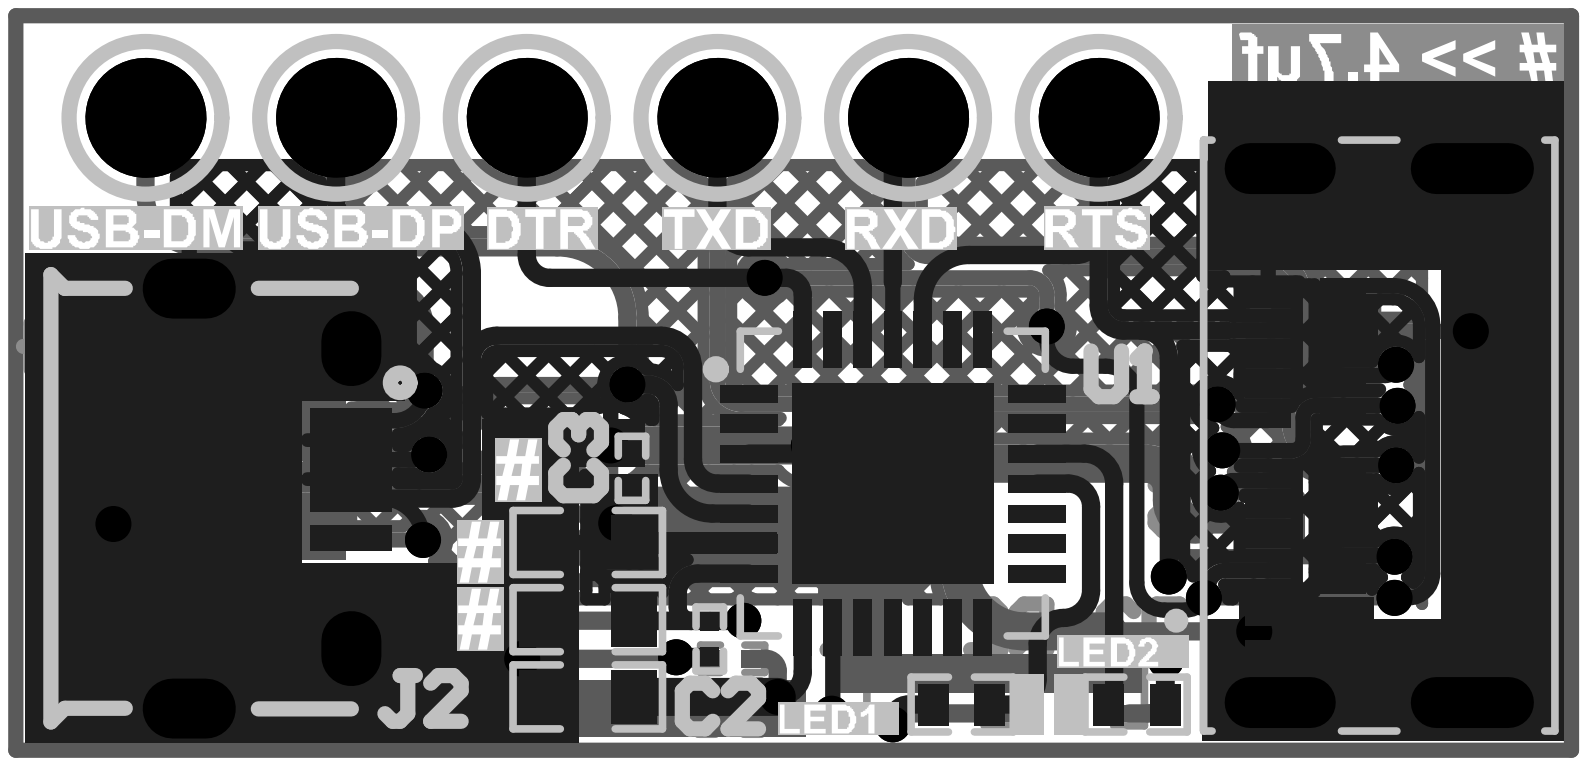
[picture p90: page 4]

Comment | Description | Designator | Footprint | LibRef | Quantity
4.7uF | CAP CER 4.7UF 25V X5R 0603 | C1, C4, C5 | Cap0603 | C1608X5R1E475M080A C | 3
0.1uF | CAP CER 0.1UF 25V X6S 0201 | C2, C3, C6 | CAP 0201 | GRM033C81E104KE14D | 3
SP0503BAHTG | ESD Suppressor TVS 5.5V 4-Pin(3+Tab) SOT-143 T/R | D1 | SOT-143-4 | SP0503BAHTG | 1
2305018-2 | CONN RCP USB3.1 TYPEC 24P SMD RA | J1 | 2305018-2 | 2305018-2 | 1
10118194-0001LF | CONN RCPT USB2.0 MICRO B SMD R/A | J2 | 10118194-0001LF | 10118194-0001LF | 1
LED Blue | LED BLUE CLEAR CHIP SMD 0402 | LED1, LED2 | LED 0402 | APHHS1005QBC/D | 2
Test Point | Test Point ON | P1, P2, P3, P4, P5, P6 | TEST POINT | TEST POINT | 6
1K | RES 1K OHM 1% 1/20W 0201 | R1 | Res-0201 | RC0201FR-071KP | 1
470R | RES SMD 470 OHM 5% 1/20W 0201 | R2, R3 | Res-0201 | RC0201JR-07470RL | 2
22.1K | RES 22.1K OHM 1% 1/20W 0201 | R4 | Res-0201 | RMCF0201FT22K1 | 1
47.5K | RES 47.5K OHM 1% 1/20W 0201 | R5 | Res-0201 | RK73H1HTTC4752F | 1
5.1K | RES 5.1K OHM 0.1% 1/20W 0201 | R6, R7 | Res-0201 | ERA-1AEB512C | 2
CP2102N-A02-GQFN28R | IC USB TO UART BRIDGE QFN28 | U1 | 28-QFN (5x5) | CP2102N-A02-GQFN28R | 1
