eSpark-Backup/franciscogimenez-hcdshardware/Documents/Client-Shared-Files/HairColorDispenser-master/PCB/Output Files/PDF/HairColorDispenser_Schematic.PDF

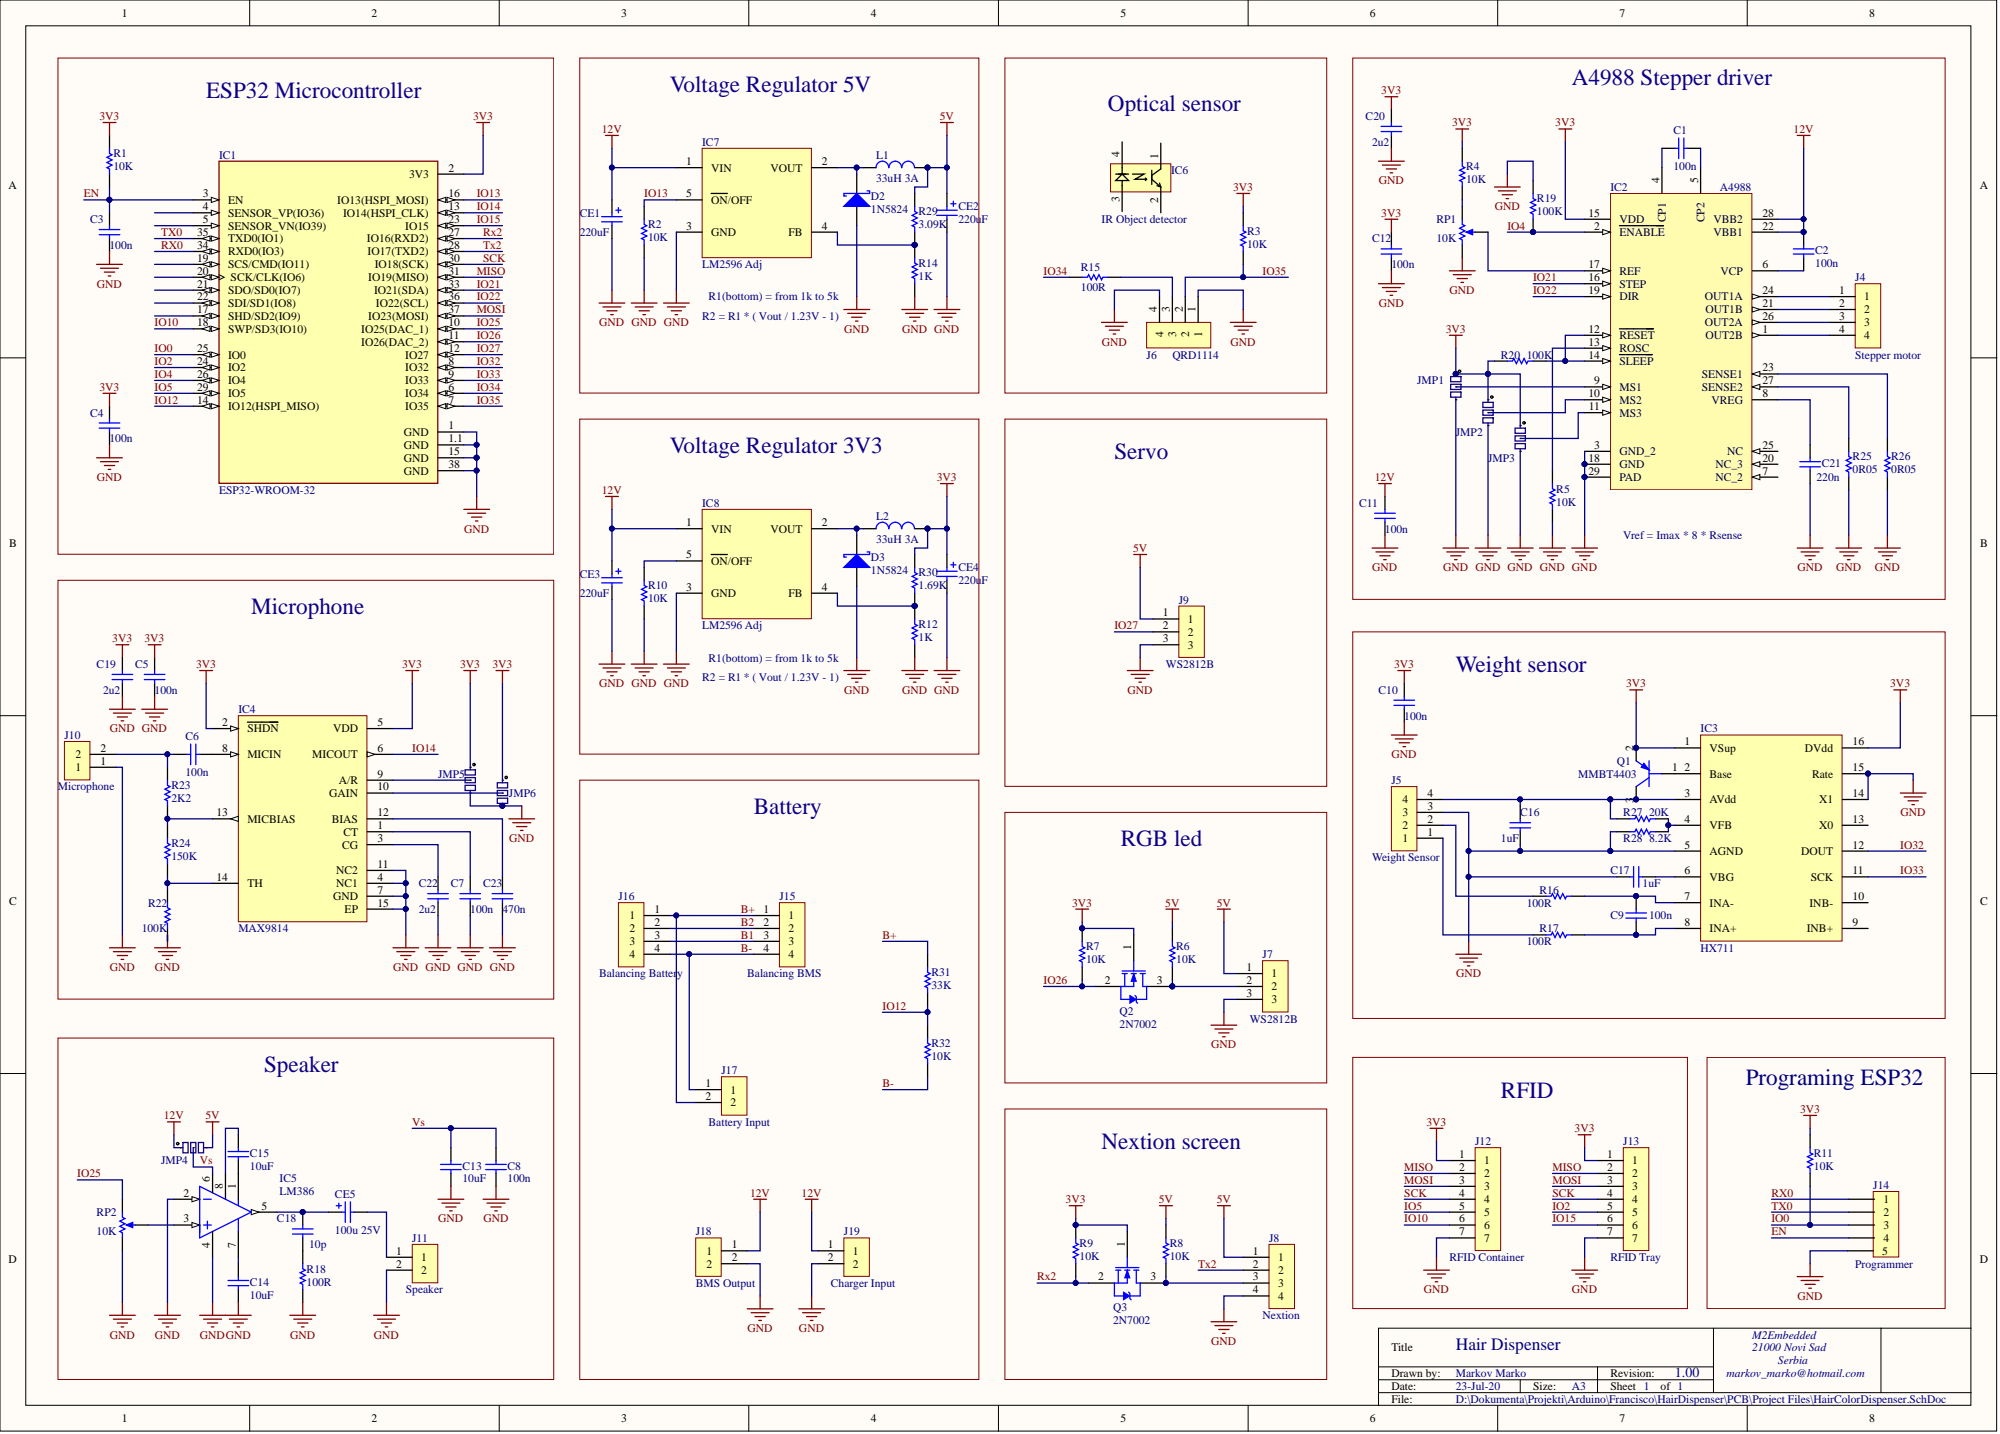
[picture p91: page 1]

MS2 10 | 8
1 1

2 | B2 2
3 | B1 3
4 | B-4

Drawn by: Markov Marko | Revision: 1.00
Date: 23-Jul-20 | Size: A3 | Sheet 1 of 1

D:\Dokumenta\Projekti\Arduino\Francisco\HairDispenser\PCB\Project Files\HairColorDispenser.SchDoc
