eSpark-Backup/franciscogimenez-hcdshardware/Documents/Client-Shared-Files/ESPProject_updated/sch.PDF

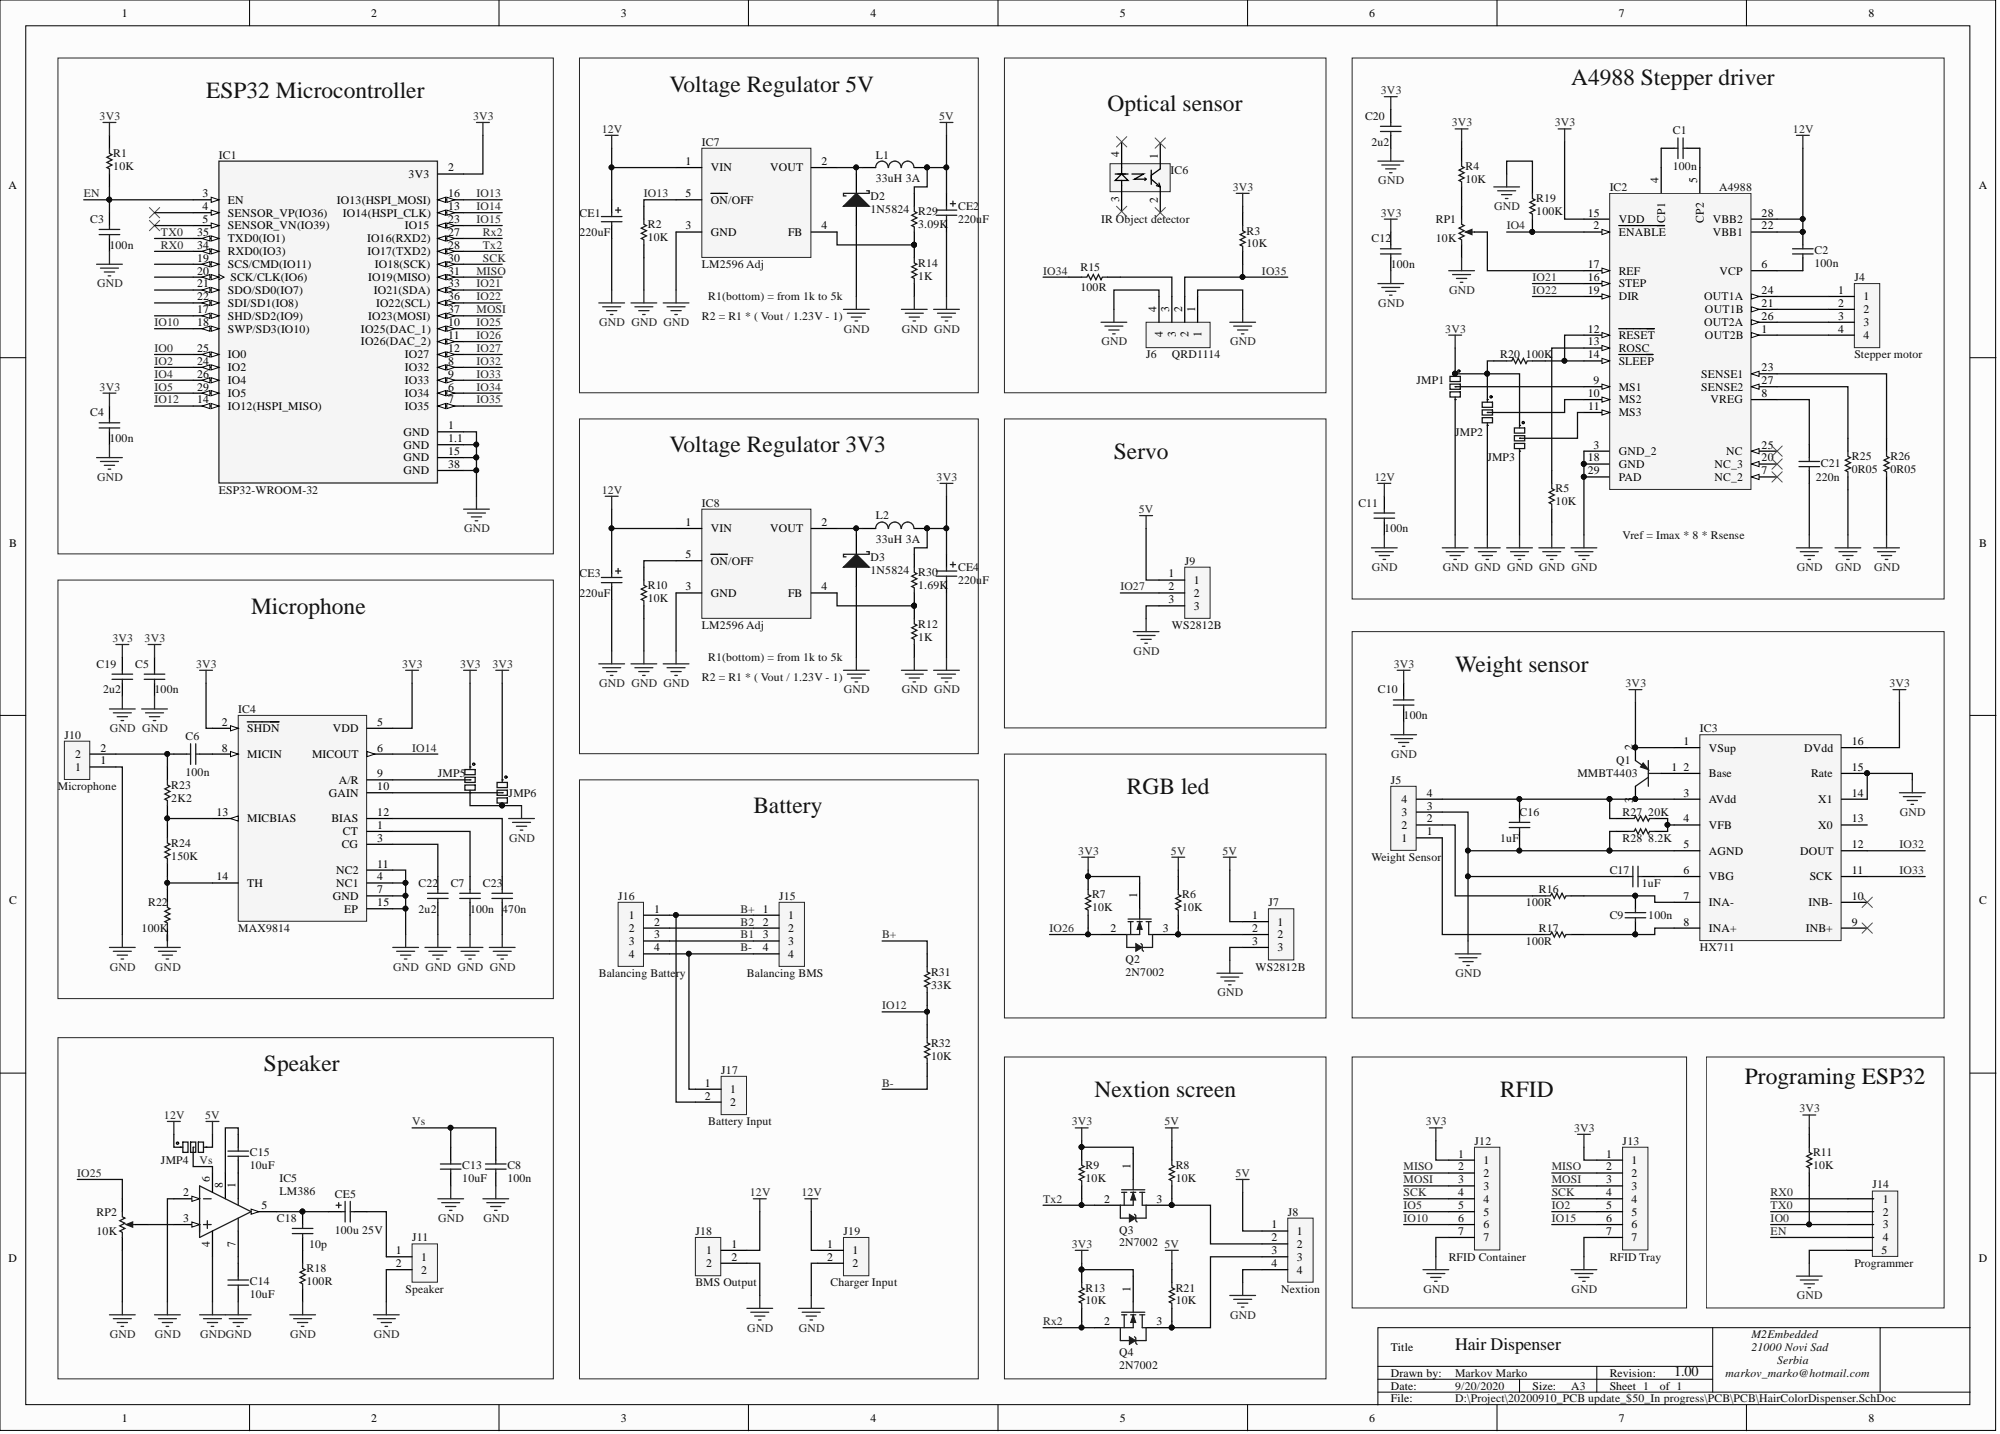
[picture p92: page 1]

SLEEP 14

MS1 9
MS2 10
MS3 11

Hair Dispenser Title | M2Embedded 21000 Novi Sad Serbia markov_marko@hotmail.com

Drawn by: | Revision:
Date: | Size: A3 | Sheet 1 of 1

D:\Project\20200910_PCB update_$50_In progress\PCB\PCB\HairColorDispenser.SchDoc

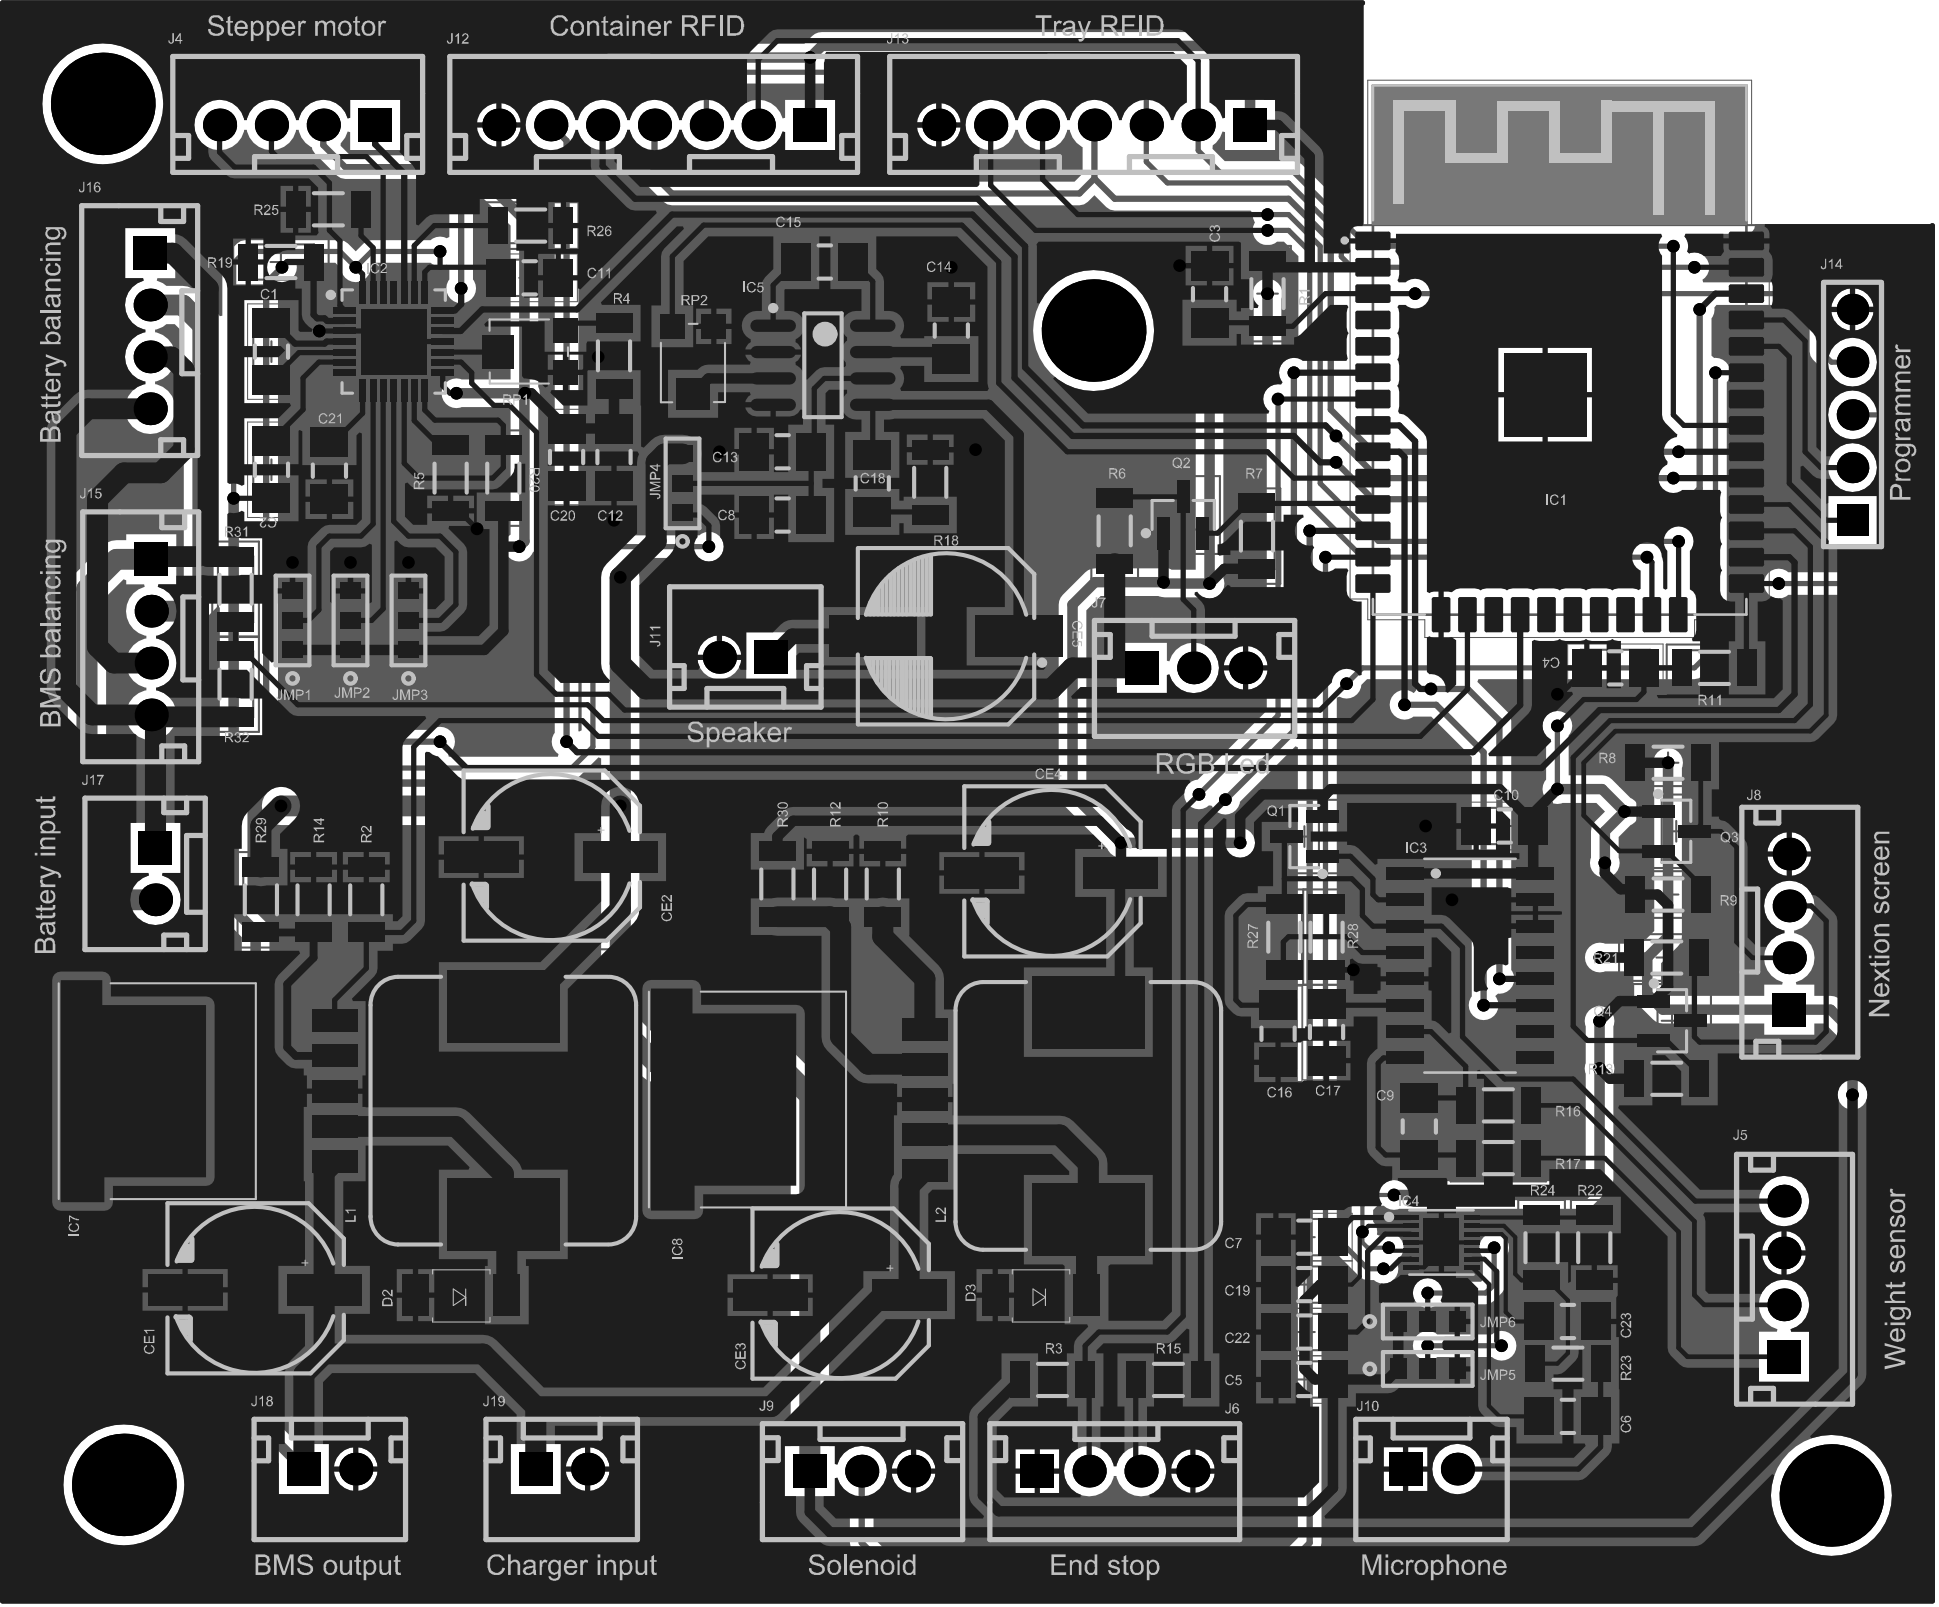
[picture p93: page 2]

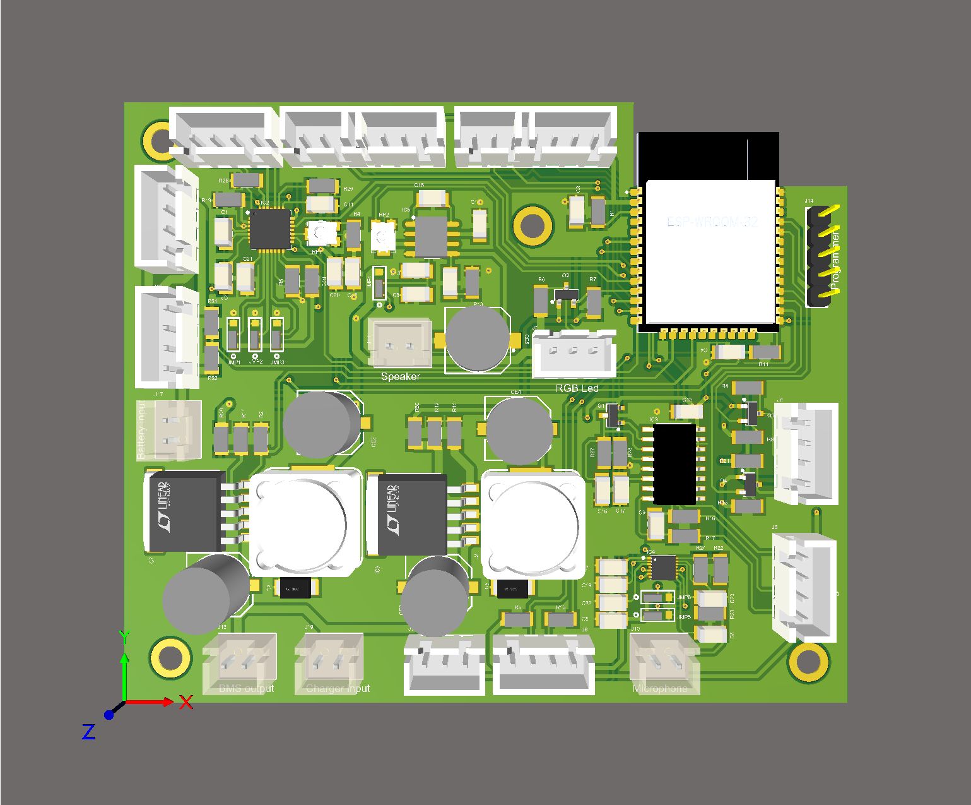
[picture p94: page 3]
