eSpark-Backup/franciscogimenez-hcdshardware/Documents/Client-Shared-Files/HairColorDispenser-master/PCB/Project Files/HairColorDispenser.pdf

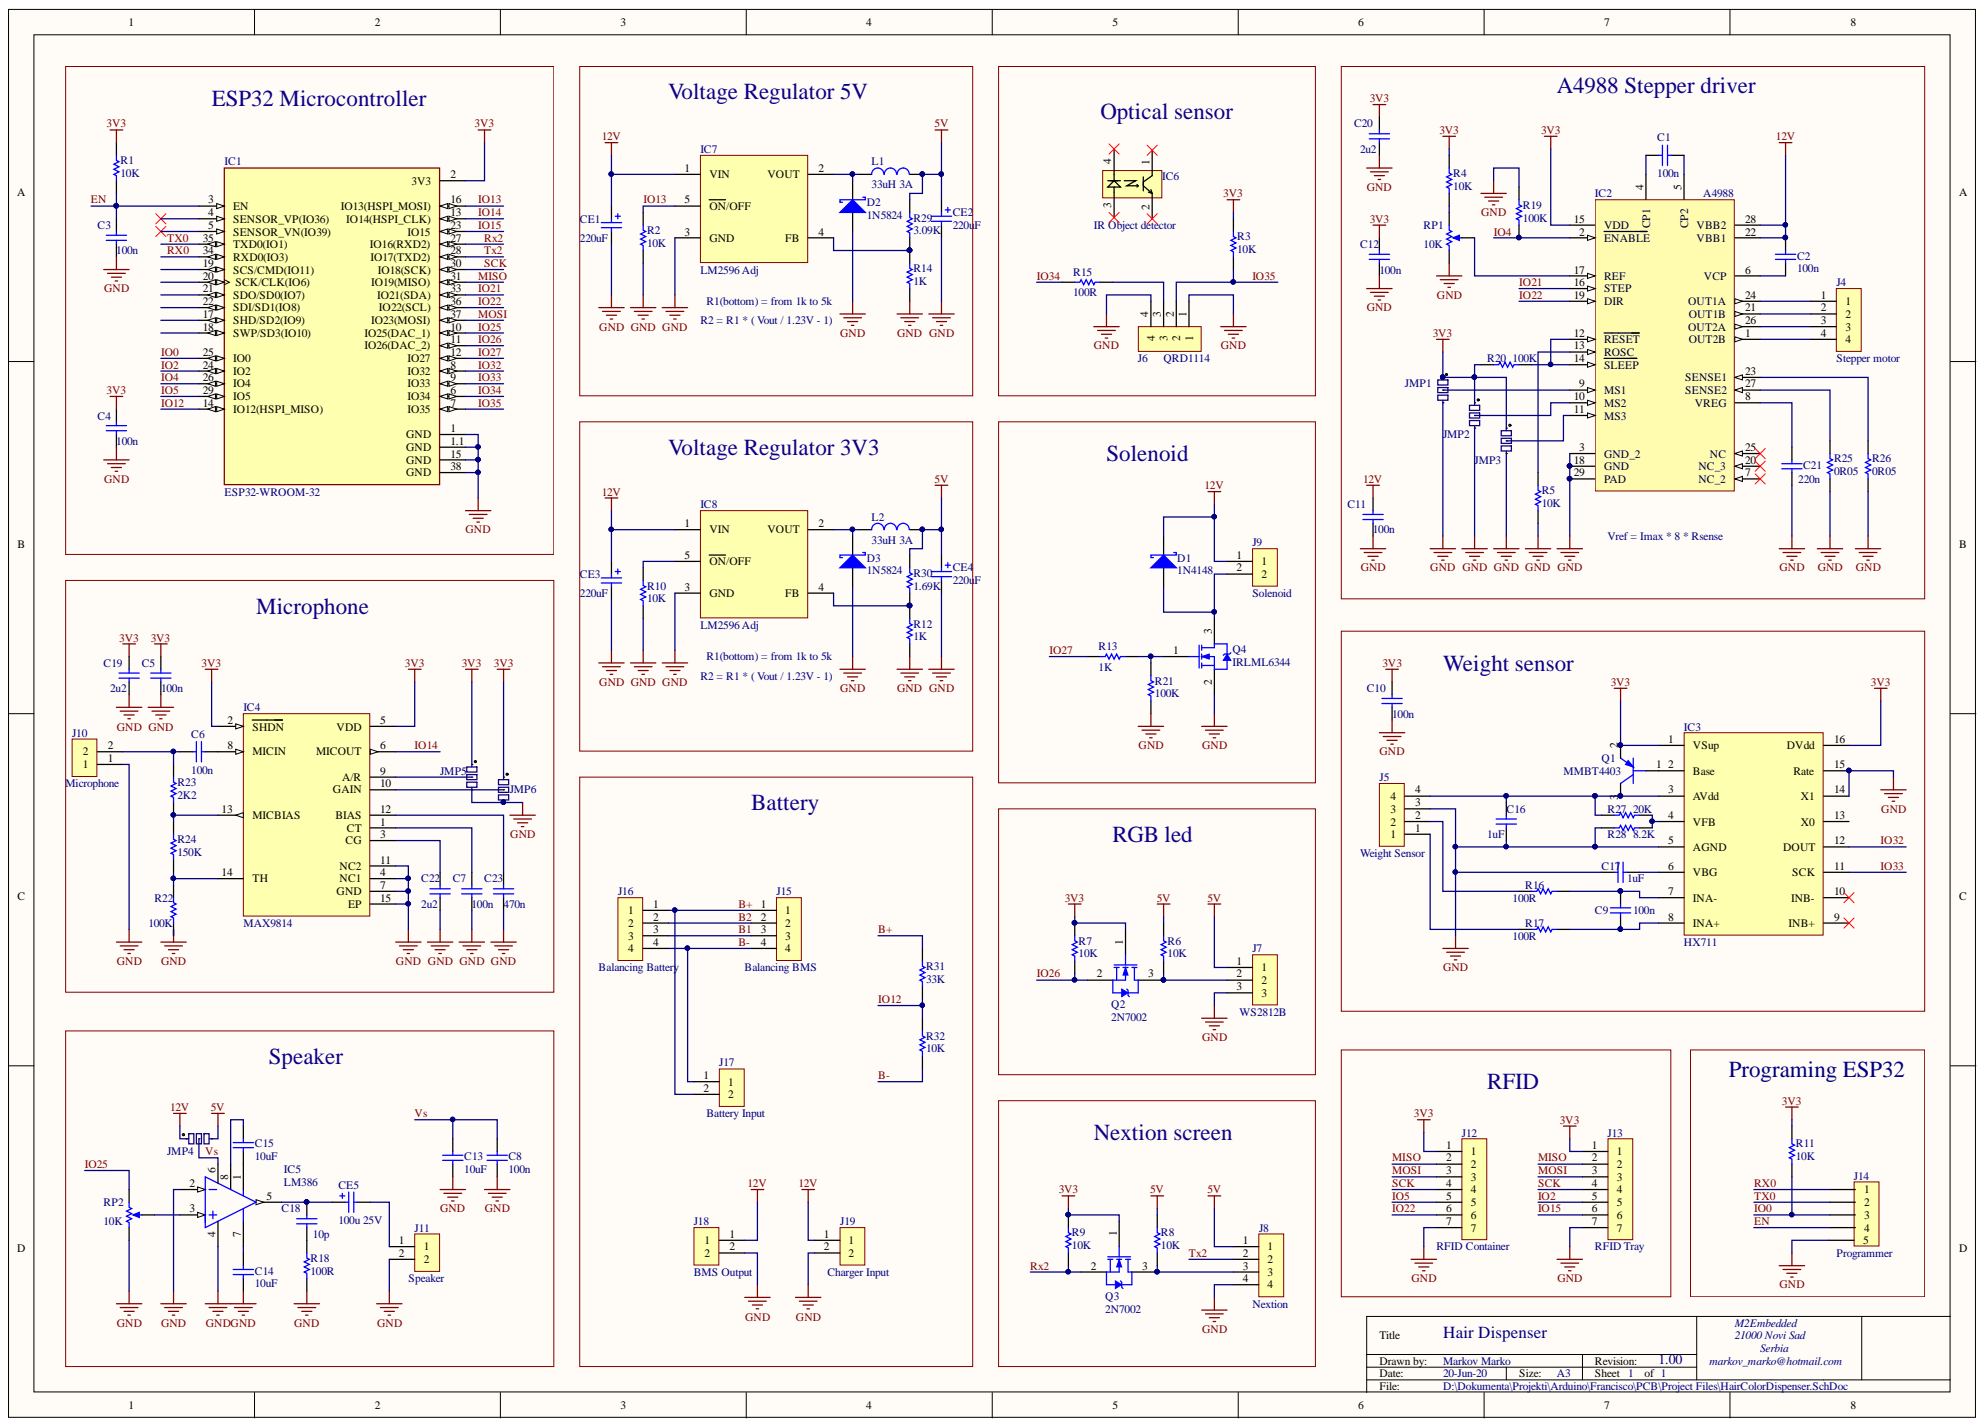
[picture p95: page 1]

R5 10K | PAD 29

Drawn by: | Revision:
Date: | Size: A3 | Sheet 1 of 1

D:\Dokumenta\Projekti\Arduino\Francisco\PCB\Project Files\HairColorDispenser.SchDoc

# Board Stack
