eSpark-Backup/franciscogimenez-hcdshardware/Documents/Deliverables/Assembly_Drawing/Assembly_Drawing.pdf

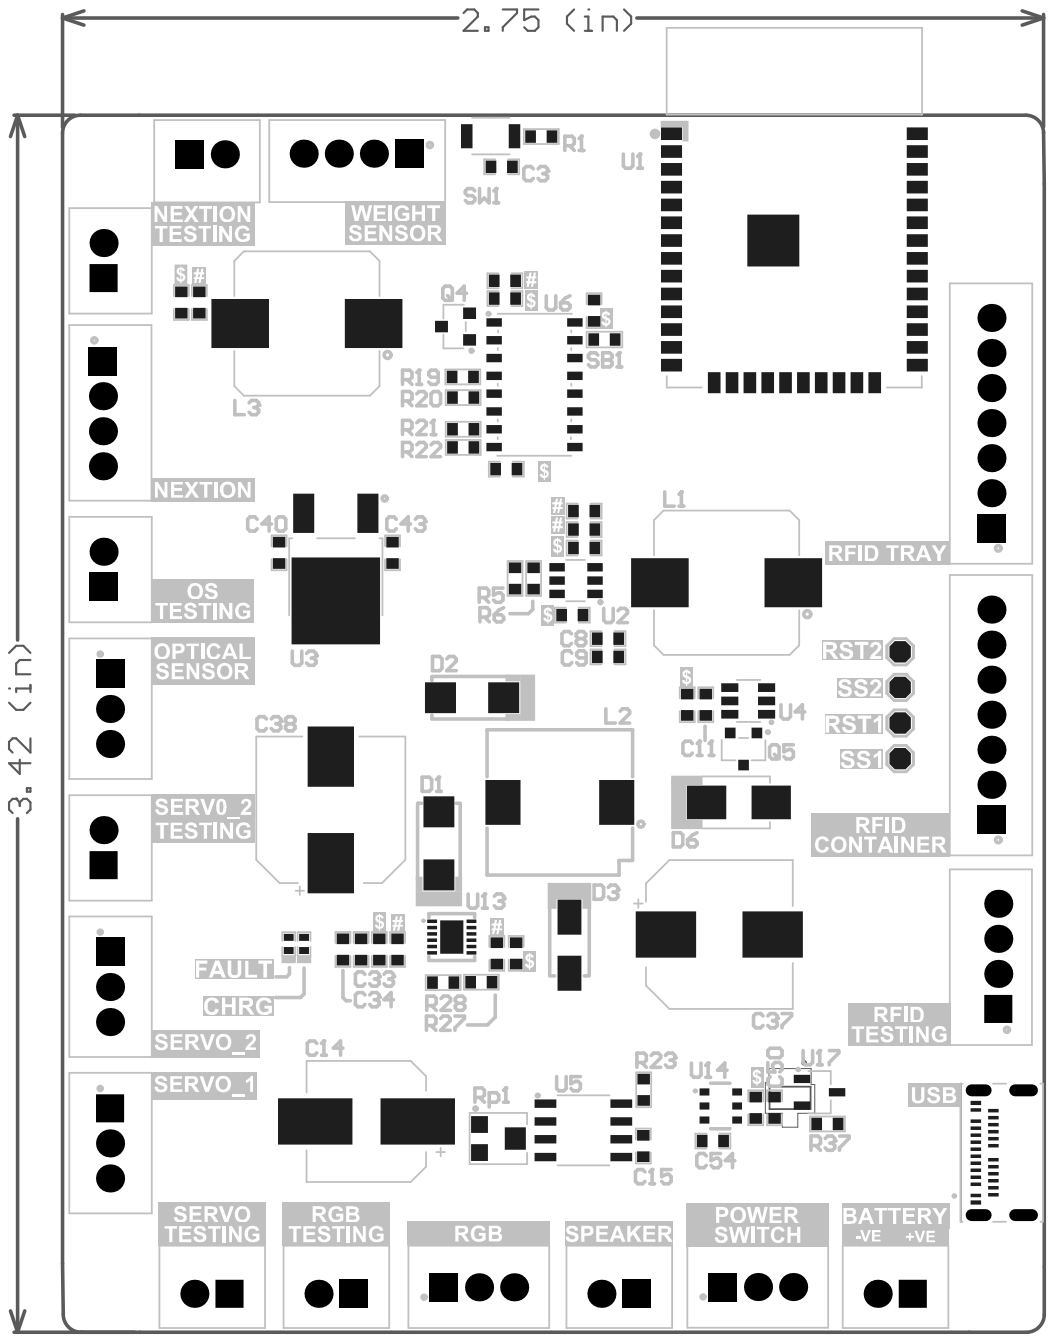
[picture p96: page 1]

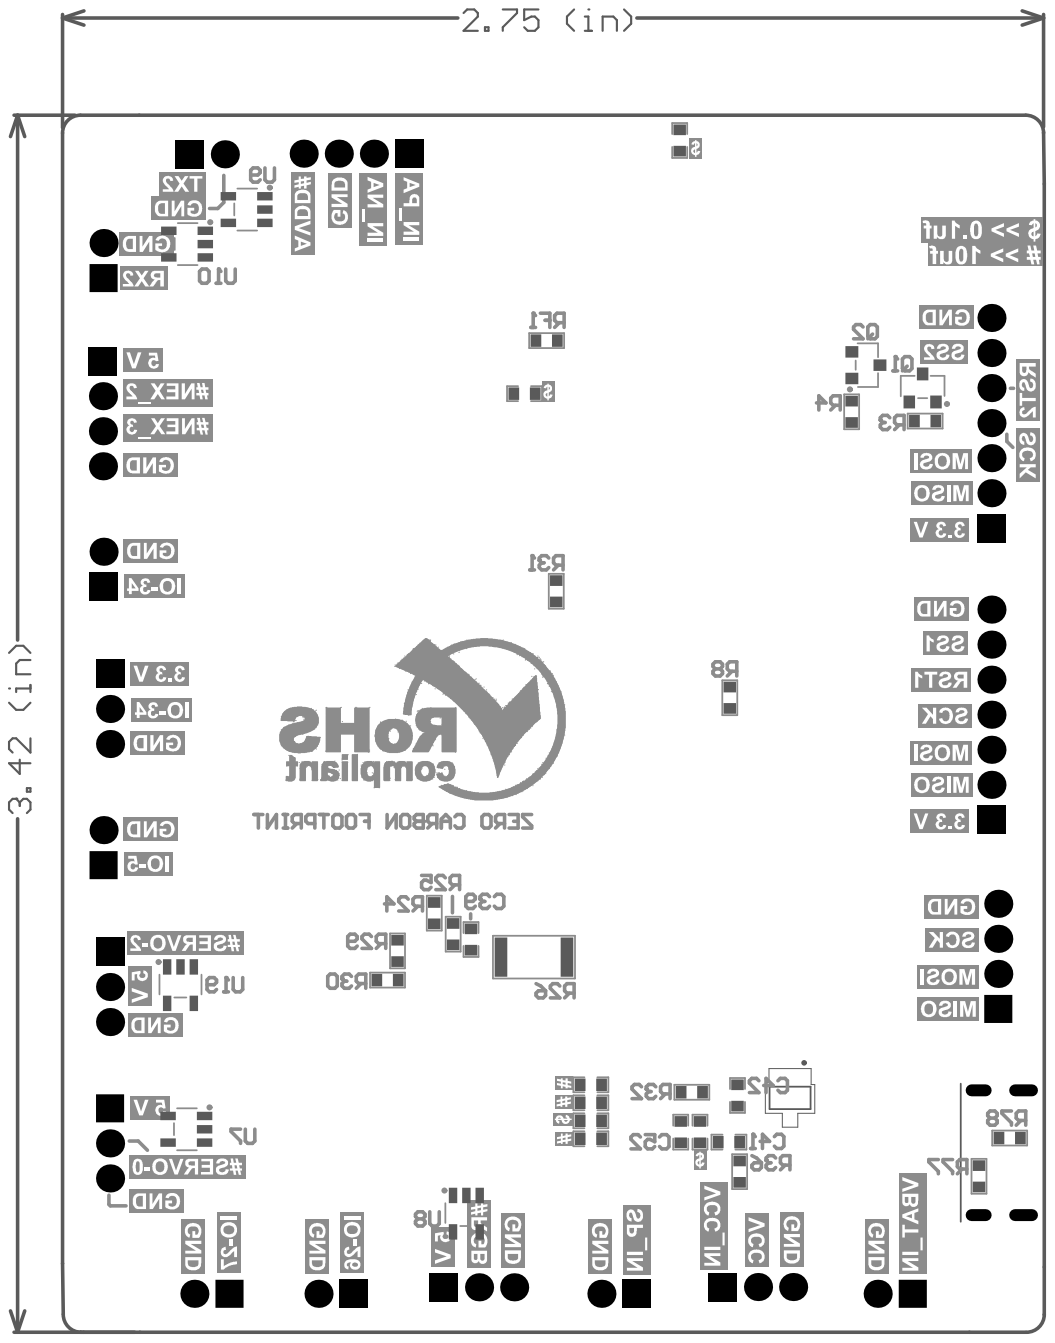
[picture p97: page 2]
