eSpark-Backup/franciscogimenez-hcdshardware/Documents/Deliverables_OB/Schematics/Optical Sensor_.pdf

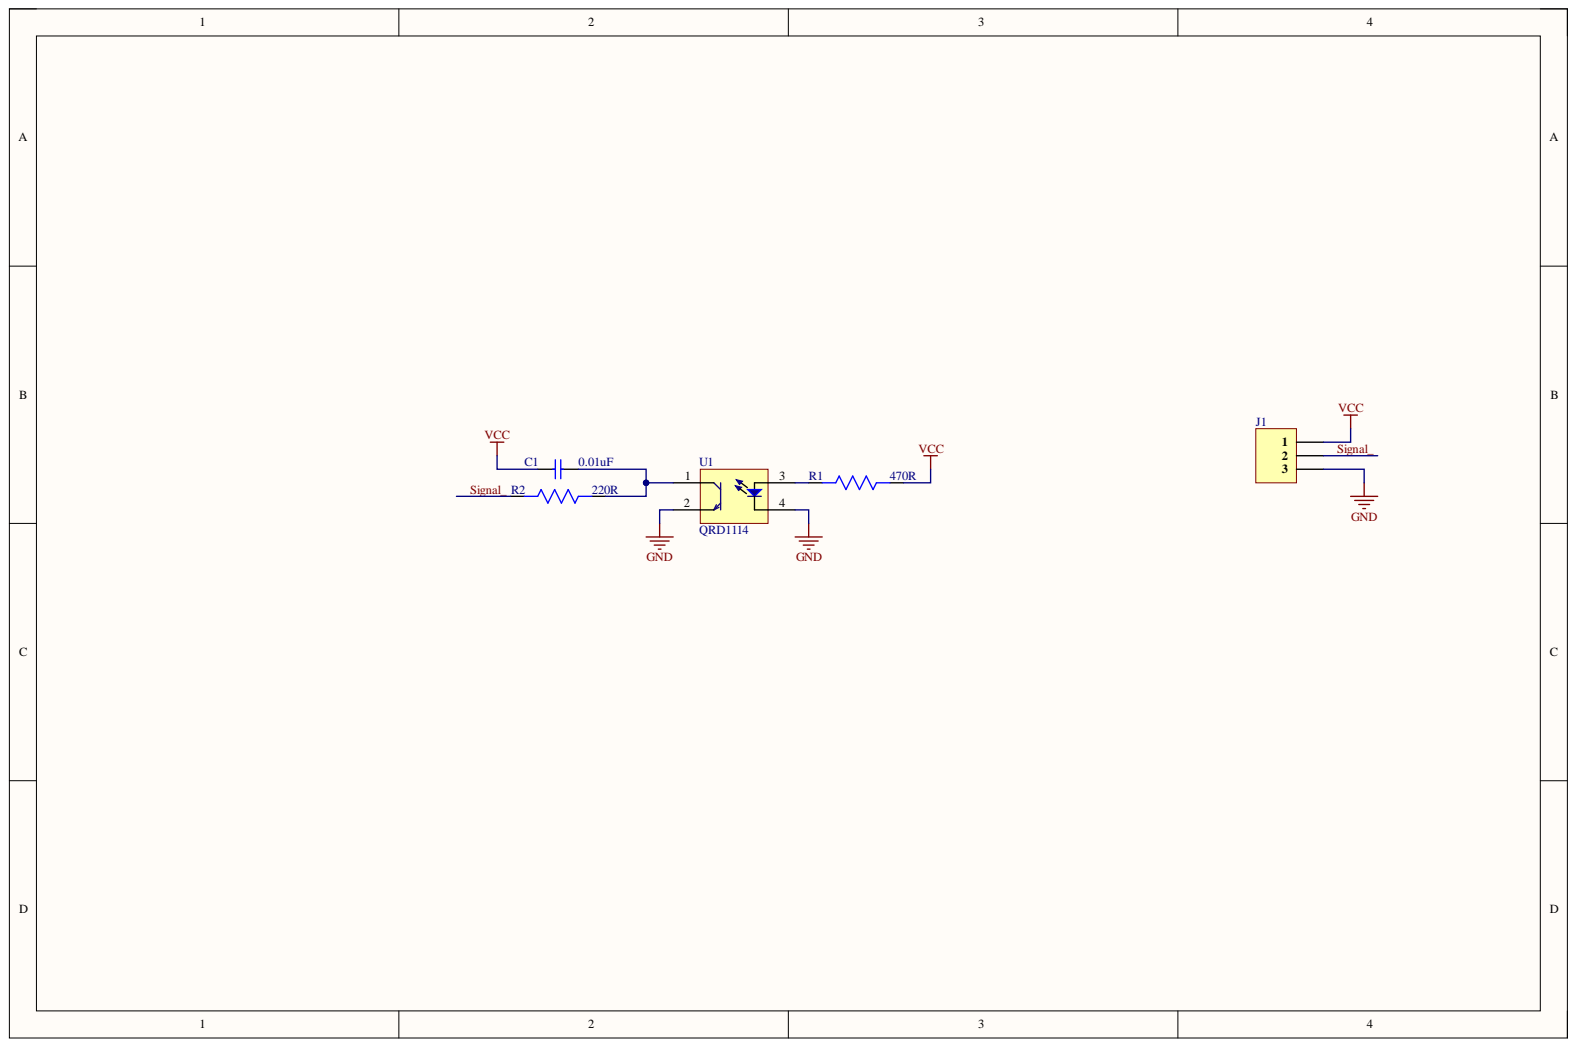
[picture p98: page 1]

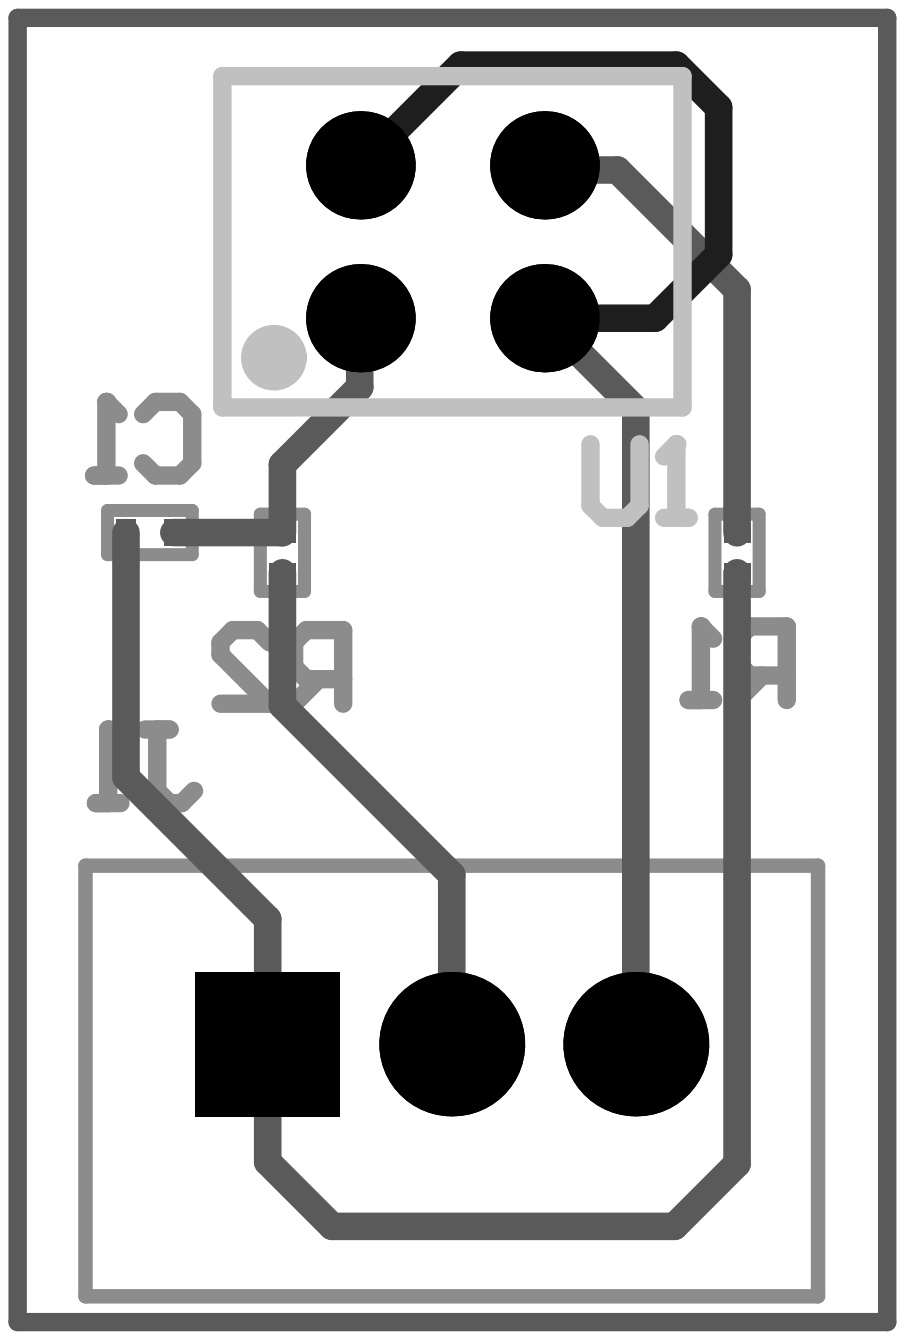
[picture p99: page 2]
