eSpark-Backup/franciscogimenez-hcdshardware/Documents/Deliverables_PB/Assembly_Drawing/Assembly_Drawing.pdf

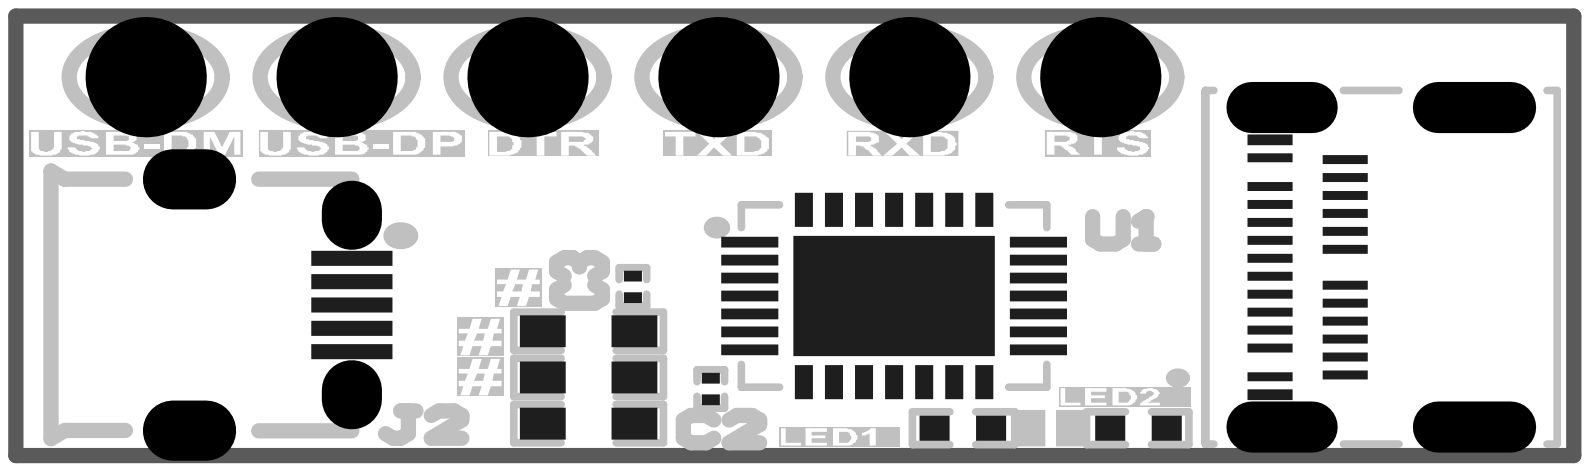
[picture p100: page 1]

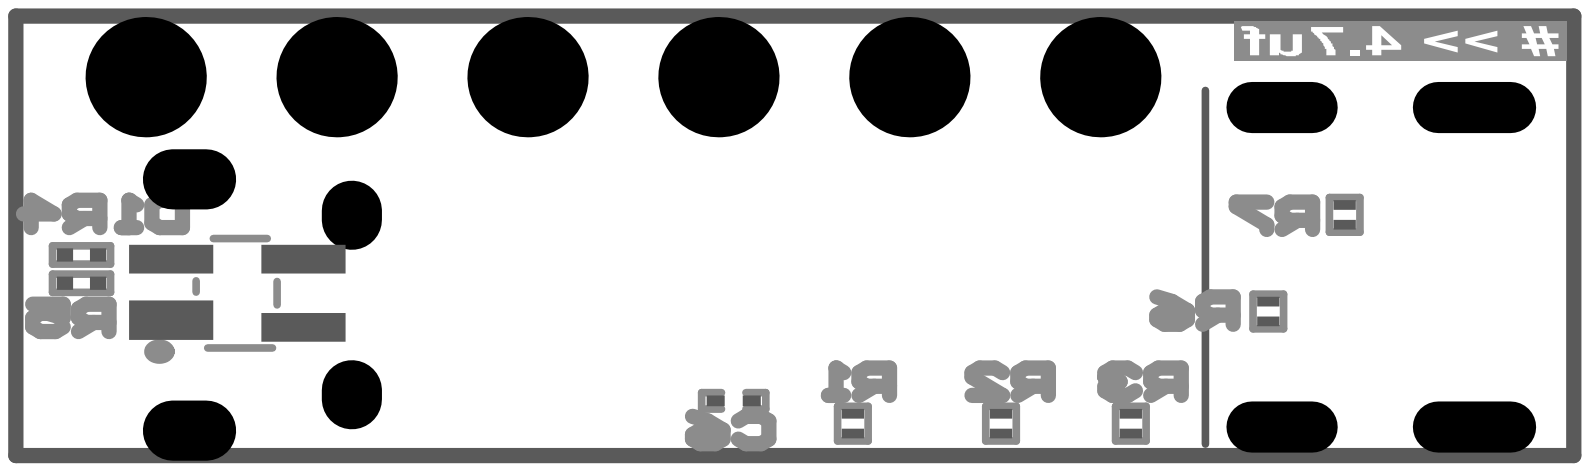
[picture p101: page 2]
