eSpark-Backup/franciscogimenez-hcdshardware/Documents/Client-Shared-Files/HairColorDispenser-master/PCB/Output Files/PDF/HairColorDispenser_PCB.PDF

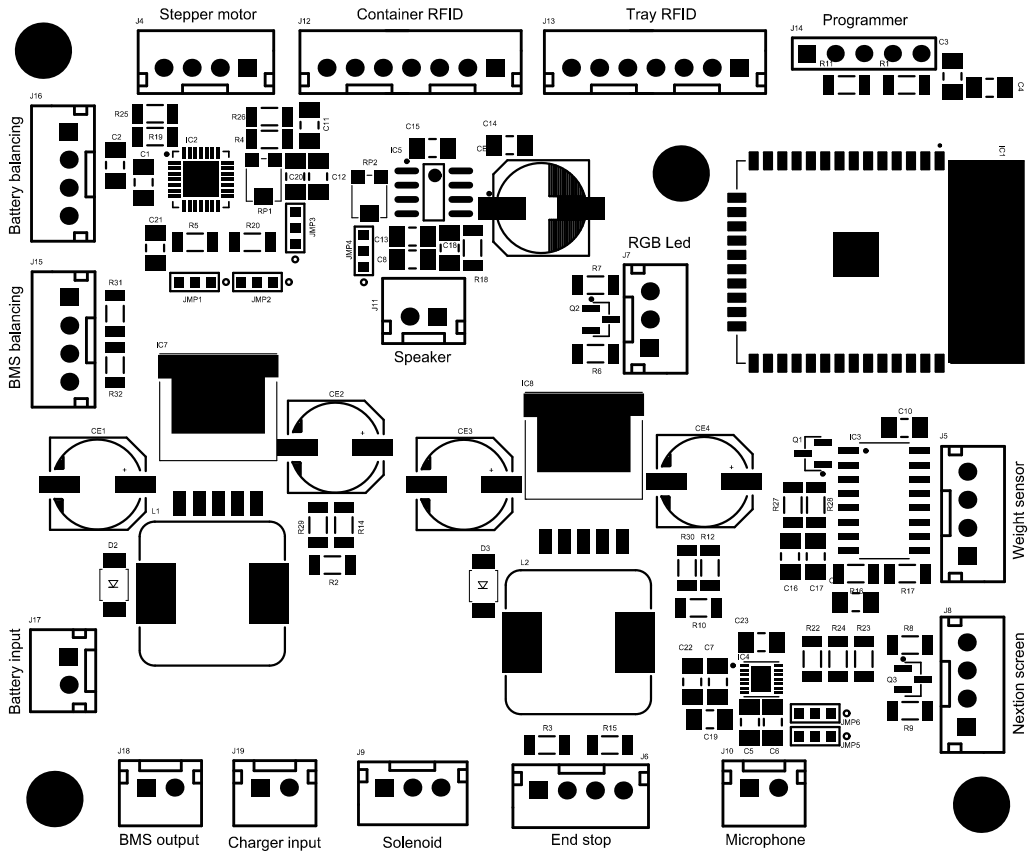
[picture p102: page 1]

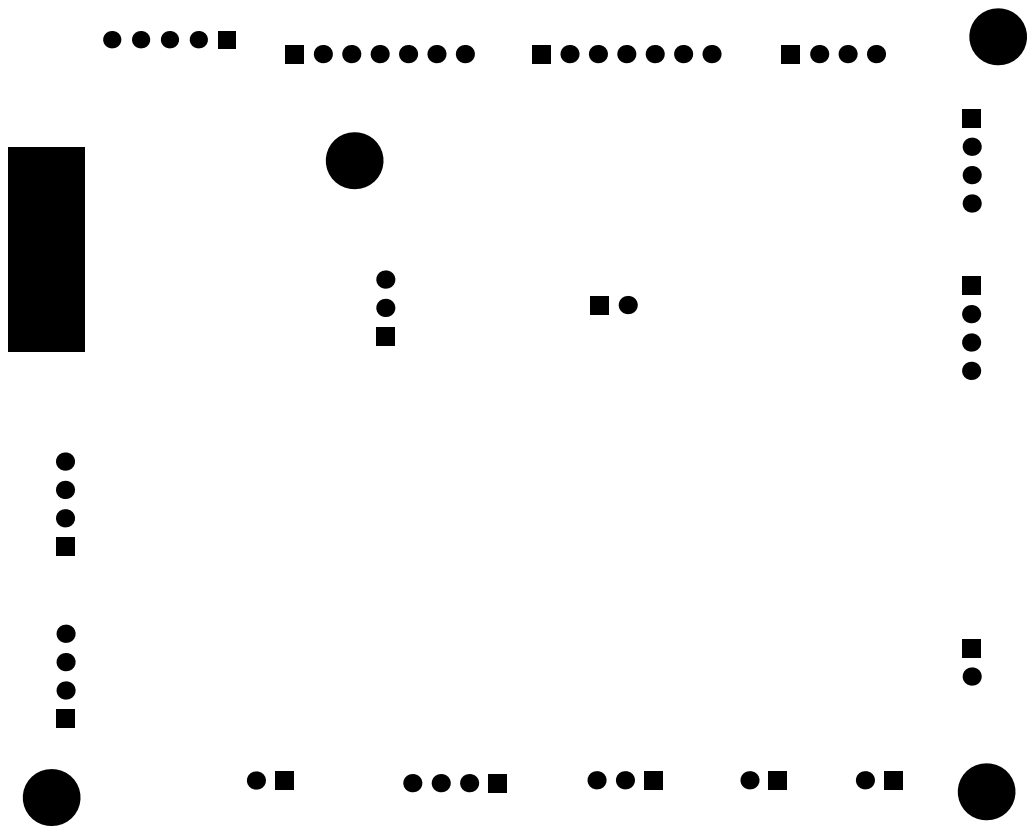
[picture p103: page 2]
