eSpark-Backup/franciscogimenez-hcdshardware/(list of files, drawings)

Other design files:
Design-Files(OB)/Main_Sheet.SchDoc
Design-Files(OB)/Optical Sensor_.PrjPcb
Design-Files(OB)/Optical_Sensor.PcbDoc
Design-Files(PB)/Connector Section.SchDoc
Design-Files(PB)/PB_PCB.PcbDoc
Design-Files(PB)/Programming-Board.PrjPcb
Design-Files(PB)/Top Sheet.SchDoc
Design-Files(PB)/USB-UART Section.SchDoc
Design-Files/Actuator_Section2.SchDoc
Design-Files/Actuator_Section.SchDoc
Design-Files/Batter_Section.SchDoc
Design-Files/Battery_Management_Section.SchDoc
Design-Files/Battery_Section.SchDoc
Design-Files/Buck_Regulator_Section.SchDoc
Design-Files/Connector_Section.SchDoc
Design-Files/Controller_Section.SchDoc
Design-Files/Francisco Gimenez.PrjPCB
Design-Files/HCD_PCB.PcbDoc
Design-Files/LiFePo_Charging_Section.SchDoc
Design-Files/MCU_Power_Section.SchDoc
Design-Files/Peripheral_Section.SchDoc
Design-Files/Peripherals.SchDoc
Design-Files/Power_Section.SchDoc
Design-Files/Sensor_Section2.SchDoc
Design-Files/Sensor_Section.SchDoc
Design-Files/Supply_Section.SchDoc
Design-Files/Top_Sheet.SchDoc
Documents/Client-Shared-Files/HairColorDispenser-master/PCB/HairColorDispenser.PrjPcb
Documents/Client-Shared-Files/HairColorDispenser-master/PCB/Project Files/HairColorDispenser.PcbDoc
Documents/Client-Shared-Files/HairColorDispenser-master/PCB/Project Files/HairColorDispenser.SchDoc
Documents/Client-Shared-Files/HairColorDispenser.PcbDoc
Documents/Client-Shared-Files/HairColorDispenser.PrjPcb
Documents/Client-Shared-Files/HairColorDispenser.SchDoc
Documents/Dev-Shared-Files/Optical-Sensor-PCB/Design Files/Main_Sheet.SchDoc
Documents/Dev-Shared-Files/Optical-Sensor-PCB/Design Files/Optical Sensor_.PrjPcb
Documents/Dev-Shared-Files/Optical-Sensor-PCB/Design Files/Optical_Sensor.PcbDoc
Library-Files(OB)/Opt_S..SchLib
Library-Files(OB)/Opt_S.PcbLib
Library-Files(PB)/PcbLib.PcbLib
Library-Files(PB)/Schlib.SchLib
Library-Files/Francisco_PCB.PcbLib
Library-Files/Francisco_Sch.SchLib
