eSpark-Backup/franciscogimenez-hcdshardware/Documents/Client-Shared-Files/ESPProject_updated/Servo_mod.h

/******************************************************************************
 * The MIT License
 *
 * Copyright (c) 2010, LeafLabs, LLC.
 *
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
 * THE SOFTWARE IS PROVIDED "AS IS", WITHOUT WARRANTY OF ANY KIND,
 * EXPRESS OR IMPLIED, INCLUDING BUT NOT LIMITED TO THE WARRANTIES OF
 * MERCHANTABILITY, FITNESS FOR A PARTICULAR PURPOSE AND
 * NONINFRINGEMENT. IN NO EVENT SHALL THE AUTHORS OR COPYRIGHT HOLDERS
 * BE LIABLE FOR ANY CLAIM, DAMAGES OR OTHER LIABILITY, WHETHER IN AN
 * ACTION OF CONTRACT, TORT OR OTHERWISE, ARISING FROM, OUT OF OR IN
 * CONNECTION WITH THE SOFTWARE OR THE USE OR OTHER DEALINGS IN THE
 * SOFTWARE.
 *****************************************************************************/

 /*
 * Arduino srl - www.arduino.org
 * Base on lib for stm32f4 (d2a4a47): https://github.com/arduino-libraries/Servo/blob/master/src/stm32f4/ServoTimers.h
 * 2017 Jul 5: Edited by Jaroslav Páral (jarekparal) - paral@robotikabrno.cz
 */
#pragma once

#include "Arduino.h"

class Servo {
    // Default min/max pulse widths (in microseconds) and angles (in
    // degrees).  Values chosen for Arduino compatibility.  These values
    // are part of the public API; DO NOT CHANGE THEM.
    static const int MIN_ANGLE = 0;
    static const int MAX_ANGLE = 180;
    
    static const int MIN_PULSE_WIDTH = 544;     // the shortest pulse sent to a servo
    static const int MAX_PULSE_WIDTH = 2400;     // the longest pulse sent to a servo
    static const int MAX_COMPARE = ((1 << 16) - 1); // 65535
    
    static const int TAU_MSEC = 20;
    static const int TAU_USEC = (TAU_MSEC * 1000);

    static const int CHANNEL_MAX_NUM = 16;

public:
    static const int CHANNEL_NOT_ATTACHED = -1;

    // Pin number of unattached pins
    static const int PIN_NOT_ATTACHED = -1;
    
    /**
     * @brief Construct a new Servo instance.
     *
     * The new instance will not be attached to any pin.
     */
    Servo();

    /**
     * @brief Destruct a Servo instance.
     *
     * Call _() and detach().
     */
    ~Servo();

     /**
     * @brief Associate this instance with a servomotor whose input is
     *        connected to pin.

     * @param pin Pin connected to the servo pulse wave input. This
     *            pin must be capable of PWM output (all ESP32 pins).
     *
     * @param channel Channel which is set to ESP32 Arduino function ledcSetup().
     *                Channel must be number between 0 - 15.
     *                It is possible to use automatic channel setup with constant
     *                Servo::CHANNEL_NOT_ATTACHED.
     * 
     * @param minAngle Target angle (in degrees) associated with
     *                 minPulseWidth.  Defaults to
     *                 MIN_ANGLE = 0.
     *
     * @param maxAngle Target angle (in degrees) associated with
     *                 maxPulseWidth.  Defaults to
     *                 MAX_ANGLE = 180.
     *  
     * @param minPulseWidth Minimum pulse width to write to pin, in
     *                      microseconds.  This will be associated
     *                      with a minAngle degree angle.  Defaults to
     *                      MIN_PULSE_WIDTH = 544.
     *
     * @param maxPulseWidth Maximum pulse width to write to pin, in
     *                      microseconds.  This will be associated
     *                      with a maxAngle degree angle. Defaults to
     *                      MAX_PULSE_WIDTH = 2400.
     *
     * @sideeffect May set pinMode(pin, PWM).
     *
     * @return true if successful, false when pin doesn't support PWM.
     */
    bool attach(int pin, int channel = CHANNEL_NOT_ATTACHED, 
                int minAngle = MIN_ANGLE, int maxAngle = MAX_ANGLE, 
                int minPulseWidth = MIN_PULSE_WIDTH, int maxPulseWidth = MAX_PULSE_WIDTH);

    /**
     * @brief Stop driving the servo pulse train.
     *
     * If not currently attached to a motor, this function has no effect.
     *
     * @return true if this call did anything, false otherwise.
     */
    bool detach();

    /**
     * @brief Set the servomotor target angle.
     *
     * @param angle Target angle, in degrees.  If the target angle is
     *              outside the range specified at attach() time, it
     *              will be clamped to lie in that range.
     *
     * @see Servo::attach()
     */
    void write(int degrees);

    /**
     * @brief Set the pulse width, in microseconds.
     *
     * @param pulseWidth Pulse width to send to the servomotor, in
     *                   microseconds. If outside of the range
     *                   specified at attach() time, it is clamped to
     *                   lie in that range.
     *
     * @see Servo::attach()
     */
    void writeMicroseconds(int pulseUs);

    /**
     * Get the servomotor's target angle, in degrees.  This will
     * lie inside the range specified at attach() time.
     *
     * @see Servo::attach()
     */
    int read();

    /**
     * Get the current pulse width, in microseconds.  This will
     * lie within the range specified at attach() time.
     *
     * @see Servo::attach()
     */
    int readMicroseconds();
    
    /**
     * @brief Check if this instance is attached to a servo.
     * @return true if this instance is attached to a servo, false otherwise.
     * @see Servo::attachedPin()
     */
    bool attached() const;

    /**
     * @brief Get the pin this instance is attached to.
     * @return Pin number if currently attached to a pin, PIN_NOT_ATTACHED
     *         otherwise.
     * @see Servo::attach()
     */
    int attachedPin() const;


private:
    void _resetFields(void);

    int _usToDuty(int us)    { return map(us, 0, TAU_USEC, 0, MAX_COMPARE); }
    int _dutyToUs(int duty)  { return map(duty, 0, MAX_COMPARE, 0, TAU_USEC); }
    int _usToAngle(int us)   { return map(us, _minPulseWidth, _maxPulseWidth, _minAngle, _maxAngle); }
    int _angleToUs(int angle){ return map(angle, _minAngle, _maxAngle, _minPulseWidth, _maxPulseWidth); }

    static int channel_next_free;

    int _pin;
    int _pulseWidthDuty;
    int _channel;
    int _min, _max;
    int _minPulseWidth, _maxPulseWidth;
    int _minAngle, _maxAngle;
};
