eSpark-Backup/franciscogimenez-hcdshardware/Documents/Client-Shared-Files/HairColorDispenser-master/Firmware/src/Pinout.h

#ifndef PINOUT_H
#define PINOUT_H

// HX711 weight scale pinout
#define LOADCELL_DOUT_PIN   32
#define LOADCELL_SCK_PIN    33

// MFRC522 Rfid card reader pinout
#define TRAY_SS_PIN             2
#define TRAY_RST_PIN            15
#define CONTAINER_SS_PIN        5
#define CONTAINER_RST_PIN       22

// Fire pin pinout
#define FIRE_PIN                27

// Optical sensor
#define OPTICAL_SENSOR_PIN          35
#define OPTICAL_SENSOR_DIODE_PIN    34

// NeoPixel WS2812B pinout
#define NEOPIXEL_PIN            26

#endif // PINOUT_H
