eSpark-Backup/franciscogimenez-hcdshardware/(commit log)

2021-07-14 Final Files and Deliverables
    [Actuator_Section.SchDoc, Actuator_Section2.SchDoc, BOM_LCSC_Core.xlsx, BOM_PCBWay.xlsx, Battery_Management_Section.SchDoc, Connector Section.SchDoc, Connector_Section.SchDoc, Controller_Section.SchDoc]
2021-07-26 Programming board USB connections corrected.
    [Connector Section.SchDoc, Programming-Board.PrjPcb, Top Sheet.SchDoc, USB-UART Section.SchDoc]
2021-07-28 Gerber Files added obsolete folder.
    [BOM_PCBWay (1).xlsx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]
2021-11-17 hierarchy, netlabels & sections updated.
    [Actuator_Section.SchDoc, Actuator_Section2.SchDoc, Batter_Section.SchDoc, Battery_Management_Section.SchDoc, Buck_Regulator_Section.SchDoc, Connector_Section.SchDoc, Controller_Section.SchDoc, Francisco Gimenez.PrjPCB]
2021-11-19 Schematic formatted. Netlabels modified. Text box added.
    [Actuator_Section.SchDoc, Actuator_Section2.SchDoc, Batter_Section.SchDoc, Battery_Management_Section.SchDoc, Battery_Section.SchDoc, Buck_Regulator_Section.SchDoc, Connector_Section.SchDoc, Controller_Section.SchDoc]
2021-11-19 Project Settings modified
    [Actuator_Section.SchDoc, Actuator_Section2.SchDoc, Battery_Management_Section.SchDoc, Battery_Section.SchDoc, Buck_Regulator_Section.SchDoc, Connector_Section.SchDoc, Controller_Section.SchDoc, Francisco Gimenez.PrjPCB]
2021-11-20 added a note for possible additions. Compile errors removed.
    [Buck_Regulator_Section.SchDoc, Connector_Section.SchDoc, Controller_Section.SchDoc, LiFePo_Charging_Section.SchDoc, MCU_Power_Section.SchDoc, Peripheral_Section.SchDoc, Power_Section.SchDoc, Top_Sheet.SchDoc]
2021-11-29 Changes done as per issue #5 and #6.
    [Actuator_Section.SchDoc, Actuator_Section2.SchDoc, Controller_Section.SchDoc, Francisco_PCB.PcbLib, Francisco_Sch.SchLib, MCU_Power_Section.SchDoc, Peripheral_Section.SchDoc, Sensor_Section.SchDoc]
2021-12-02 DigiKey BOM revised after design changes.
    [Digikey_BOM.xlsx, Francisco Gimenez.xlsx]
2021-12-03 PCB updated According to changes
    [Buck_Regulator_Section.SchDoc, Controller_Section.SchDoc, Francisco_PCB.PcbLib, Francisco_Sch.SchLib, HCD_PCB.PcbDoc, LiFePo_Charging_Section.SchDoc, MCU_Power_Section.SchDoc, Power_Section.SchDoc]
2021-12-04 PCB Routing
    [Actuator_Section.SchDoc, Actuator_Section2.SchDoc, Controller_Section.SchDoc, HCD_PCB.PcbDoc, Sensor_Section.SchDoc, Top_Sheet.SchDoc]
